LF2L/Green-FabLab/Images/Material/Tamisage/2019-05-12-0001.jpg

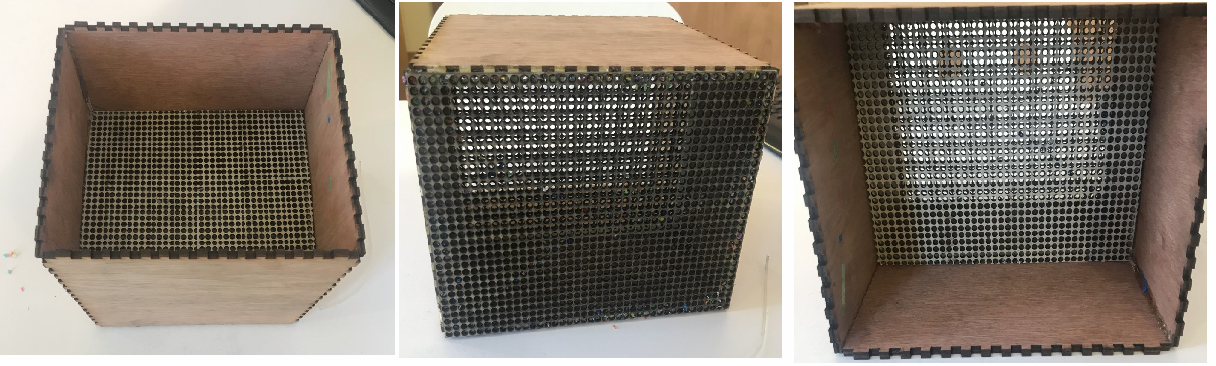
Images/Material/Tamisage/2019-05-12-0001.jpg
