LF2L/Green-FabLab/README.md

# Green-FabLab
Repository with documents and in order to develop the Green FabLab at LF2L
