LF2L/Green-FabLab/Documents/Posters/3-Eudes.pdf

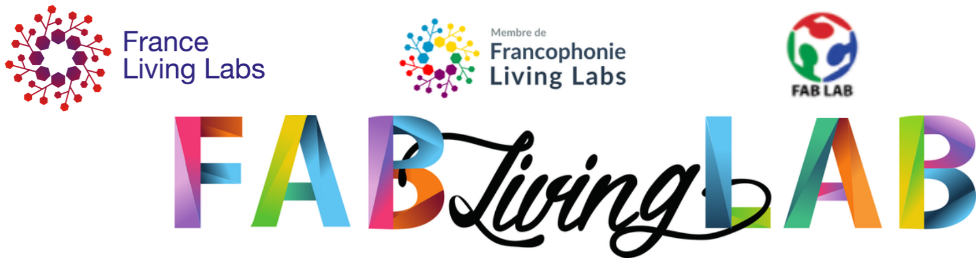
[picture p68: figure]

Comment automatiser et garantir une fiabilité du processus d’extrusion de granules de PLA recyclées ?

Aujourd’hui, l’impression 3D se démocratise et prend une part importante dans la nouvelle forme de production. Basée sur la fabrication additive (fines couches déposées une à une), les imprimantes 3D permettent d'avoir des délais de fabrications courts avec des formes complexes et sans nécessiter d'une fabrication de moules au préalable. Cette technologie dite « open source » consomme de la matière plastique vierge. Cependant, à l’heure actuelle, le problème des déchets plastiques est un enjeu majeur pour l’Europe et le monde. Le Lorraine Fab Living Lab, en concordance avec les directives européennes qui visent une économie circulaire a moyen terme, adopte une démarche verte et durable. Le souhait est de réutiliser ce plastique en le recyclant et en le régénérant sous forme de fil adéquate aux imprimantes 3D.

# Introduction

# 1. Objectifs et structure du projet

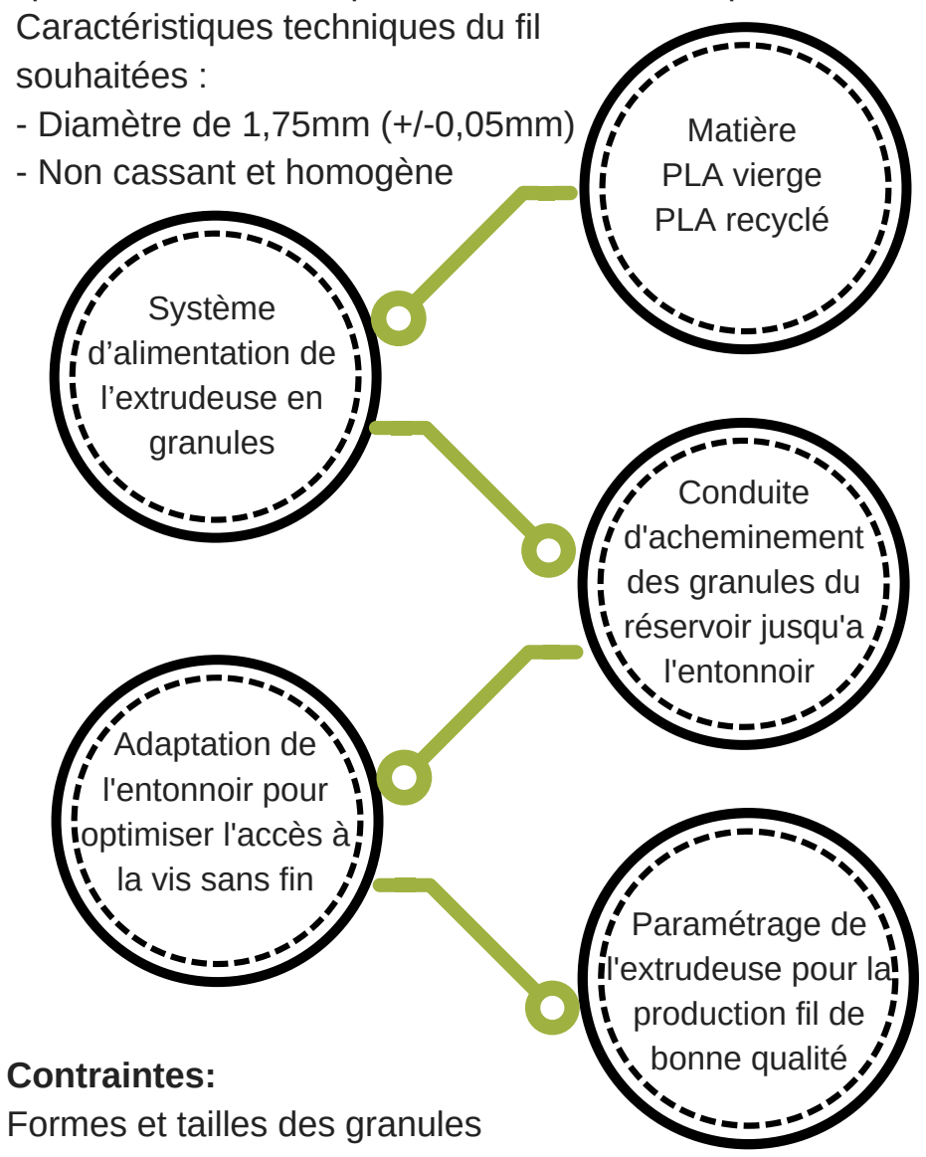
[picture p69: figure]
Système d’alimentation de l’extrudeuse en granules; Conduite d'acheminement des granules du réservoir jusqu'a l'entonnoir; Matière PLA vierge PLA recyclé; Adaptation de l'entonnoir pour optimiser l'accès à la vis sans fin; Paramétrage de l'extrudeuse pour la production fil de bonne qualité; Caractéristiques techniques du fil souhaitées : - Diamètre de 1,75mm (+/-0,05mm) - Non cassant et homogène; Contraintes: Formes et tailles des granules

# 2. Prise en main de l’extrudeuse

# 3. Modification du prototype

# 4. Résultats

Fiabiliser le processus de recyclage en garantissant la qualité de la matière première destinée à l'impression 3D.

Température importante à l’entrée de la chambre de la vis sans fin due à la conduction importante
Inclinaison de l’extrudeuse et forme de la bouche d’admission
Utilisation de ressources propres à un espace d'innovation Durée de l'étude (5 semaines d'Initiation à la Recherche) a) Changement de réservoir:

Réservoir avec un angle plus aigu afin de diminuer la contrainte mécanique latérale appliquée aux granules

Volume plus important afin de permettre une plus grande autonomie

b) Modification du bouchon de réservoir:
e) Mise un place d'un ventilateur 12V CC:

Ventilateur permettant de dissiper la chaleur transmise (conduction) par les résistantes chauffantes au niveau de l'entrée de la vis sans fin

Étude statistique:
Réalisée avec 1kg
de granules
Débit non linéaire
Démontre l'intérêt de
la présence d'une
LED et d'une
photorésistance

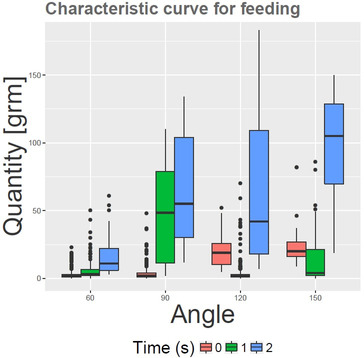
[picture p70: figure]

1ère bobine de fil extrudé 2ème bobine de fil extrudé

Impression 3D (test)

Présence de nombreuses
imperfections
T1: 165°C T2: 155°C
T3: 150°C V: 5rpm

Peu d'imperfections
présentes
T1: 170°C T2: 165°C
T3: 150°C V: 5rpm

Réalisation d'un modèle test avec l'imprimante 3D et la 2ème bobine de fil. C'est un succès!

Filtrer les
granules
recyclés

Rupture de
ponts
thermiques

Contrôle du
flux d'air

Lecture réelle
des
températures

Maintien du fil
dans l'axe du
capteur de
niveau

Canalisation d'acheminement des granules qui s'adapte aux différentes positions

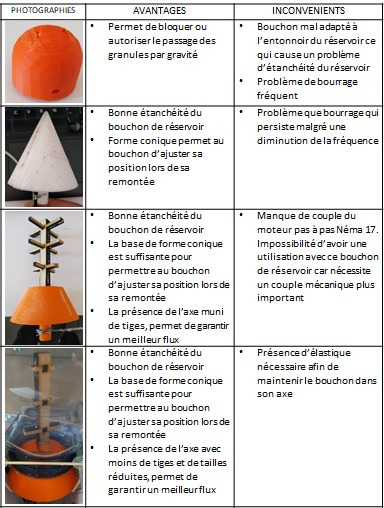
[picture p71: figure]

c) Positionnement moteur et transmission de force mécanique:
Utilisation de la rotation du moteur électrique pour réaliser un mouvement de translation (principe bielle -piston)
d) Modification de l'entonnoir:

Adapté à l'inclinaison de
l'extrudeuse (60°)
Optimisation de l'utilisation de la surface d'absorption des granules

Observations concernant le PLA recyclé:
Bourrages fréquents des granules dans le réservoir et mauvaise étanchéité du bouchon existant

Formation de blocs de granules sous l'effet de la température

Structure de l'entonnoir ne permettant pas une répartition optimale des granules au niveau de la bouche d'accès à la vis sans fin

Auteur : Eudes LE MAISTRE- eudes.lemaistre@viacesi.fr

# 6.Conclusion

# 5. Axes d'amélioration

# 7.Bibliographie

DropBox greenFablab. [En ligne]. https://www.dropbox.com/home/GreenFablab/Bibliography
BBFil. Extrudeuse Xcalibur. [En ligne]. http://www.bbfil.fr/extrudeuse-xcalibur-c2x22857729
noztek. noztek-xcalibur-manual. [En ligne]. http://www.noztek.com/wp-content/uploads/2015/09/noztek-xcalibur-manual.pdf

Le prototype a été modifié et optimisé afin de le rendre opérationnel. Aujourd'hui la régulation du débit est maîtrisée et les premières bobines de filaments 100% recyclés sont extrudées. Le prototype doit être consolidé d'avantage et son ergonomie est à améliorer. Un tamisage en sortie de broyeuse s'avère utile car le réglage des paramètres d'utilisation dépend fortement de la granulométrie du PLA recyclé.
Mettre en place une procédure de contrôle de la qualité du fil extrudé de façon à classifier ce dernier et à déterminer les paramétrages optimums de l'extrudeuse. A terme, le but est d’instaurer une norme qualité des fils extrudés à partir de PLA recyclé.
