LF2L/Green-FabLab/Concept Ideas/FicheIdéeStructure.pdf

### Connaissances, besoins ou problématique ayant donnés lieu à cette idée:

Le FabLivingLab souhaite pouvoir exposer le projet « Extrudeuse ». Cela nécessite une structure

Nom de l’idée : | Structure N°1

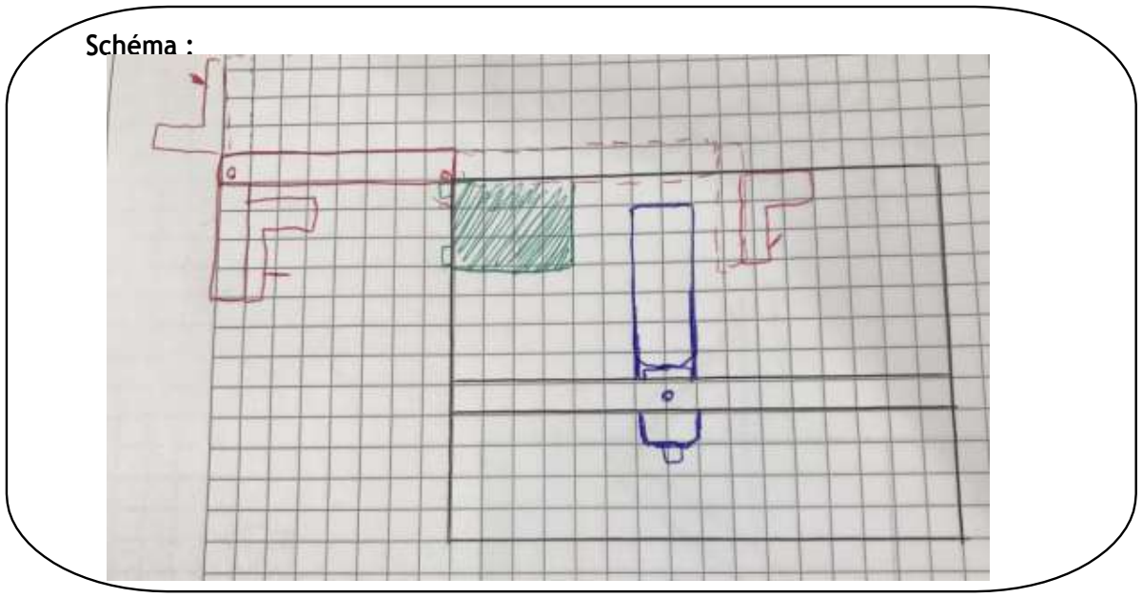
[picture p73: figure]
Schéma :
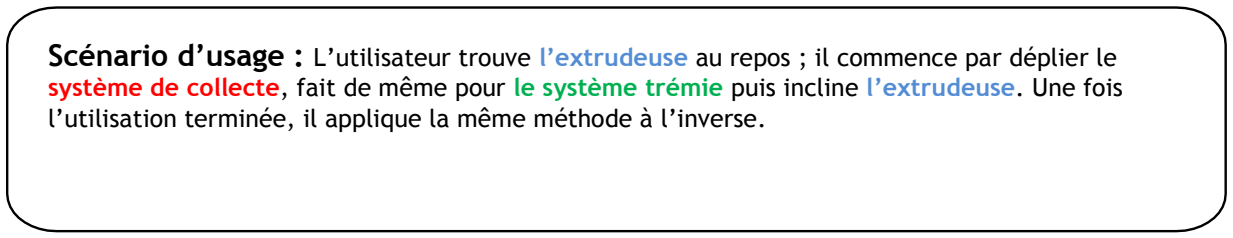
[picture p74: figure]

+ | -

Problématique : Comment optimiser l’ergonomie et l’esthétisme de la structure sans diminuer

Description : La structure doit permettre au système d’alterner entre deux positions :
« Repos » et « Fonctionnement ». L’extrudeuse serait réorientable à 90° de manière à occuper le moins de place possible. Le système de collecte serait repliable sur le dessus de la structure par le biais de charnières. Le système Trémie serait repliable sur le côté de la structure.

Scénario d’usage : L’utilisateur trouve l’extrudeuse au repos ; il commence par déplier le système de collecte, fait de même pour le système trémie puis incline l’extrudeuse. Une fois l’utilisation terminée, il applique la même méthode à l’inverse.

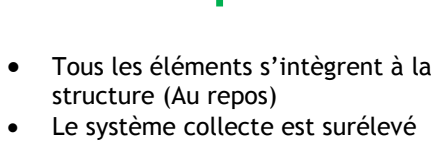
[picture p75: figure]
• Tous les éléments s’intègrent à la structure (Au repos) • Le système collecte est surélevé

- Le système collecte exerce une contrainte importante sur son point d’accroche avec la structure

### Connaissances, besoins ou problématique ayant donnés lieu à cette idée:

Le FabLivingLab souhaite pouvoir exposer le projet « Extrudeuse ». Cela nécessite une structure

Nom de l’idée : | Structure N°2

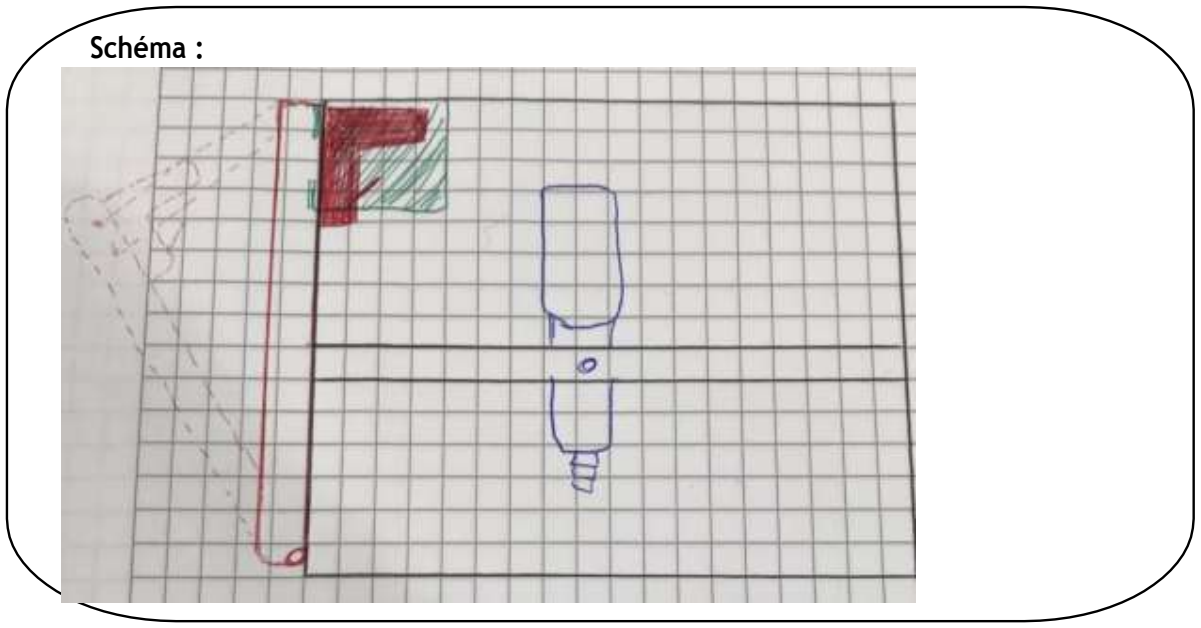
[picture p76: figure]
Schéma :

+ | -

Problématique : Comment optimiser l’ergonomie et l’esthétisme de la structure sans diminuer

Description : La structure doit permettre au système d’alterner entre deux positions : « Repos » et « Fonctionnement ». L’extrudeuse serait réorientable à 90° de manière à occuper le moins de place possible. Le système de collecte serait repliable sur l’avant de la structure (par le biais de charnières) et retenue par une ficelle. Le système Trémie serait repliable sur le côté extérieur de la structure afin de ne pas gêner le système collecte.

Scénario d’usage : L’utilisateur trouve l’extrudeuse au repos ; il commence par déplier le système de collecte, fait de même pour le système trémie puis incline l’extrudeuse. Une fois l’utilisation terminée, il applique la même méthode à l’inverse.

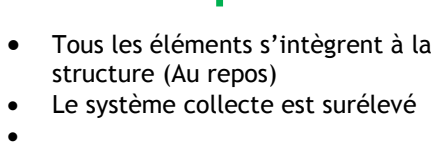
[picture p77: figure]
• Tous les éléments s’intègrent à la structure (Au repos) • Le système collecte est surélevé •
