LF2L/Green-FabLab/Concept Ideas/Fichesidées Système de collecte.pdf

### Connaissances, besoins ou problématique ayant donnés lieu à cette idée:

La partie « enrouleur » doit s’intégrer de manière ergonomique au support (de manière à être facilement transportable). Il doit cependant se situer à une certaine distance (inconnue à l’heure actuelle) de la sortie de l’extrudeuse afin d’optimiser l’enroulement.

Nom de l’idée :

Problématique : Comment optimiser l’ergonomie et le fonctionnement de la partie
« Enrouleur » ?

Support Enrouleur n°1

### Schéma :

Description: Le système consiste en un rail qui permet à l’enrouleur d’alterner entre deux positions : -une position d’utilisation (devant la sortie de l’extrudeuse)
-une position de « repos » (sous l’extrudeuse)

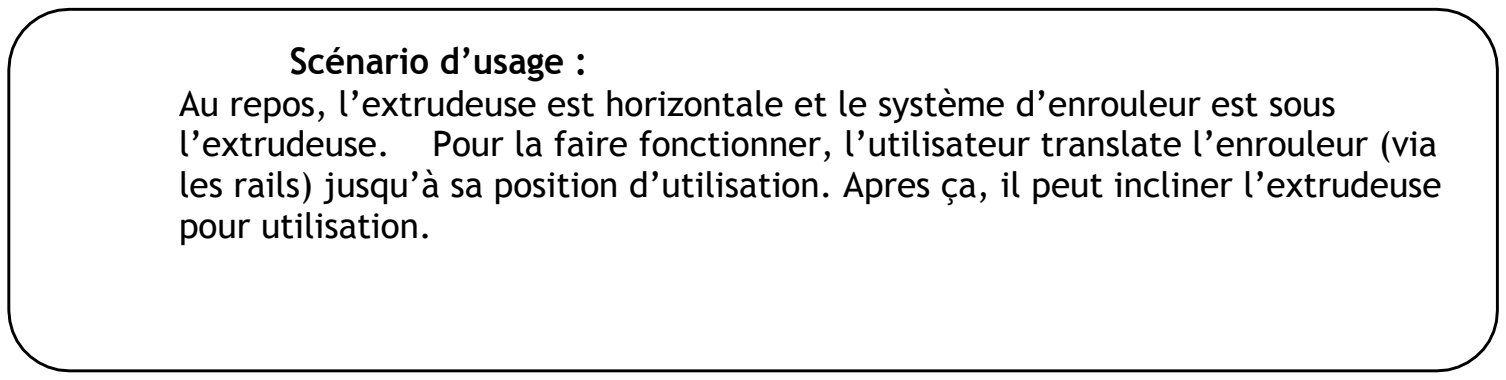
[picture p78: figure]
Scénario d’usage :; pour utilisation.

Au repos, l’extrudeuse est horizontale et le système d’enrouleur est sous l’extrudeuse. Pour la faire fonctionner, l’utilisateur translate l’enrouleur (via les rails) jusqu’à sa position d’utilisation. Apres ça, il peut incliner l’extrudeuse

+ | - • Alignement fixe • Pas de position « repos » quand l’extrudeuse est à 60°

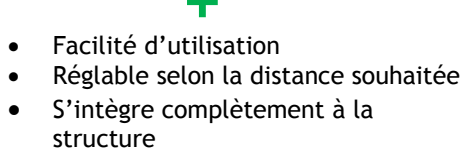
[picture p79: figure]
• Facilité d’utilisation • Réglable selon la distance souhaitée • S’intègre complètement à la structure

### Connaissances, besoins ou problématique ayant donnés lieu à cette idée:

La partie « enrouleur » doit s’intégrer de manière ergonomique au support (de manière à être facilement transportable). Il doit cependant se situer à une certaine distance (inconnue à l’heure actuelle) de la sortie de l’extrudeuse afin d’optimiser l’enroulement.

Nom de l’idée :

Problématique : Comment optimiser l’ergonomie et le fonctionnement de la partie
« Enrouleur » ?

Support Enrouleur n°2

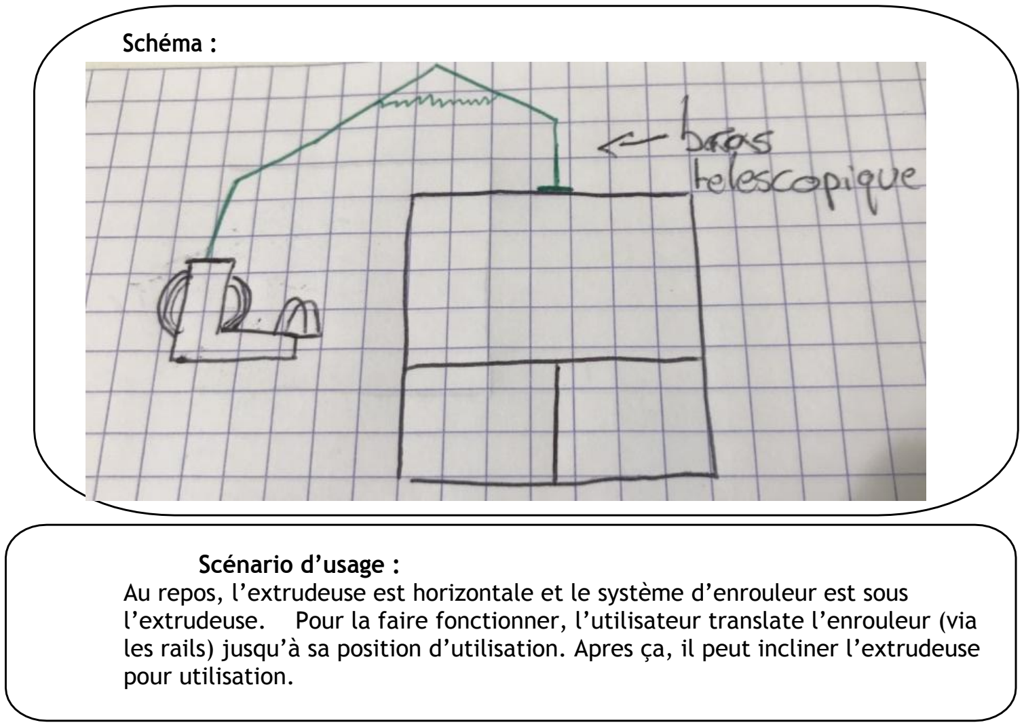
[picture p80: figure]
Schéma :; Scénario d’usage :; pour utilisation.

Au repos, l’extrudeuse est horizontale et le système d’enrouleur est sous l’extrudeuse. Pour la faire fonctionner, l’utilisateur translate l’enrouleur (via les rails) jusqu’à sa position d’utilisation. Apres ça, il peut incliner l’extrudeuse

Description: Le système consiste en un support amovible (par le biais d’un bras articulé) qui permet à l’enrouleur d’alterner entre deux positions :
-une position d’utilisation (devant la sortie de l’extrudeuse)
-une position de « repos » (sous l’extrudeuse)

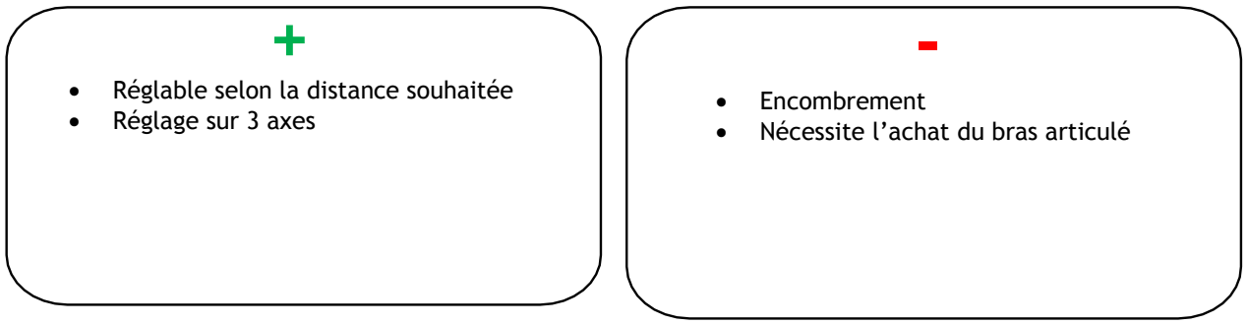
[picture p81: figure]
• Réglable selon la distance souhaitée • Réglage sur 3 axes; • Encombrement • Nécessite l’achat du bras articulé

### Connaissances, besoins ou problématique ayant donnés lieu à cette idée:

La partie « enrouleur » doit s’intégrer de manière ergonomique au support (de manière à être facilement transportable). Il doit cependant se situer à une certaine distance (inconnue à l’heure actuelle) de la sortie de l’extrudeuse afin d’optimiser l’enroulement.

Nom de l’idée :

Problématique : Comment optimiser l’ergonomie et le fonctionnement de la partie
« Enrouleur » ?

Support Enrouleur n°3

### Schéma :

Description: Le système consiste en un support amovible qui permet à l’enrouleur d’alterner entre deux positions :
-une position d’utilisation (devant la sortie de l’extrudeuse)
-une position de « repos » (sous l’extrudeuse)

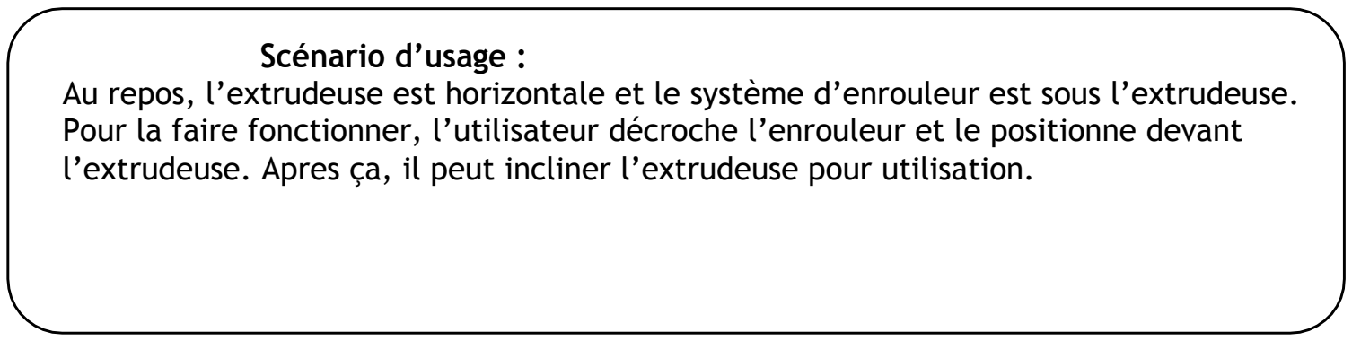
[picture p82: figure]
Scénario d’usage :

Au repos, l’extrudeuse est horizontale et le système d’enrouleur est sous l’extrudeuse. Pour la faire fonctionner, l’utilisateur décroche l’enrouleur et le positionne devant l’extrudeuse. Apres ça, il peut incliner l’extrudeuse pour utilisation.

+ | -
Position “repos” | Position “fonctionnement”

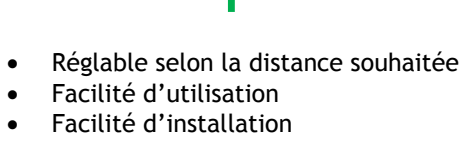
[picture p83: figure]
• Réglable selon la distance souhaitée • Facilité d’utilisation • Facilité d’installation

- Totalement libre en position d’utilisation (possibilité d’oubli)
- Pas de position « repos » quand l’extrudeuse est à 60°

### Connaissances, besoins ou problématique ayant donnés lieu à cette idée:

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

Nom de l’idée :

Problématique : Comment optimiser l’ergonomie et le fonctionnement de la partie
« Enrouleur » ?

Support Enrouleur n°4

### Schéma :

Description: Le système consiste en un support amovible (par le biais de charnières) qui permet à l’enrouleur d’alterner entre deux positions :
-une position d’utilisation (devant la sortie de l’extrudeuse)
-une position de « repos » (sous l’extrudeuse)

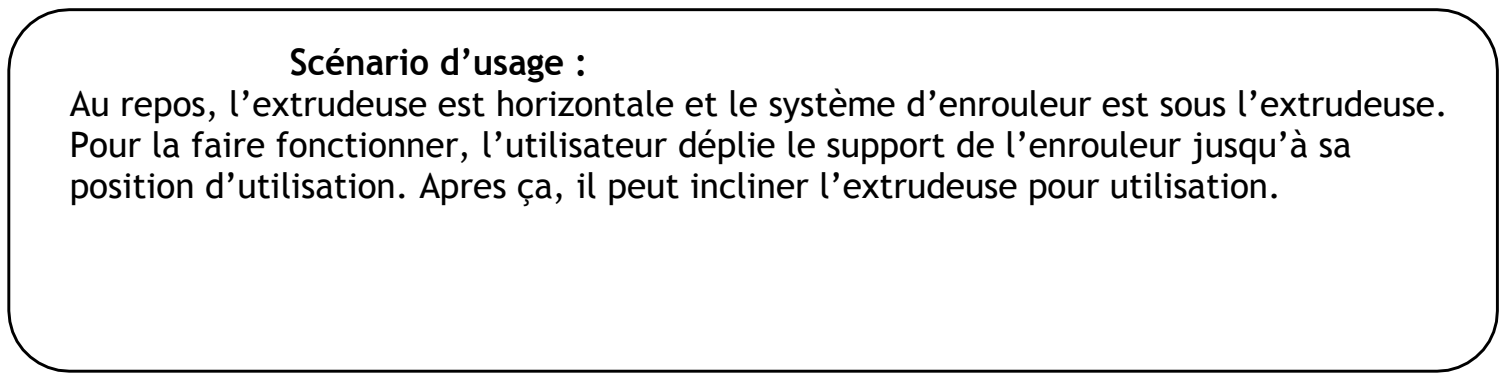
[picture p84: figure]
Scénario d’usage :

Au repos, l’extrudeuse est horizontale et le système d’enrouleur est sous l’extrudeuse. Pour la faire fonctionner, l’utilisateur déplie le support de l’enrouleur jusqu’à sa position d’utilisation. Apres ça, il peut incliner l’extrudeuse pour utilisation.

+ | - • Pas de position « repos » quand l’extrudeuse est à 60° • Impossibilité d’alterner les positions dans un espace étroit

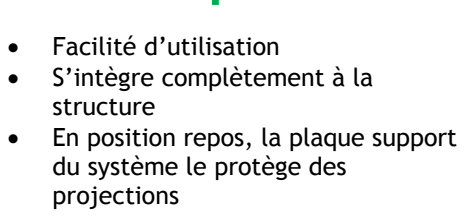
[picture p85: figure]
• Facilité d’utilisation • S’intègre complètement à la structure • En position repos, la plaque support du système le protège des projections

### Connaissances, besoins ou problématique ayant donnés lieu à cette idée:

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

Nom de l’idée :

Problématique : Comment optimiser l’ergonomie et le fonctionnement de la partie
« Enrouleur » ?

Support Enrouleur n°5

Description: Le système consiste en un support amovible (par le biais de charnières) qui permet à l’enrouleur d’alterner entre deux positions :
-une position d’utilisation (devant la sortie de l’extrudeuse)
-une position de « repos » (sur le support de l’extrudeuse)

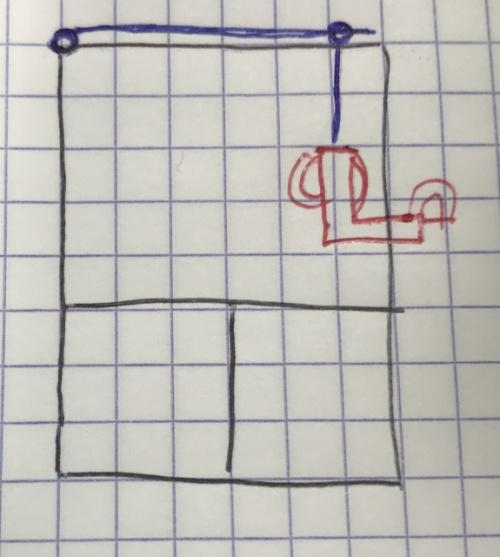
[picture p86: figure]
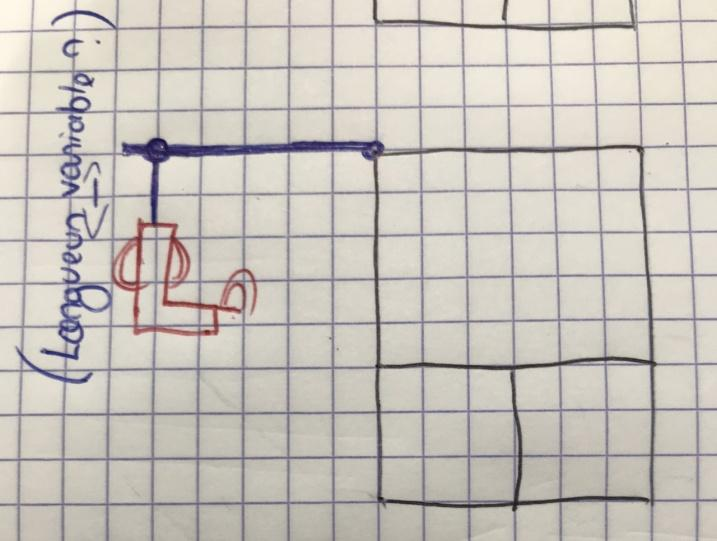
[picture p87: figure]
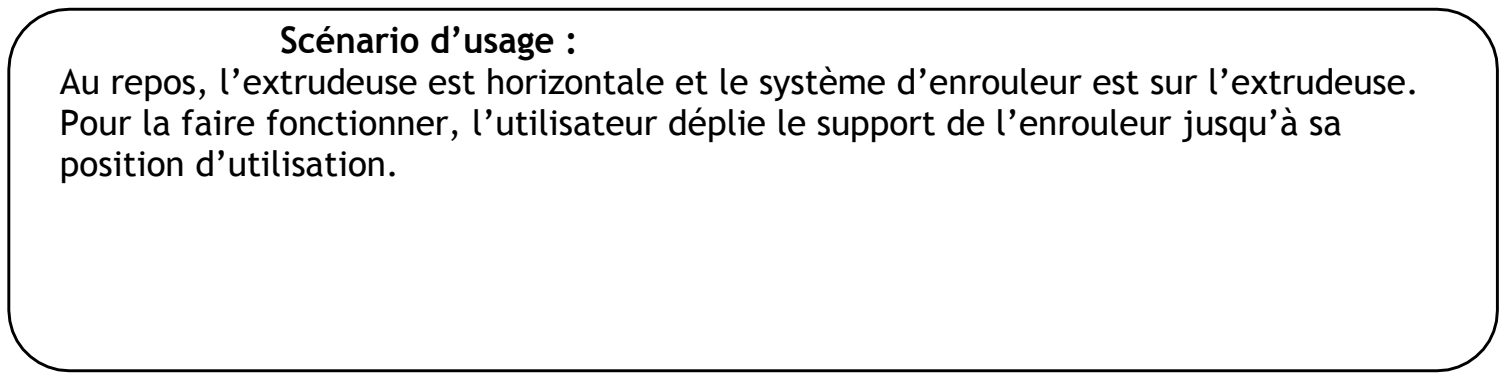
[picture p88: figure]
Scénario d’usage :; position d’utilisation.

Au repos, l’extrudeuse est horizontale et le système d’enrouleur est sur l’extrudeuse. Pour la faire fonctionner, l’utilisateur déplie le support de l’enrouleur jusqu’à sa

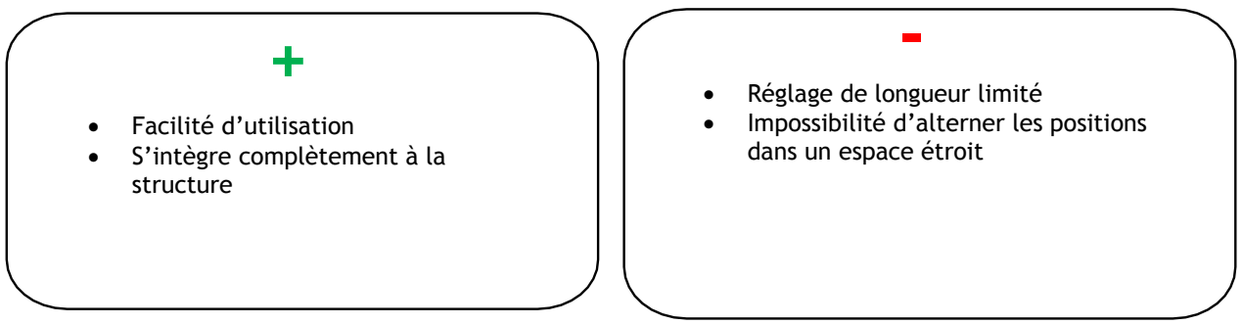
[picture p89: figure]
• Facilité d’utilisation • S’intègre complètement à la structure; • Réglage de longueur limité • Impossibilité d’alterner les positions dans un espace étroit
