LF2L/Green-FabLab/Documents/Posters/2-Nicolas-Maxime.pdf

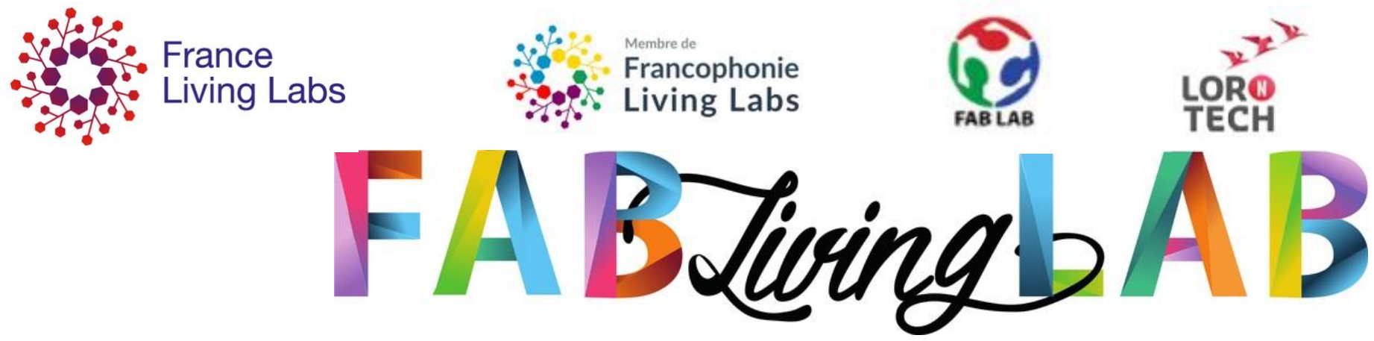
[picture p122: figure]

# Commentalimenterdefaçonautonomeuneextrudeuseengranulésplastiques recycléspour la fabrication de filament d’impression 3D ?

# Introduction

Aujourd’hui, l’impression 3D se démocratise. En parallèle, l’engouement créé par ce procédé de fabrication, dit « open-source », provoque une surconsommation plastique chez le particulier et dans les Fablab. Cette surconsommation est un risque pour nos écosystèmes, risque que nous devons compenser grâce au recyclage de nos déchets plastiques. L’extrudeuse et la broyeuse plastique permettent de réutiliser les prototypes d’imprimante 3D en les transformant en bobines de filament.

# 1. Contexte etdocumentation

Intégrer les notions et les
enjeux du projet :
- Thèses
- Articles scientifiques
- Échanges avec les
spécialistes

Se renseigner sur ce qui
existe :
- Open source
(Precious plastic,
Nozteck)
- YouTube
- ThingVerse
3. ConceptionPrototypage | 5. Modèle théorique

# 2. Créativité

2) Afin d’imaginer le concept, nous avons appliqué les étapes de la créativité :
- Brainstorming

Nous avons proposé des
dizaines de mots clefs, en rapport avec le projet, que nous avons rassemblés en
catégories.

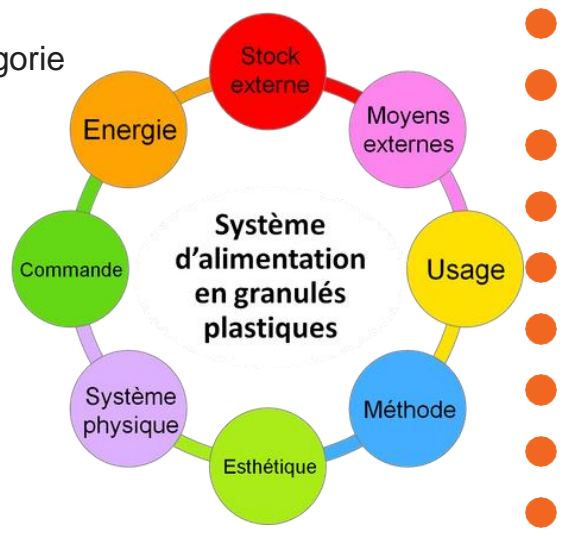
[picture p123: figure]

- Regroupement en catégorie

Les catégories nous ont
permis de visualiser
rapidement les relations
qu'elles ont avec notre
système
- Création de fiches idée
- Choix du concept en utilisant plusieurs fichesidée

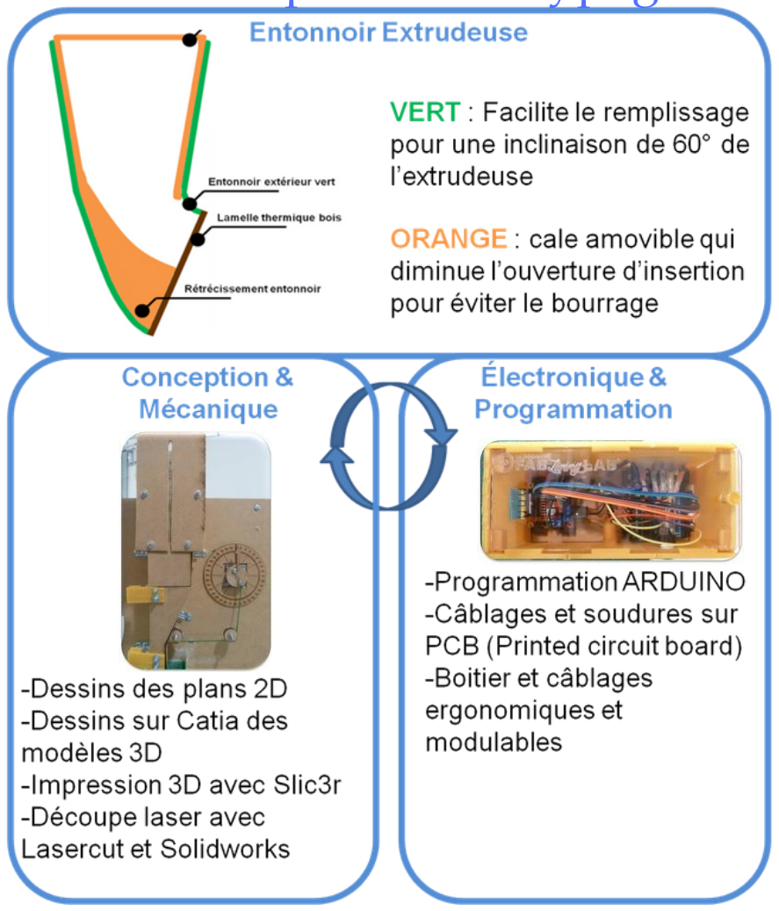
[picture p124: figure]

# 4. Schéma du système

1. Démarrage et arrêt du système par appui sur un bouton
2. Capter la présence de granulés au niveau de la vis d’extrusion grâce aux modules photorésistance & LED
3. Mise en route du moteur pour actionner l’ouverture de façon contrôlée
4. Rotation du moteur selon un angle calculé
5. Enroulement du câble
6. Translation verticale du bouchon
7. Ouverture du réservoir et chute des granulés

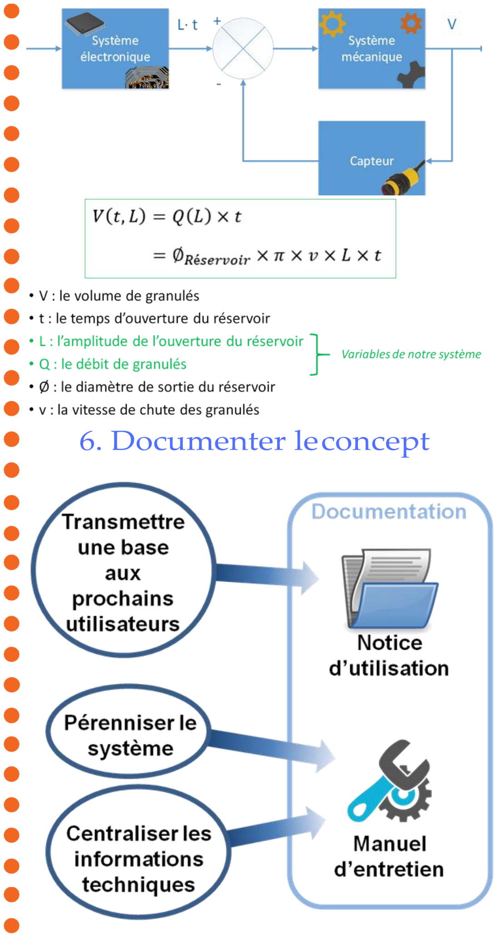
[picture p125: figure]
6. Documenter leconcept

# Perspectives

- Définir la position du capteurau niveau du blocage del'entonnoir.
- Calibrer la commande d'angle dans le programme
- Consolider le mécanisme
- Intégrer le prototype dans la cabine

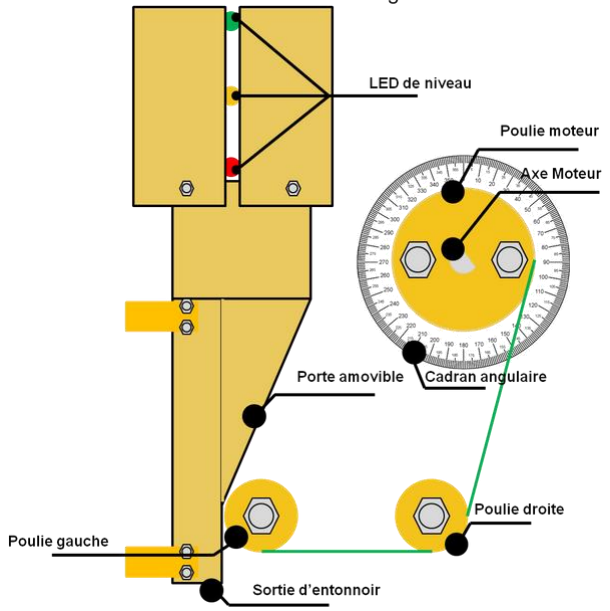
[picture p126: figure]

Bibliographie | Bilan :

CRUZ SANCHEZ, Fabio Alberto, 2016, Methodological proposition to evaluate polymer recycling in open-source additive manufacturing contexts. Thesis. Industrial Engineering. University of Lorraine, École doctorale RP2E.

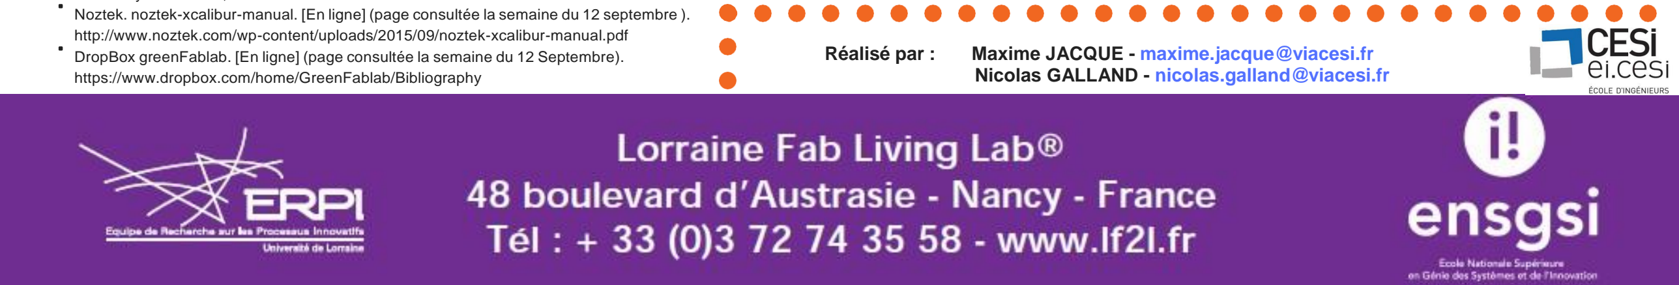
[picture p127: figure]

Noztek. noztek-xcalibur-manual. [En ligne] (page consultée la semaine du 12 septembre ). http://www.noztek.com/wp-content/uploads/2015/09/noztek-xcalibur-manual.pdf

### 5 semaines pour découvrir le monde de la recherche :

- Échange permanent avec les docteurs disponibles Application d'une méthode scientifique et conception créative :
- Liberté totale du choix de la méthode pour créer un système

DropBox greenFablab. [En ligne] (page consultée la semaine du 12 Septembre). https://www.dropbox.com/home/GreenFablab/Bibliography

Réalisé par : Maxime JACQUE - maxime.jacque@viacesi.fr Nicolas GALLAND - nicolas.galland@viacesi.fr
