LF2L/Green-FabLab/Safety/Analyse de risque_V1 .pdf

NOM DU SITE : | Lorraine Fab Living Lab
EVALUATION DES RISQUES | Evaluation No.
Page | de
QUI POURRAIT ETRE BLESSE? | | CIRCONSTANCES | RAISON DE L'EVALUATION
Evaluation Date: 16/10/2018 | Derniere évaluation Date: | | Info complémentaire :

Première évaluation
Employés | X | Normal, habituel | X
Sous-traitant | Inhabituel | Révision
Personne avec handicap | Maintenance
Jeune, inexpérimenté | Dépannage | Modification du process
Autre salarié | Travaux d'arret
Public | Projet | Après un accident
Visteur | Urgence
approximatif par équipe | Autre | Après un incident
Nombre de personnes
exposées? | Après un presqu'accident

## Identification des dangers potentiels

Dangers potentiels | Cotation | Dangers potentiels | Cotation
Risque Total | Risque Total
1 Déplacement dangereux,
chute de plain pied, glissade.. | OUI | NON | 3 | 4 | 12 | 3 | 5 Equipements électriques | OUI | NON | 3 | 4 | 12 | 3
2 | Chute d'objets | OUI | NON | 3 | 3 | 9 | 3 | Installations électriques | OUI | NON | 0
Manutention manuelle | OUI | NON | 0 | Air comprimé | OUI | NON | 0
Levage mécanique | OUI | NON | 0 | Appareils sous pression | OUI | NON | 0
Espaces confinés | OUI | NON | 0 | Mauvais éclairage | OUI | NON | 0
Hautes, basses Températures | OUI | NON | 0 | Chutes de hauteur | OUI | NON | 0
3 | Objets chauds | OUI | NON | 3 | 2 | 6 | 6 Ergonomie | OUI | NON | 2 | 2 | 4 | 2
Irritation de la peau | OUI | NON | 0
OUI | NON | 0
Blessures à l'oeil - Laser | OUI | NON | 0
OUI | NON | 0
Blessures à l'œil - Non Laser | OUI | NON | 0
OUI | NON | 0
Bruit | OUI | NON | 0
sous total | 16 | 5
Vibrations | OUI | NON | 0 | NOTE : Cotation risque, O x G = Occurrence x Gravité
4 | Fumées, vapeurs, poussières | OUI | NON | 3 | 2 | 6 | 3
Rayonnement Laser | OUI | NON | 0
Substances dangereuses | OUI | NON | 0
Gaz inflammables | OUI | NON | 0
Matériaux combustibles | OUI | NON | 0

Energies stockées:

Électrique | OUI | NON | 0
Non-électrique | OUI | NON | 0
sous total | 33 | 9

Note à l'attention des employés:
Il est de votre devoir d'informer l'employeur de toute situation qui pourrait entrainer une modification dans cette évaluation
Occurrence | Improbable | 1 | Possible | 2 | Probable | 3 | Très probable | 4 Cotation | Certain | 5
Gravité | Nul | 1 Cotation | Léger | 2 | Modéré | 3 | Elevé | 4 | Extrême | 5

Autres

Apres
action
O x G

X

O x G

Apres
action

Extrusion de granule de plastiques

6

Laboratoire :

Est-ce un
danger?

Lorraine Fab Living Lab

Est-ce un
danger?

Plus forte note d'évaluation de risque unitaire | Somme de toutes les évaluations de risque
avant mise en œuvre actions | avant mise en œuvre actions
Rechercher actions pour tout risque individuel évalué > 9
lorsque la somme de tous les risques est > 30
| Action | Responsable
1 | Risque de chute (filament) Action : Trouver un système où si on doit intervenir sur l'enrouleuse, le filament ne soit pas à hauteur des pieds pour éviter de se prendre les pieds dans le filament. | Lorraine Fab Living Lab
2 | Risque de chute du système d'alimentation et de l'extrudeuse Action : Trouver un système d'accroche plus robuste. Actuellement de la ficelle pour tenir le système d'almentation. Il est important de trouver un système d'acroche pour éviter le risque de chute. | Lorraine Fab Living Lab
3 | Risque de brûlure au niveau de l'extrudeuse Action : Mettre des gants de protection (Gant contre la chaleur) pour manipuler l'extrudeuse quand elle est en fonctionnement. | Lorraine Fab Living Lab
4 | Risque de vapeur/poussière plastique Action : Mettre en place un système de ventilation et respecter le code du travail concernant l'aération d'un espace de travail. | Lorraine Fab Living Lab
5 | Risque de prendre un coup d'électricité Action : Mettre les fils dans un boîtier de rangement | Lorraine Fab Living Lab
6 | Risque posture Action : Mettre à hauteur ergononomique l'extrudeuse, le système d'alimentation et l'enrouleuse. | Lorraine Fab Living Lab
| Si nécessaire, adjoindre page supplémentaire reliée à celle-ci
Exigences de formation:
A

B

C

D

| Si nécessaire, adjoindre page supplémentaire reliée à celle-ci
Evalué par : (Nom de la personne competente en RA) | (Signature de la personne competente en RA) | Evaluation approuvée : (Signature du Chef de département de l'entite)
Plus forte note d'évaluation de risque unitaire apres mise en œuvre actions | | Somme de toutes les évaluations de risques apres mise en œuvre actions

Prochaine date de révision:

Date revue: | Revu par: nom/fonction | signature
Date revue: | Revu par: nom/fonction | signature
Date revue: | Revu par: nom/fonction | signature

12 33

### 1. Déplacement dangereux, chute de plain pied, glissade

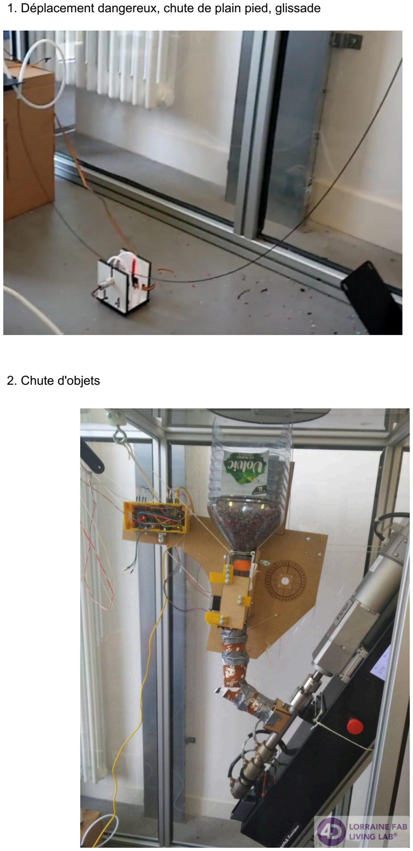
[picture p128: page 3]

### 2. Chute d'objets

### 3. Objets chauds

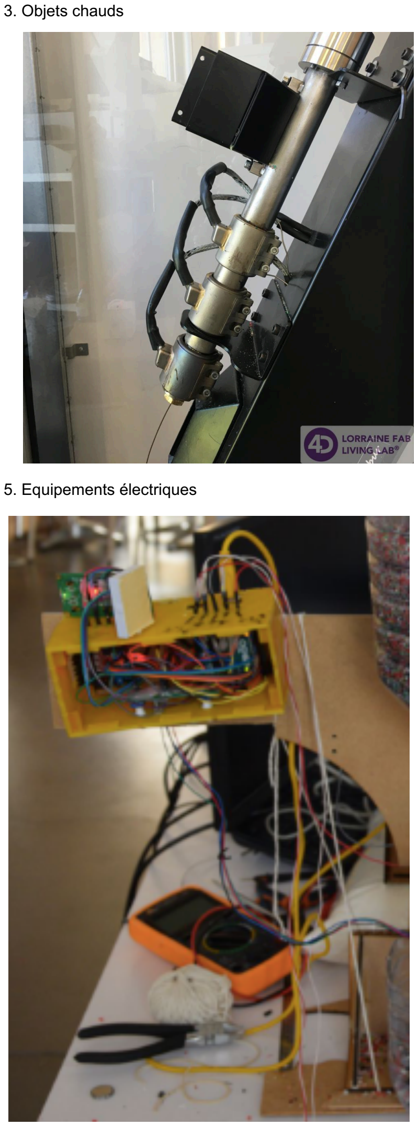
[picture p129: page 4]

### 5. Equipements électriques
