LF2L/Green-FabLab/Images/Collection/2019-05-12-0003.jpg

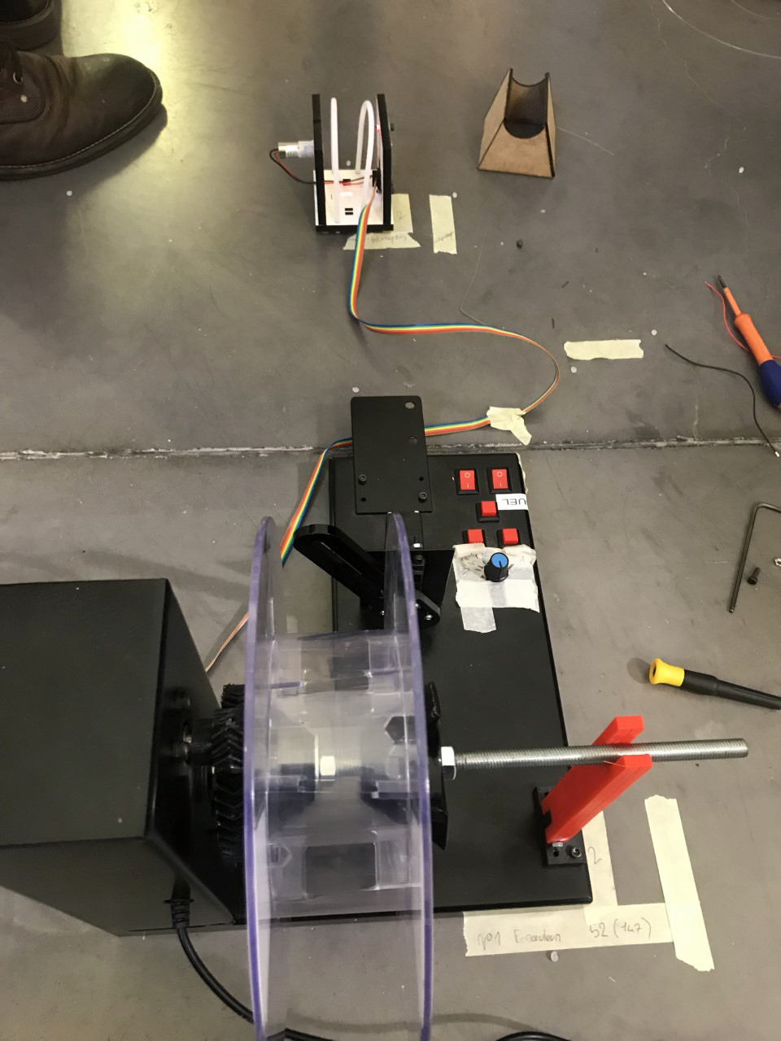
Images/Collection/2019-05-12-0003.jpg
