LF2L/Green-FabLab/Images/Collection/Sensor/2019-05-12-0001.jpg

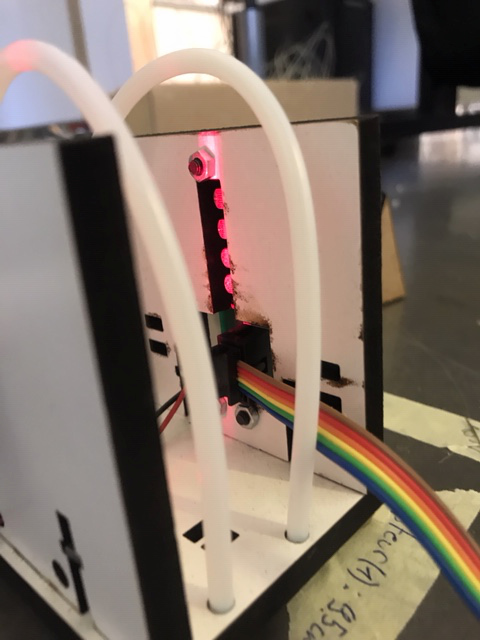
Images/Collection/Sensor/2019-05-12-0001.jpg
