LF2L/Green-FabLab/Images/Extrusion/Entonnoir/2019-05-0016.jpg

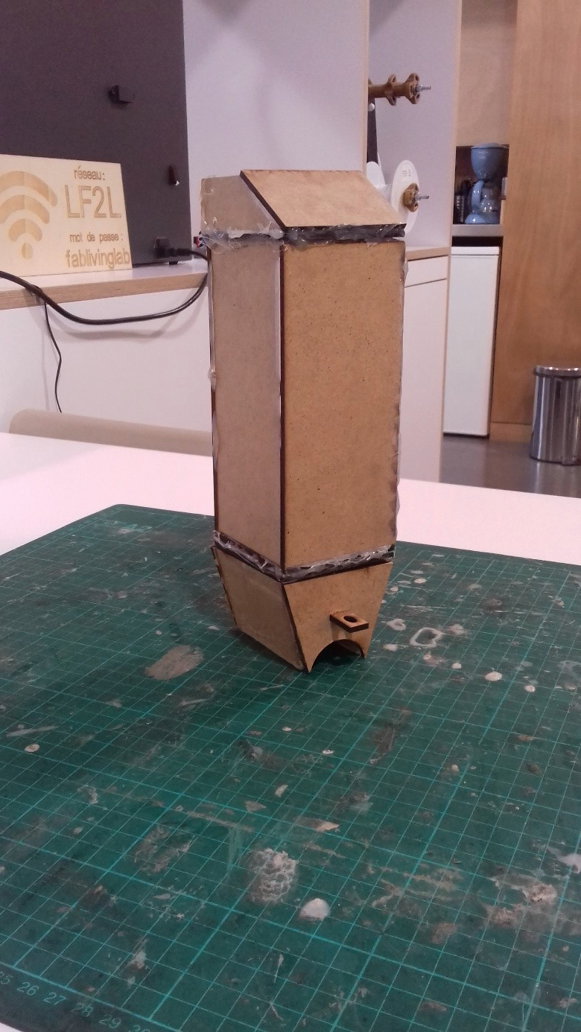
Images/Extrusion/Entonnoir/2019-05-0016.jpg
