LF2L/Green-FabLab/Images/Extrusion/Entonnoir/2019-05-0033.jpg

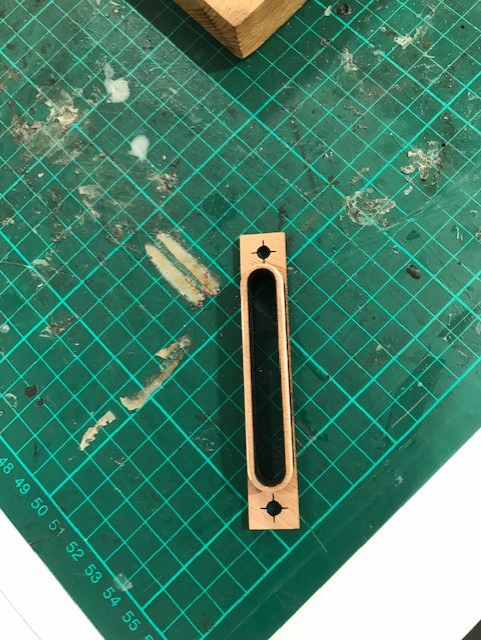
Images/Extrusion/Entonnoir/2019-05-0033.jpg
