LF2L/Green-FabLab/Images/Extrusion/Entonnoir/2019-05-0038.jpg

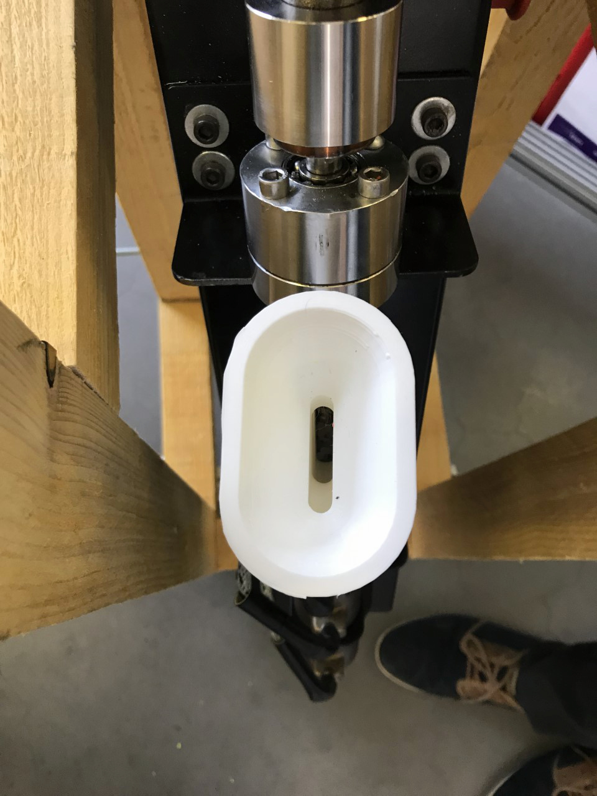
Images/Extrusion/Entonnoir/2019-05-0038.jpg
