LF2L/Green-FabLab/Images/Extrusion/Extruder/2019-05-12-0001.jpg

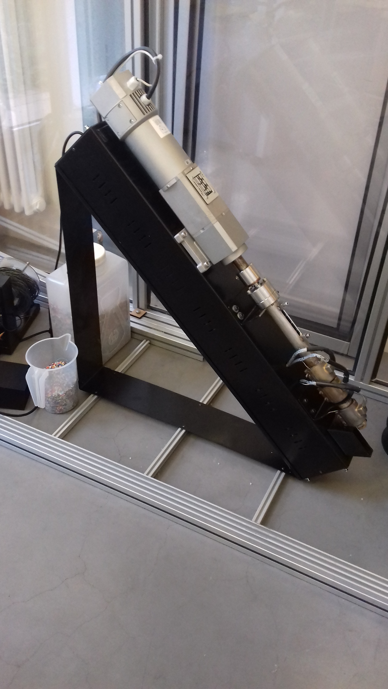
Images/Extrusion/Extruder/2019-05-12-0001.jpg
