LF2L/Green-FabLab/Images/Extrusion/Extrusion-process.jpg

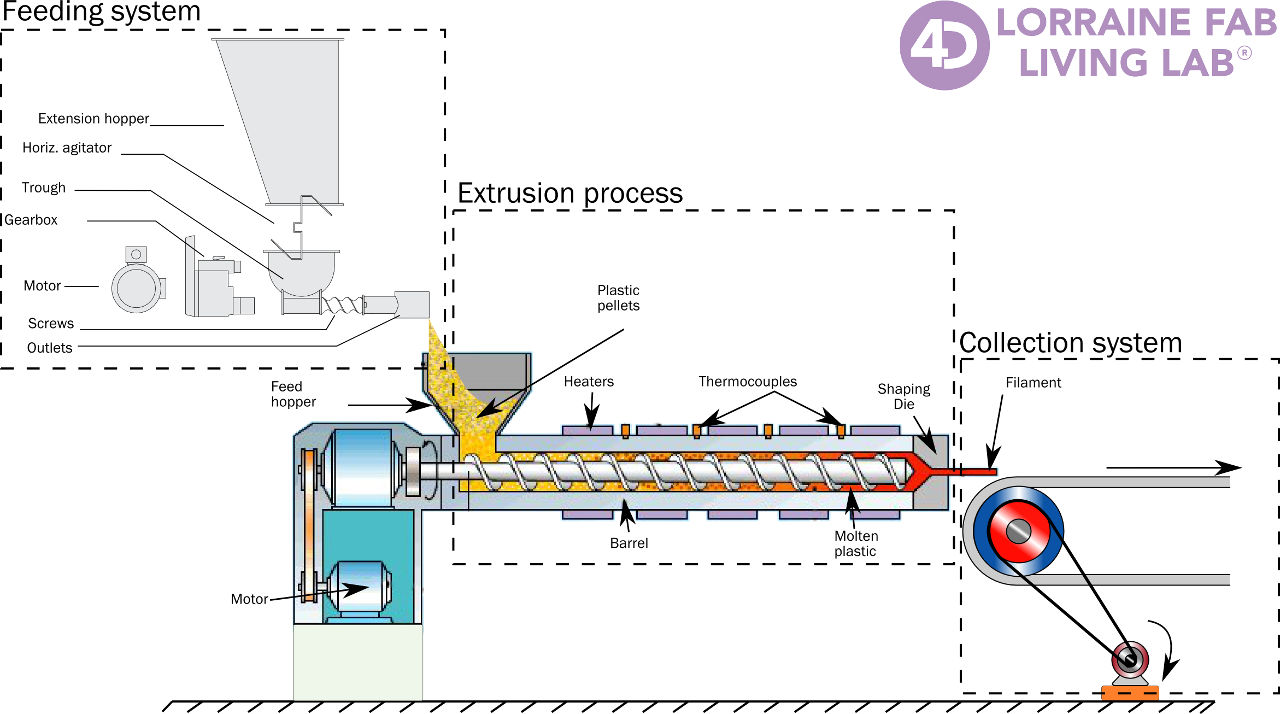
Images/Extrusion/Extrusion-process.jpg
