LF2L/Green-FabLab/Images/Feeding/2019-05-12-0003.jpg

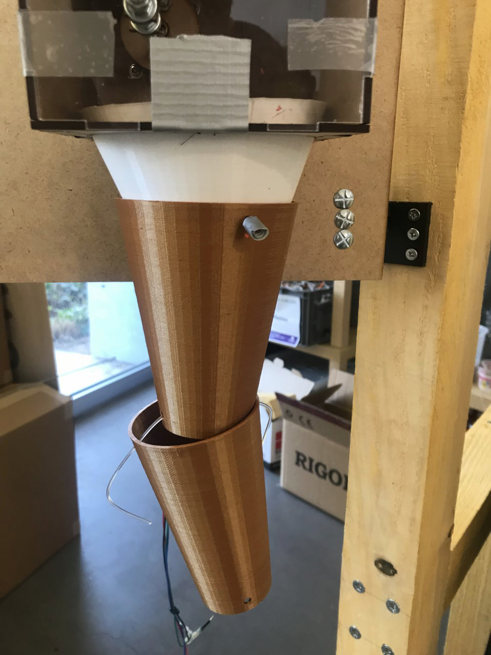
Images/Feeding/2019-05-12-0003.jpg
