LF2L/Green-FabLab/Images/Feeding/Feeding-System.jpg

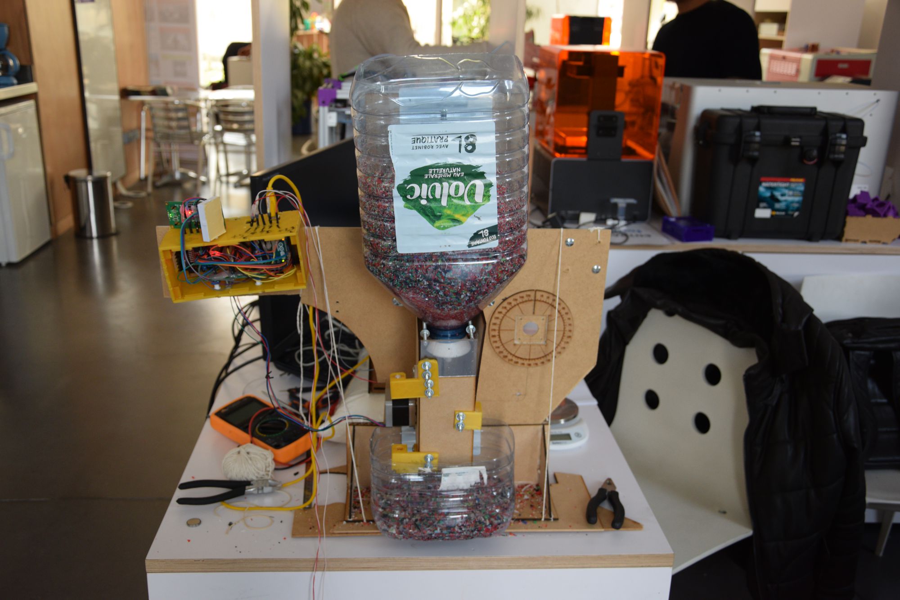
Images/Feeding/Feeding-System.jpg
