LF2L/Green-FabLab/Images/Filaments/2019-05-12-0001.jpg

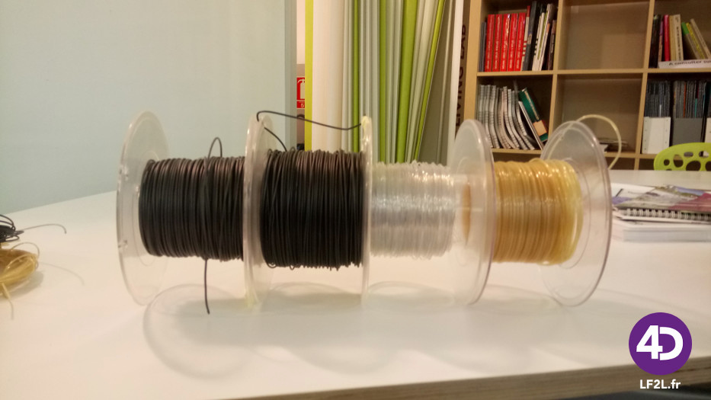
Images/Filaments/2019-05-12-0001.jpg
