LF2L/Green-FabLab/Images/Filaments/2019-05-12-0002.jpg

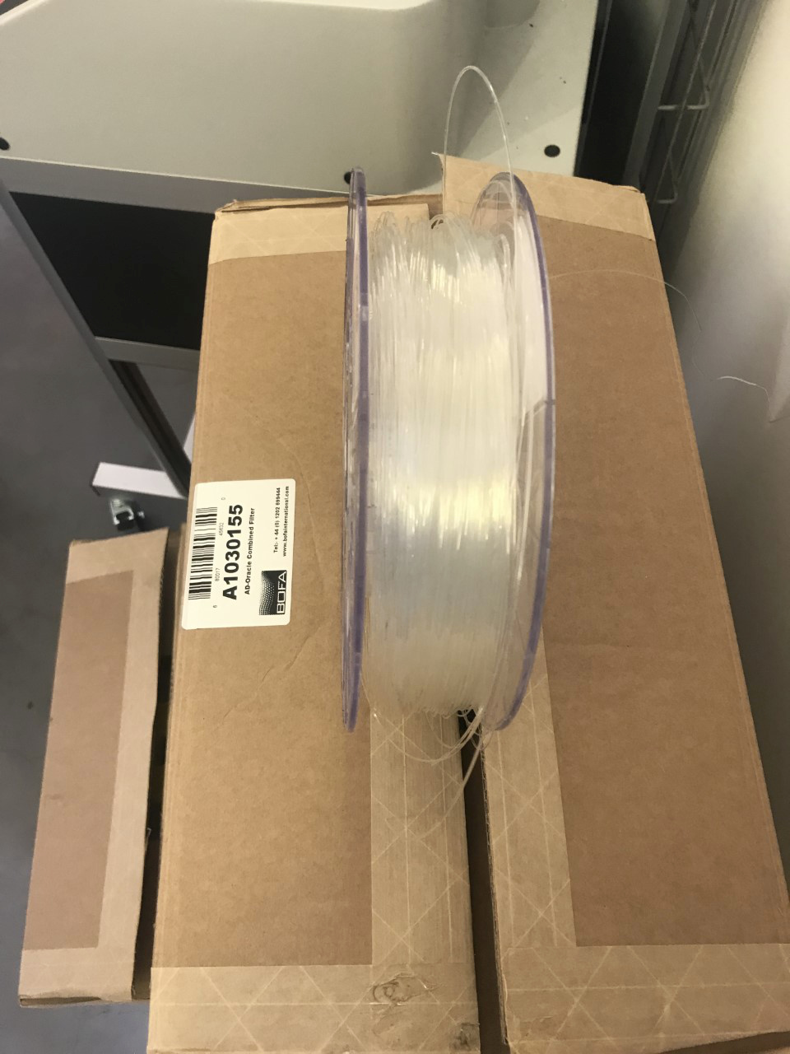
Images/Filaments/2019-05-12-0002.jpg
