LF2L/Green-FabLab/Images/Others/holoprest/LF2L-GF-Holipresse-0006.jpg

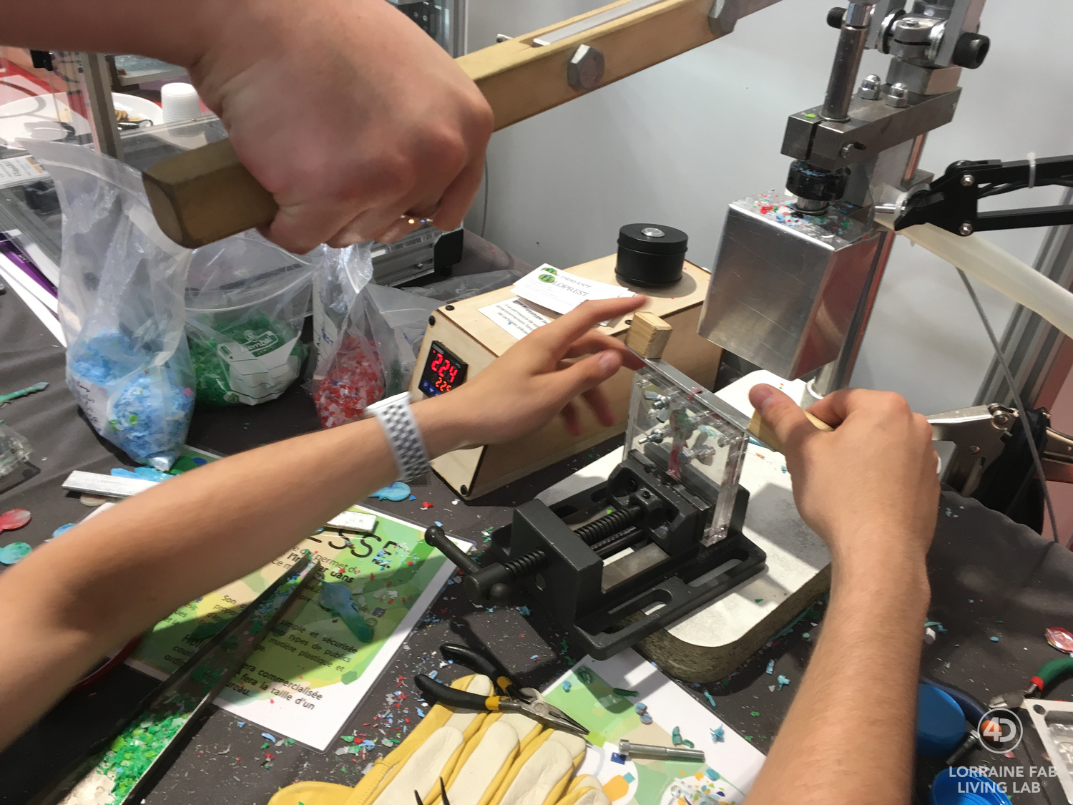
Images/Others/holoprest/LF2L-GF-Holipresse-0006.jpg
