LF2L/Green-FabLab/Images/Others/holoprest/LF2L-GF-Holipresse-0008.jpg

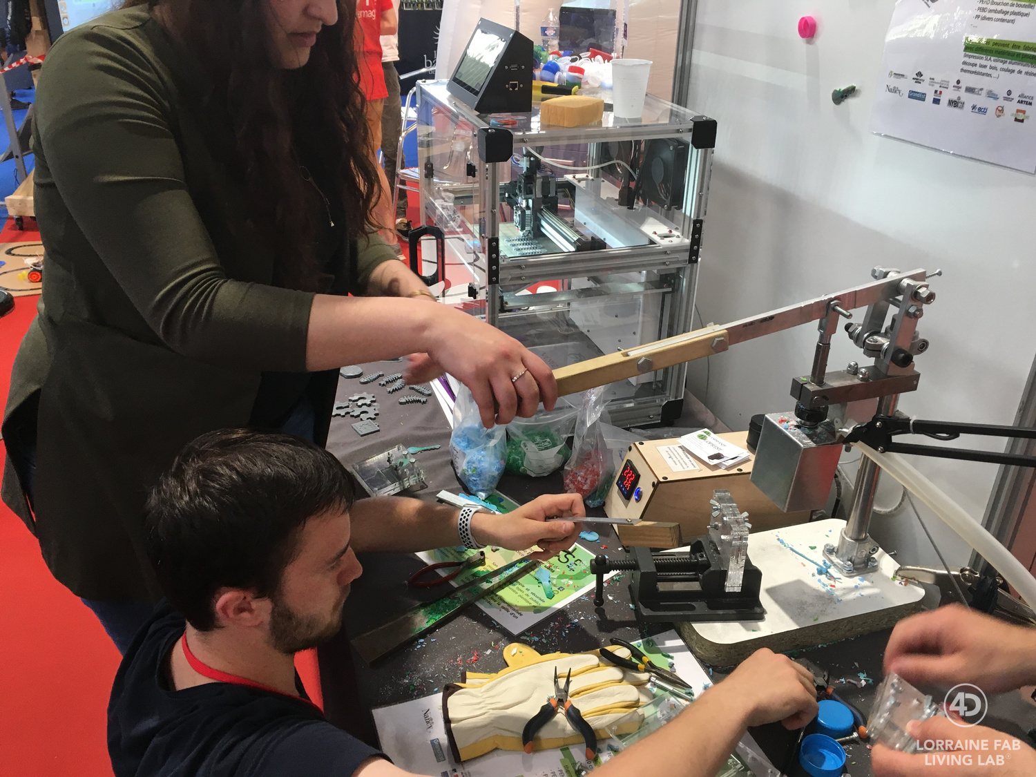
Images/Others/holoprest/LF2L-GF-Holipresse-0008.jpg
