LF2L/Green-FabLab/Images/Others/holoprest/LF2L-GF-Holipresse-0011.jpg

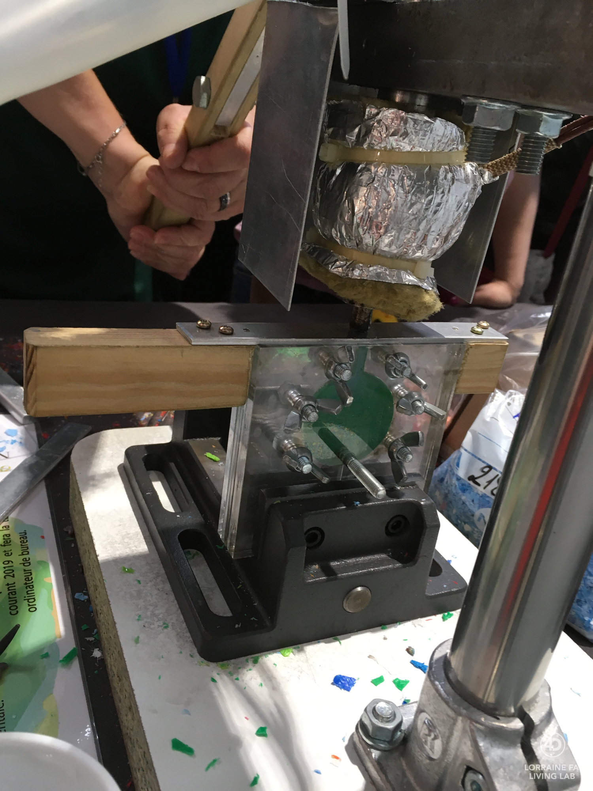
Images/Others/holoprest/LF2L-GF-Holipresse-0011.jpg
