LF2L/Green-FabLab/Images/Others/JE/Fabcity-LF2L-0003.jpg

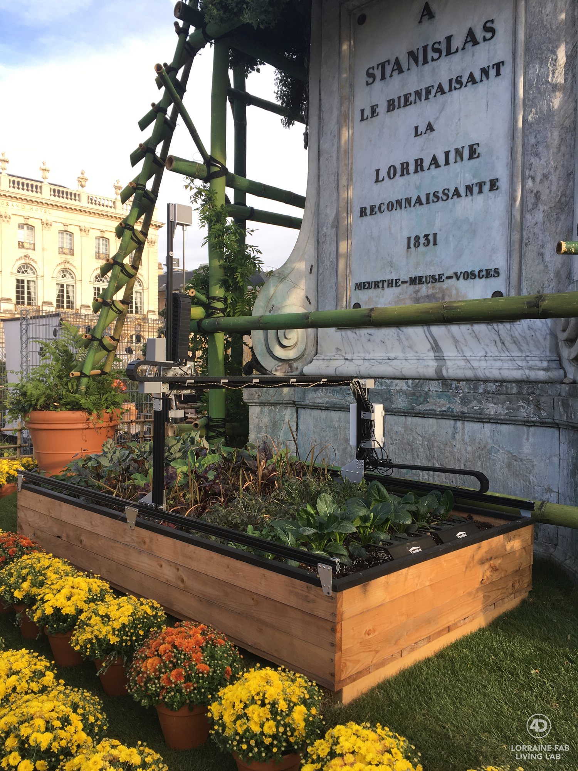
Images/Others/JE/Fabcity-LF2L-0003.jpg
