LF2L/Green-FabLab/Images/Others/JE/Fabcity-LF2L-0005.jpg

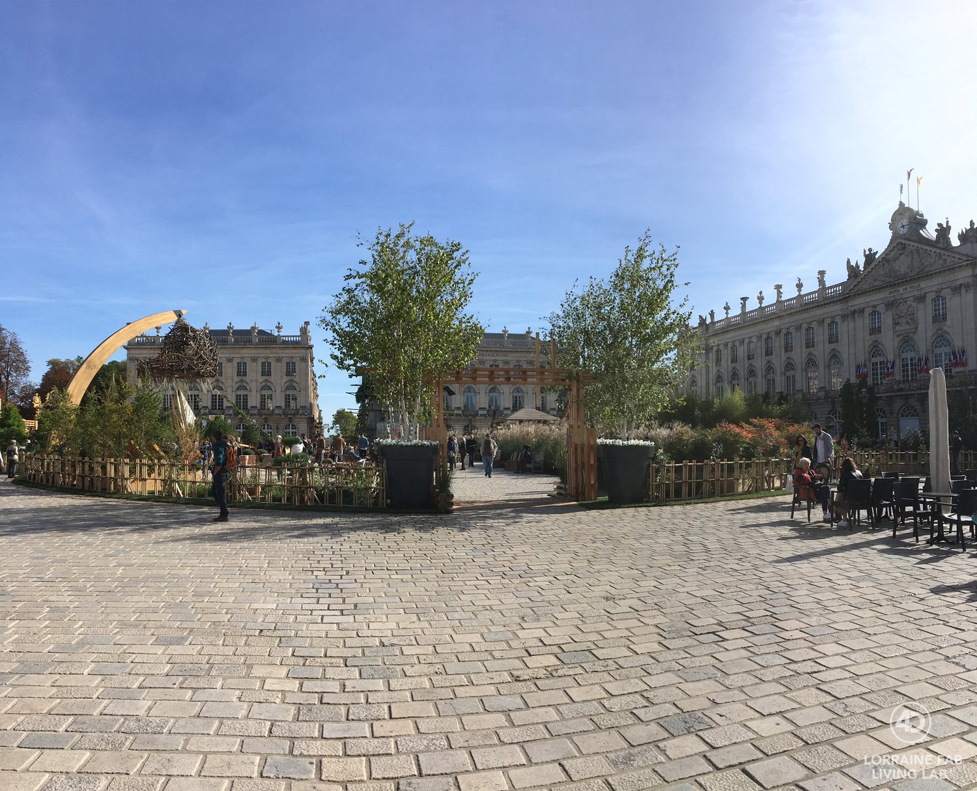
Images/Others/JE/Fabcity-LF2L-0005.jpg
