LF2L/Green-FabLab/Images/Others/JE/Fabcity-LF2L-0018.jpg

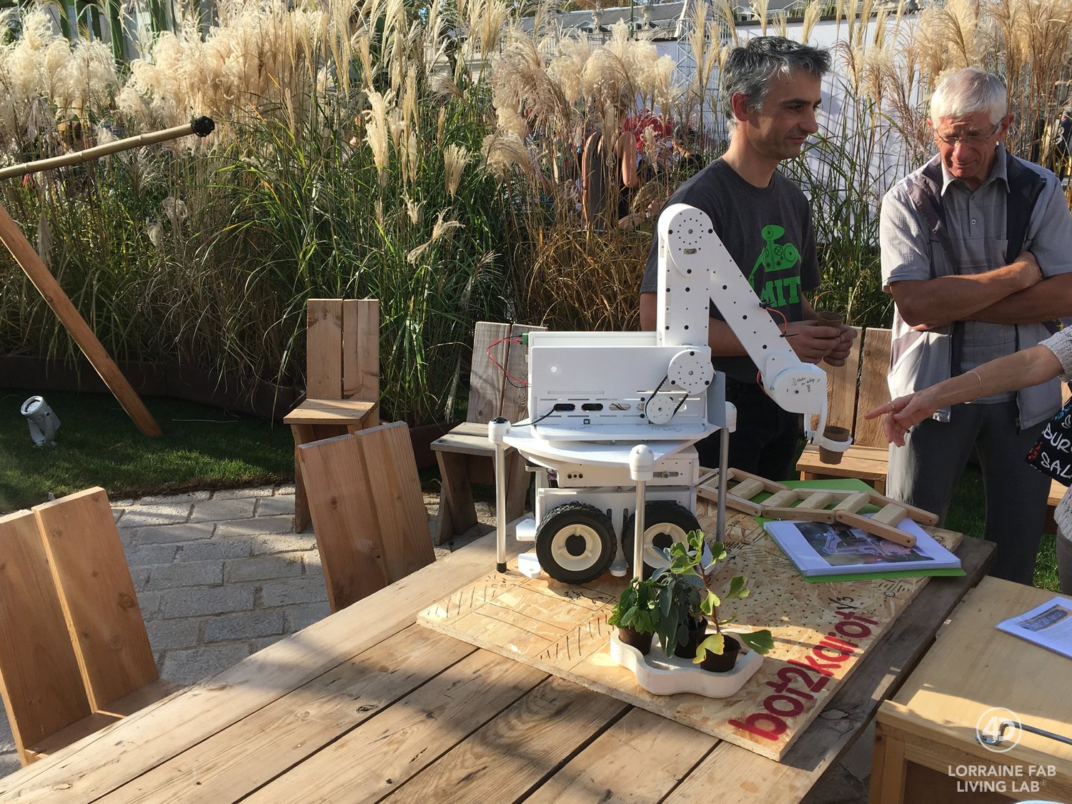
Images/Others/JE/Fabcity-LF2L-0018.jpg
