LF2L/Green-FabLab/Images/Research/global-approach.png

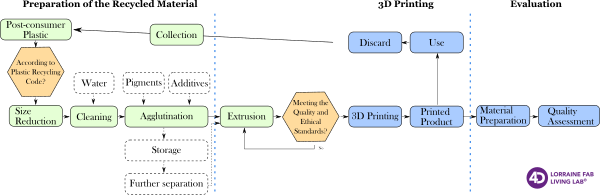
Images/Research/global-approach.png
