LF2L/Green-FabLab/Images/Structure/2019-05-12-0006.jpg

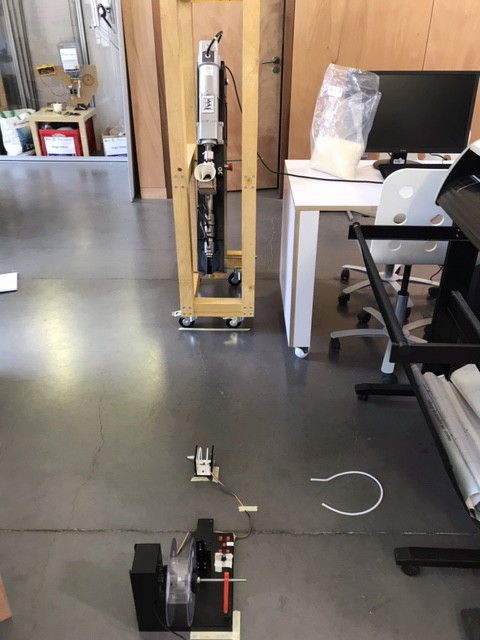
Images/Structure/2019-05-12-0006.jpg
