LF2L/Green-FabLab/Images/Students/1-Alexis-Romain/GF-0001.jpg

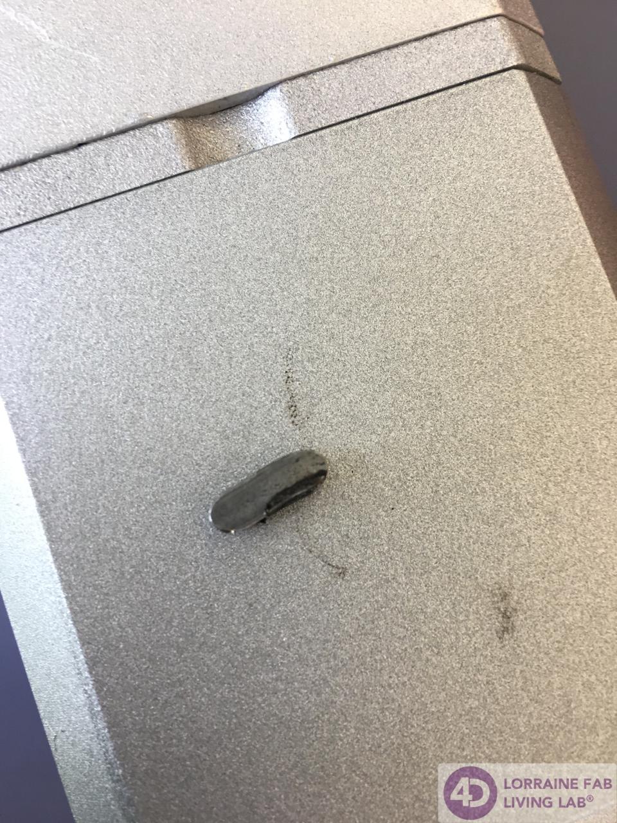
Images/Students/1-Alexis-Romain/GF-0001.jpg
