LF2L/Green-FabLab/Images/Students/1-Alexis-Romain/GF-0017.jpg

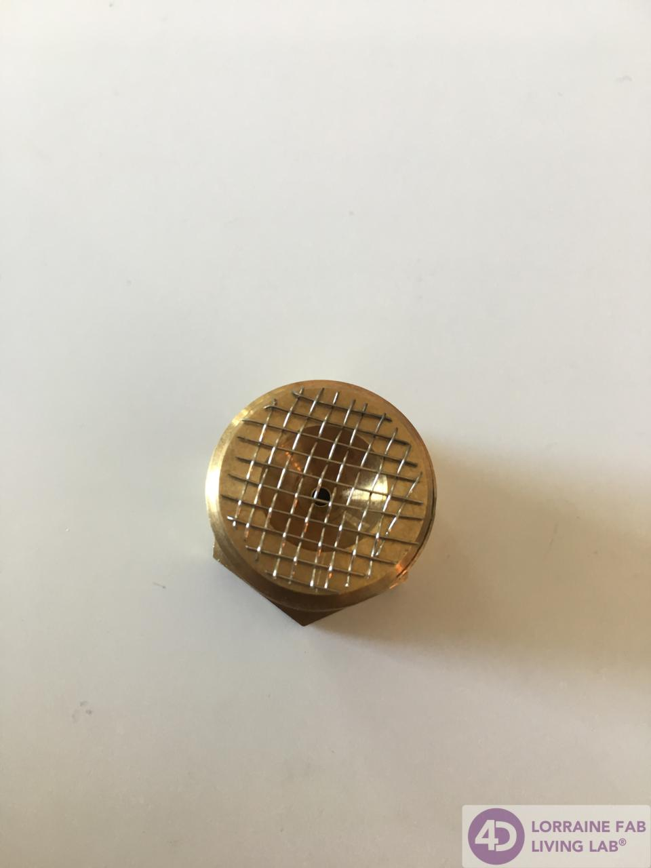
Images/Students/1-Alexis-Romain/GF-0017.jpg
