LF2L/Green-FabLab/Images/Students/1-Alexis-Romain/GF-0025.jpg

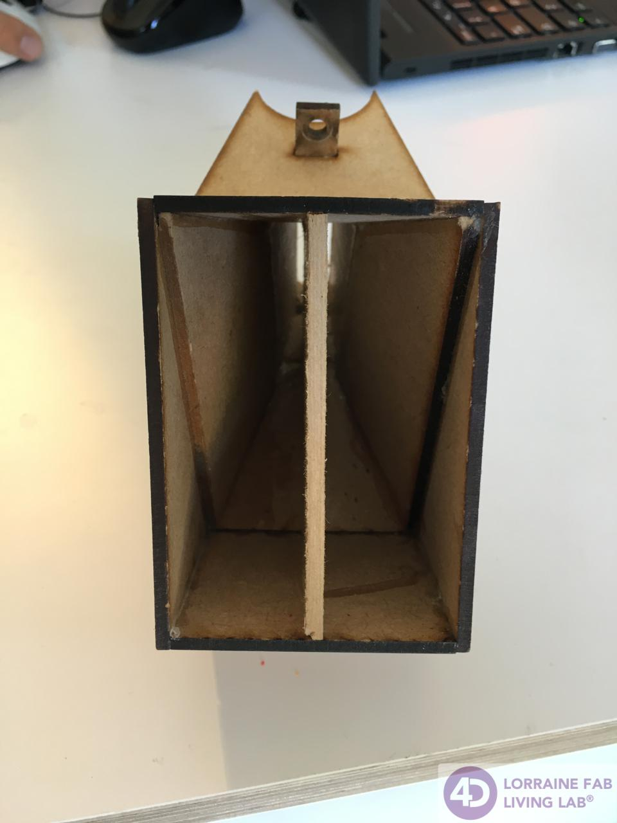
Images/Students/1-Alexis-Romain/GF-0025.jpg
