LF2L/Green-FabLab/Images/Students/1-Alexis-Romain/GF-0041.jpg

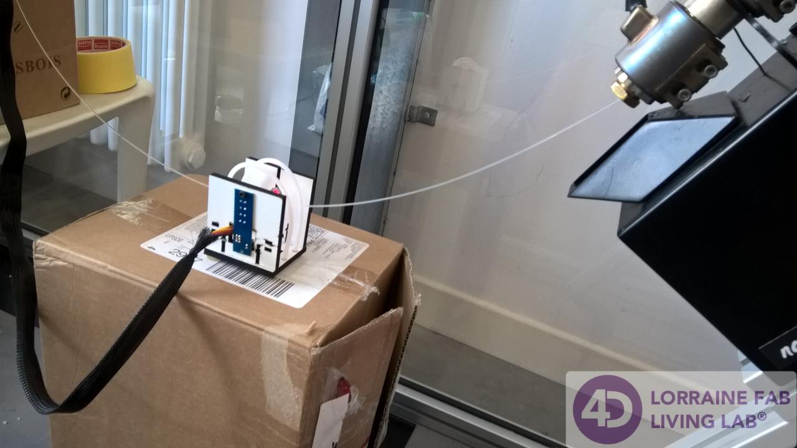
Images/Students/1-Alexis-Romain/GF-0041.jpg
