LF2L/Green-FabLab/Images/Students/1-Alexis-Romain/GF-0048.jpg

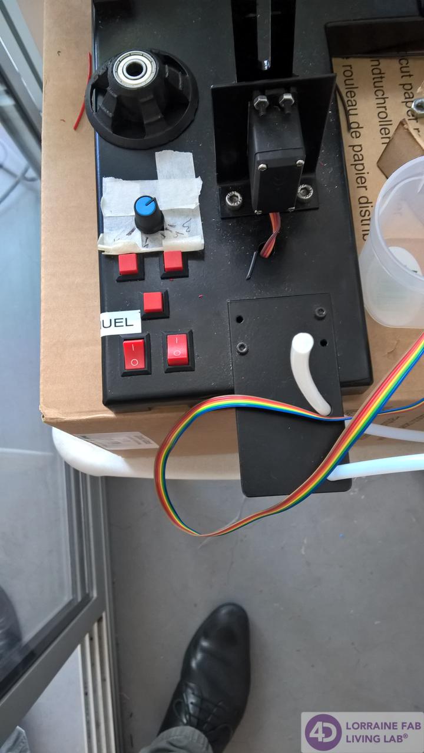
Images/Students/1-Alexis-Romain/GF-0048.jpg
