LF2L/Green-FabLab/Images/Students/1-Alexis-Romain/GF-0049.jpg

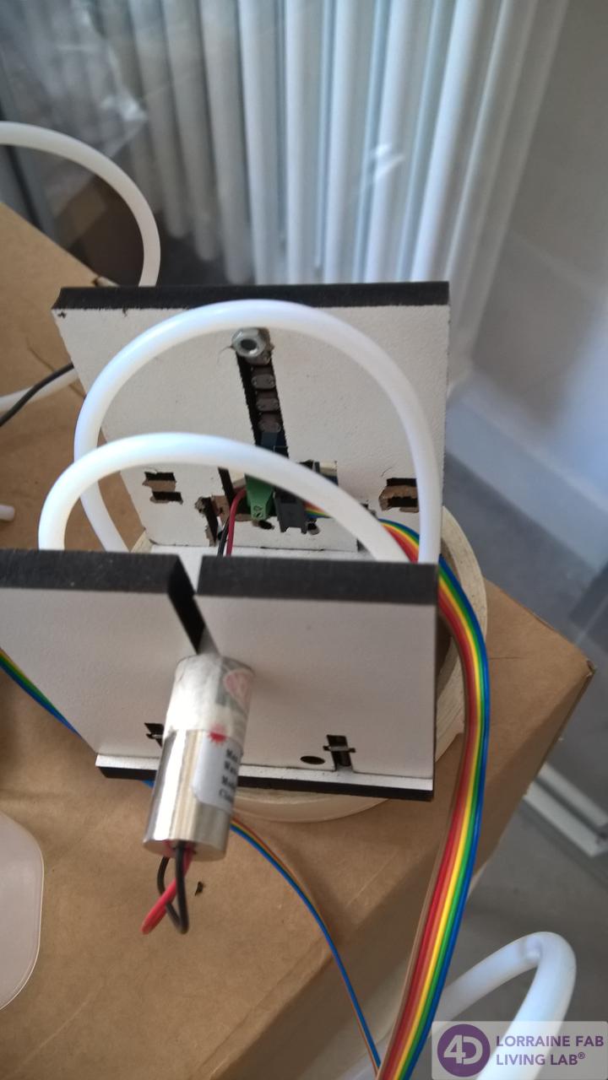
Images/Students/1-Alexis-Romain/GF-0049.jpg
