LF2L/Green-FabLab/Images/Students/2-Nicolas-Maxime/GF-0001.jpg

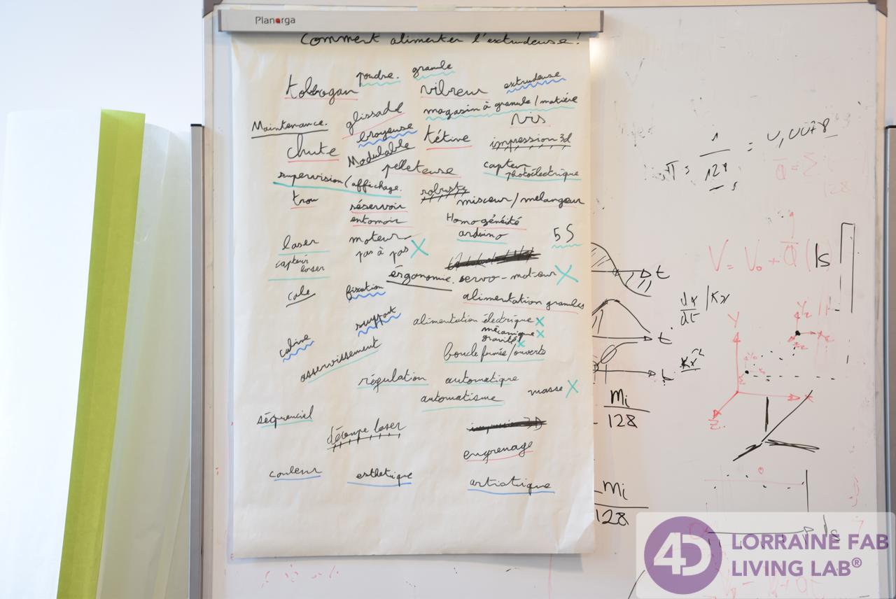
Images/Students/2-Nicolas-Maxime/GF-0001.jpg
