LF2L/Green-FabLab/Images/Students/2-Nicolas-Maxime/GF-0004.jpg

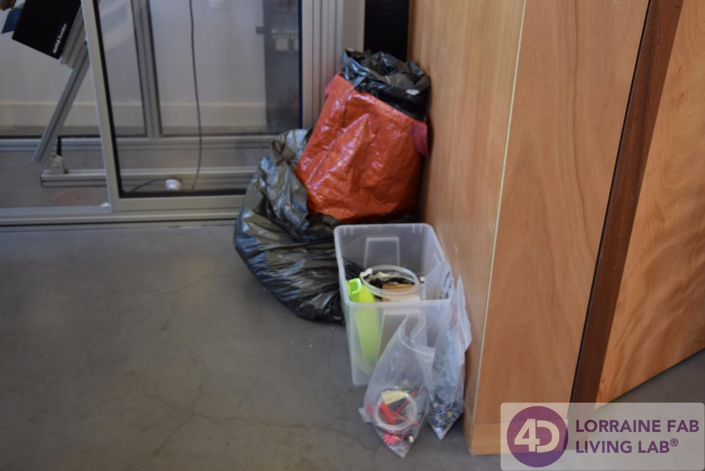
Images/Students/2-Nicolas-Maxime/GF-0004.jpg
