LF2L/Green-FabLab/Images/Students/2-Nicolas-Maxime/GF-0006.jpg

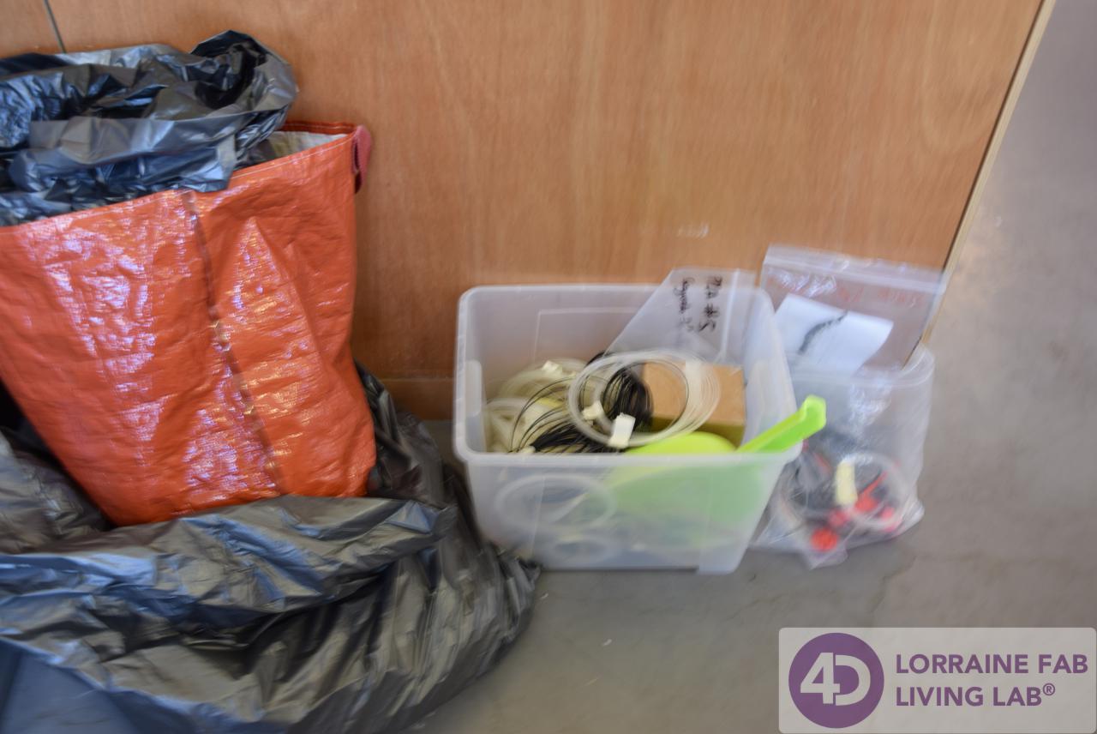
Images/Students/2-Nicolas-Maxime/GF-0006.jpg
