LF2L/Green-FabLab/Images/Students/2-Nicolas-Maxime/GF-0018.jpg

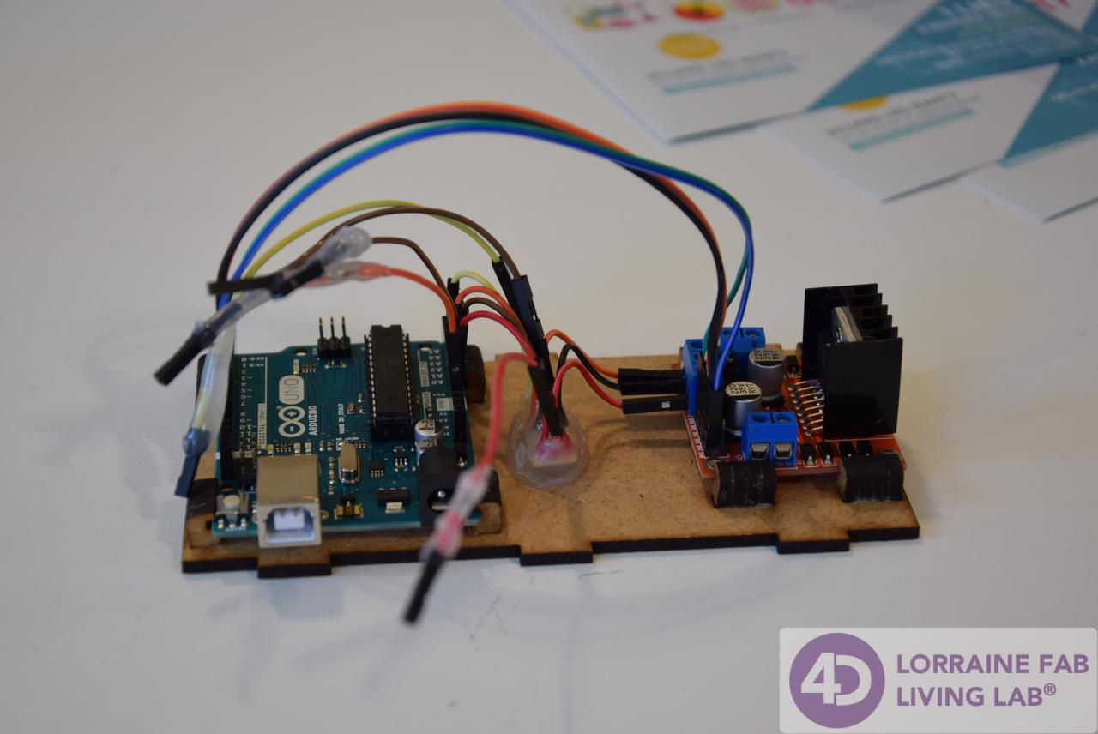
Images/Students/2-Nicolas-Maxime/GF-0018.jpg
