LF2L/Green-FabLab/Images/Students/2-Nicolas-Maxime/GF-0028.jpg

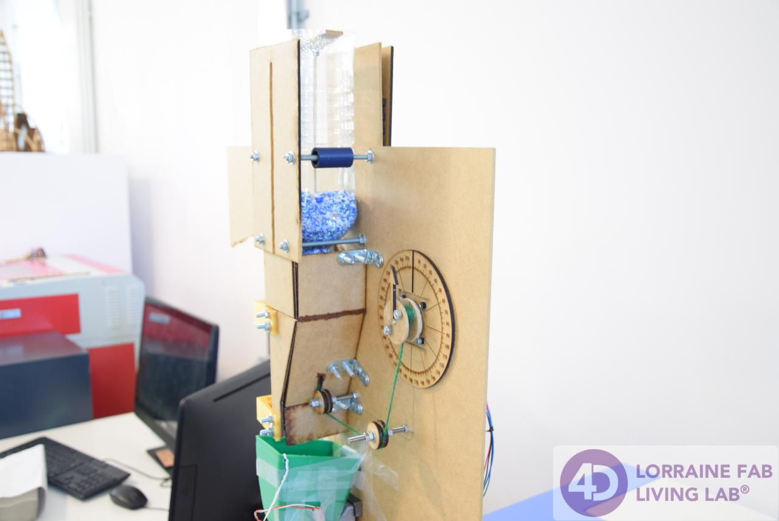
Images/Students/2-Nicolas-Maxime/GF-0028.jpg
