LF2L/Green-FabLab/Images/Students/3-Eudes/GF-0005.jpg

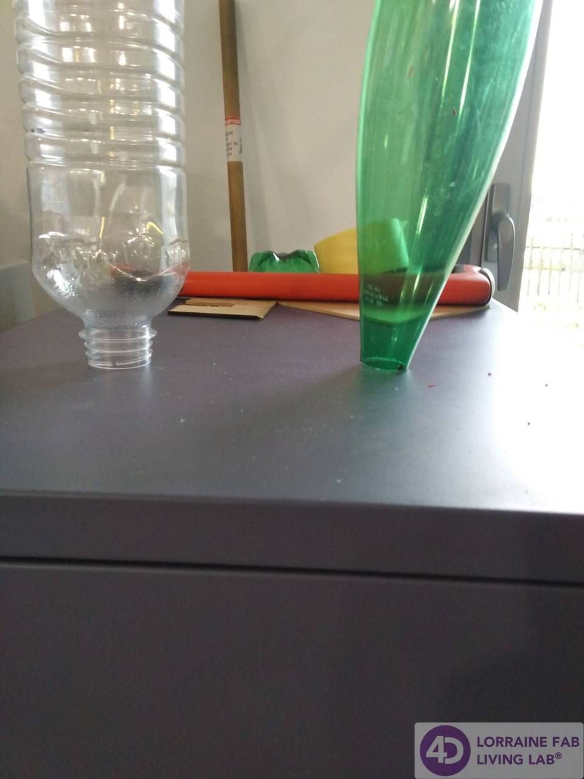
Images/Students/3-Eudes/GF-0005.jpg
