LF2L/Green-FabLab/Images/Students/3-Eudes/GF-0009.jpg

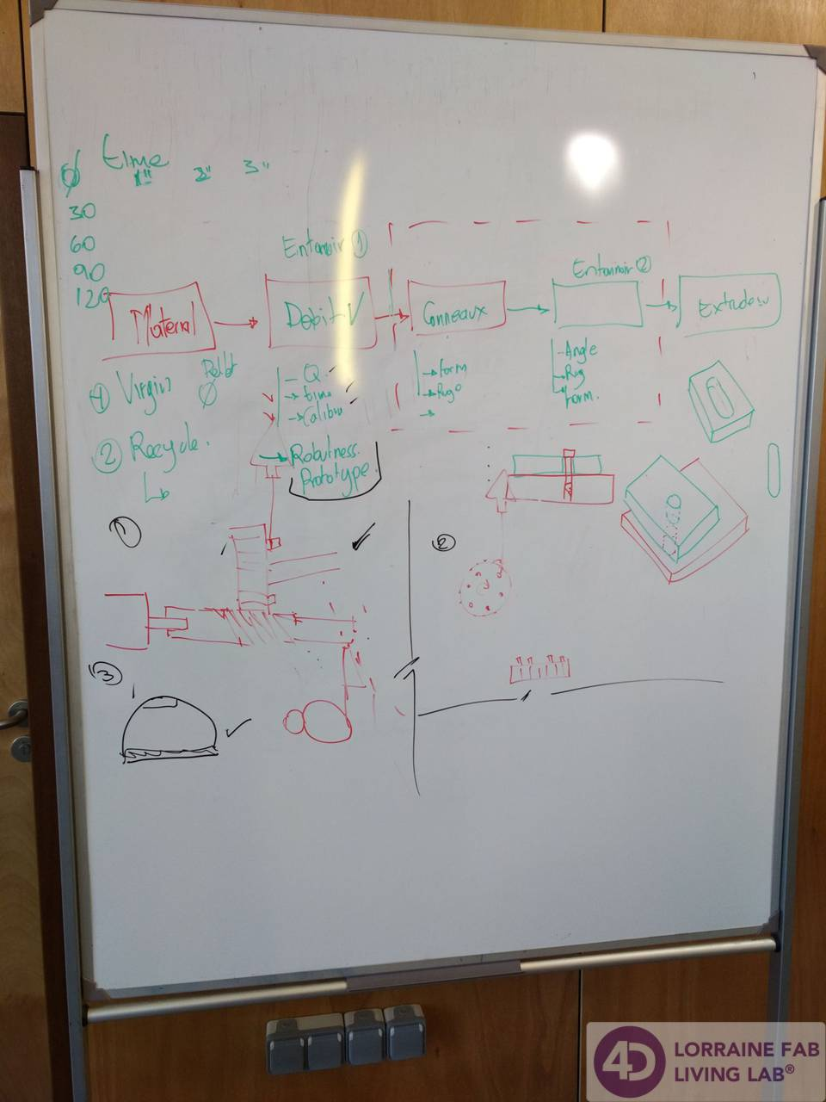
Images/Students/3-Eudes/GF-0009.jpg
