LF2L/Green-FabLab/Images/Students/3-Eudes/GF-0014.jpg

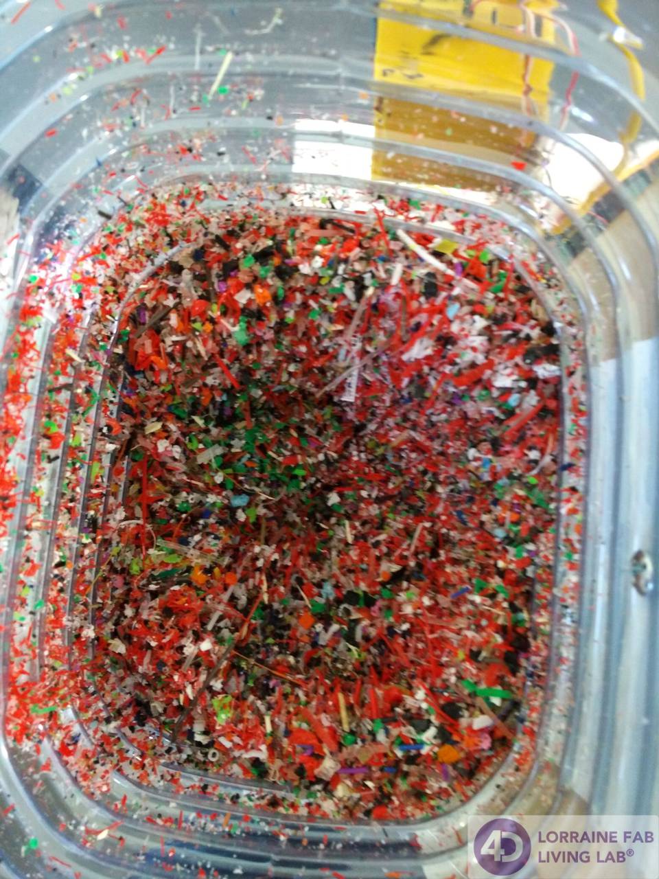
Images/Students/3-Eudes/GF-0014.jpg
