LF2L/Green-FabLab/Images/Students/3-Eudes/GF-0025.jpg

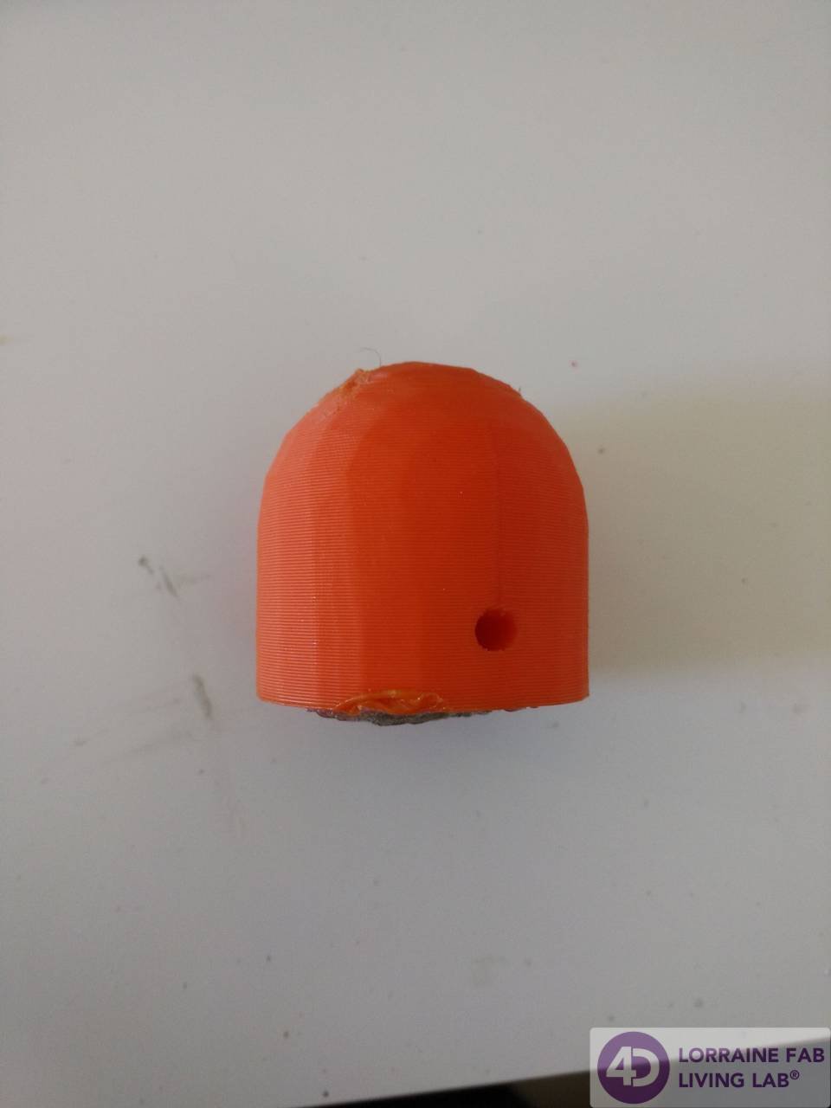
Images/Students/3-Eudes/GF-0025.jpg
