LF2L/Green-FabLab/Images/Students/3-Eudes/GF-0028.jpg

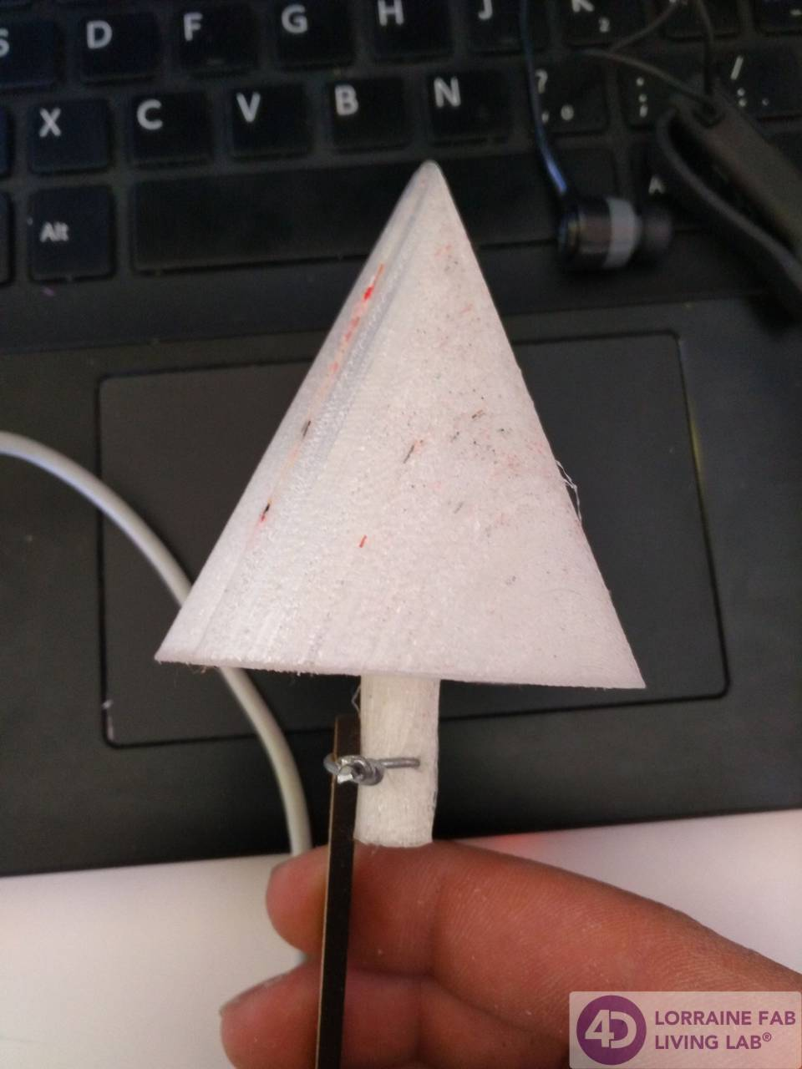
Images/Students/3-Eudes/GF-0028.jpg
