LF2L/Green-FabLab/Images/Students/3-Eudes/GF-0031.jpg

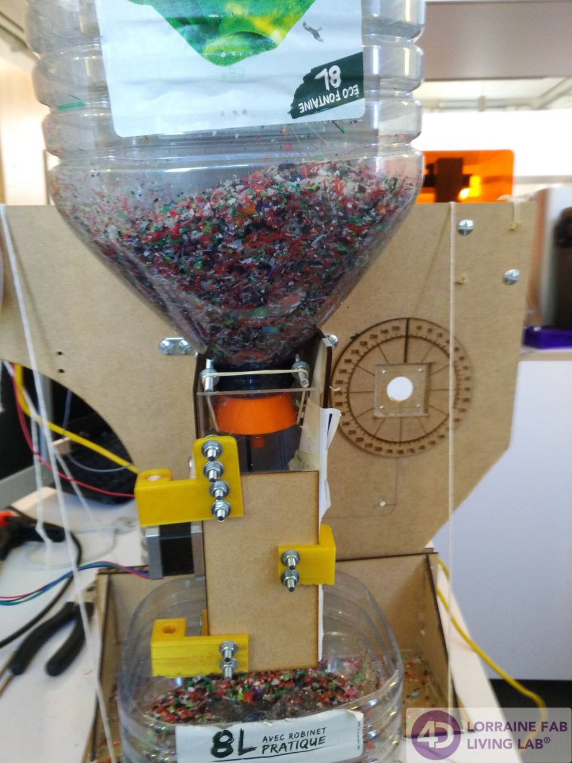
Images/Students/3-Eudes/GF-0031.jpg
