LF2L/Green-FabLab/Images/Students/3-Eudes/GF-0034.jpg

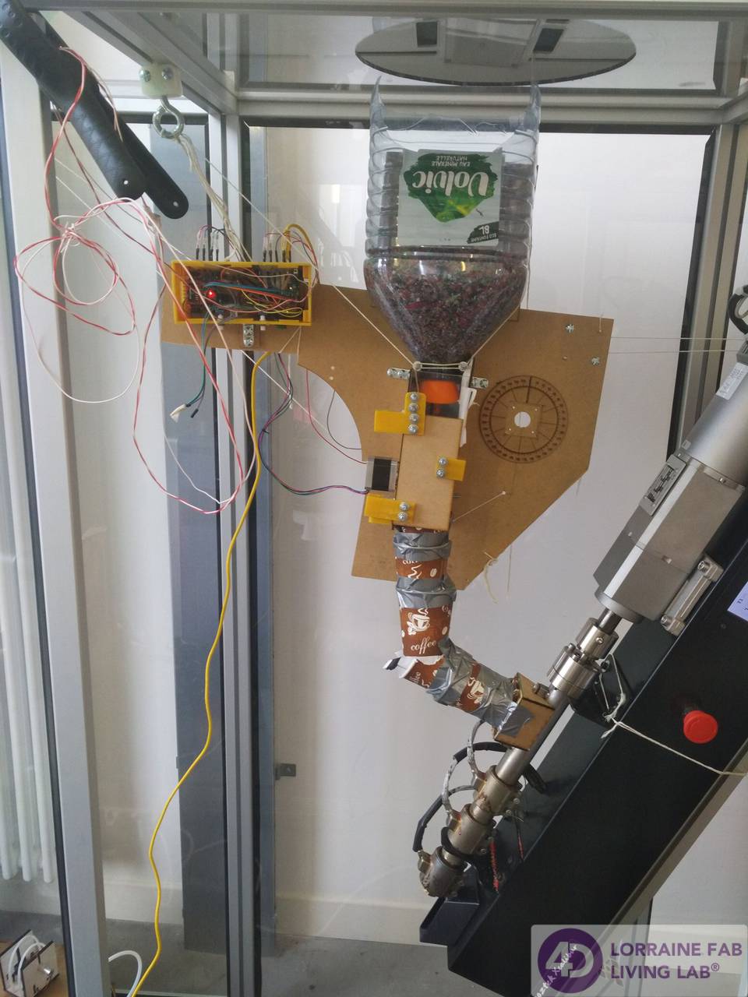
Images/Students/3-Eudes/GF-0034.jpg
