LF2L/Green-FabLab/Images/Students/3-Eudes/GF-0042.jpg

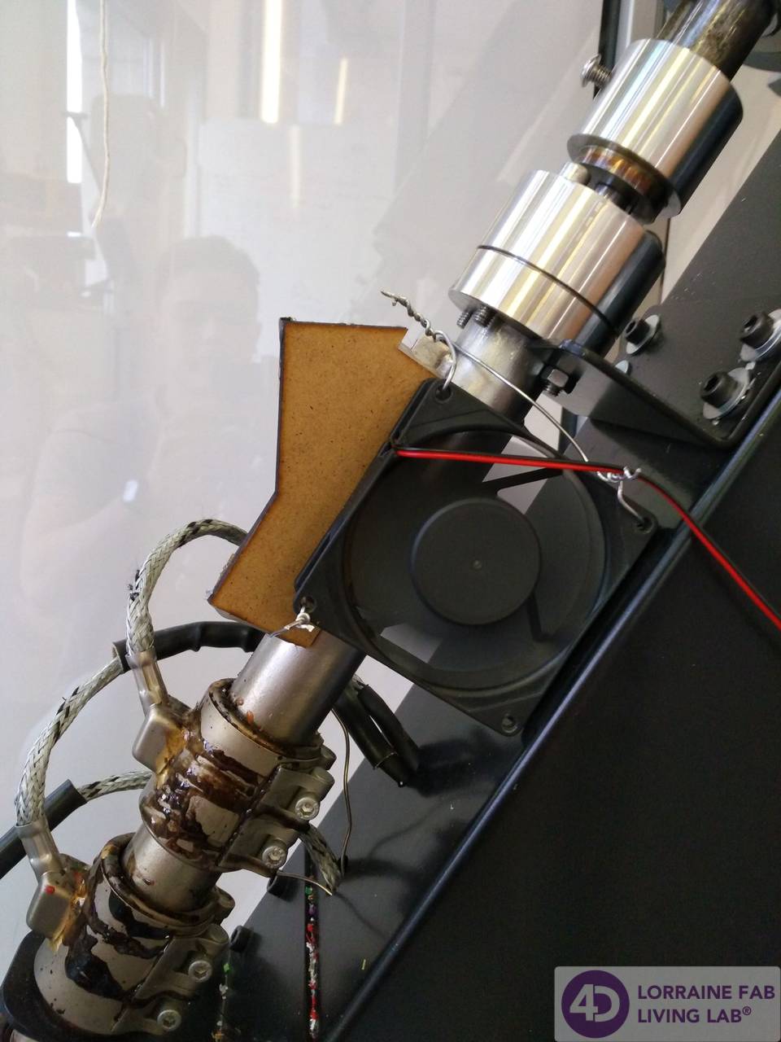
Images/Students/3-Eudes/GF-0042.jpg
