LF2L/Green-FabLab/Images/Students/3-Eudes/GF-0050.jpg

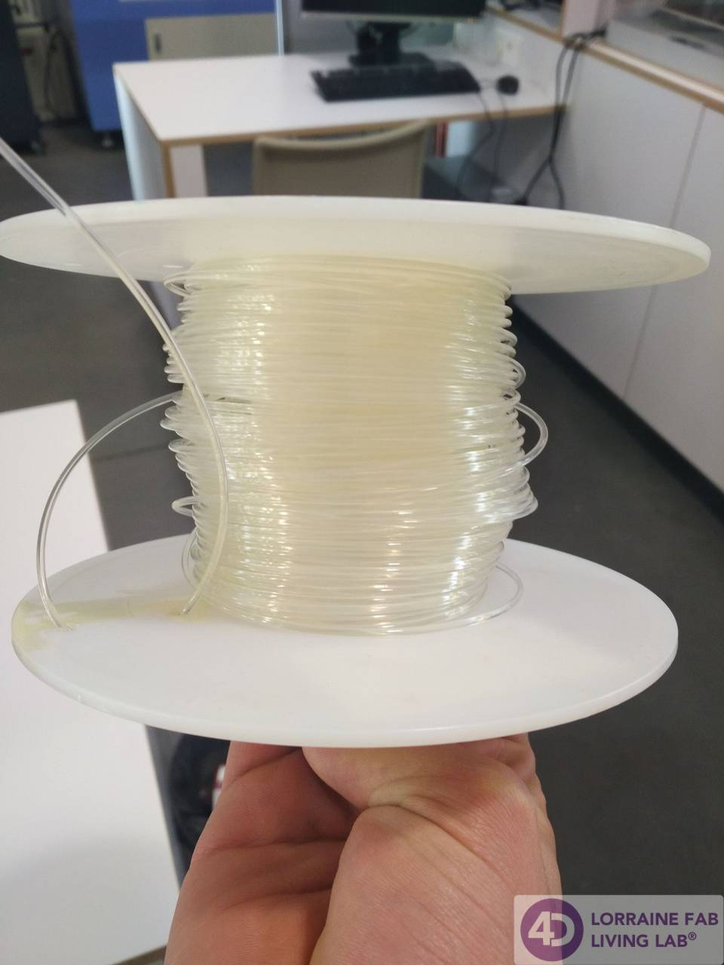
Images/Students/3-Eudes/GF-0050.jpg
