LF2L/Green-FabLab/Images/Students/3-Eudes/GF-0051.jpg

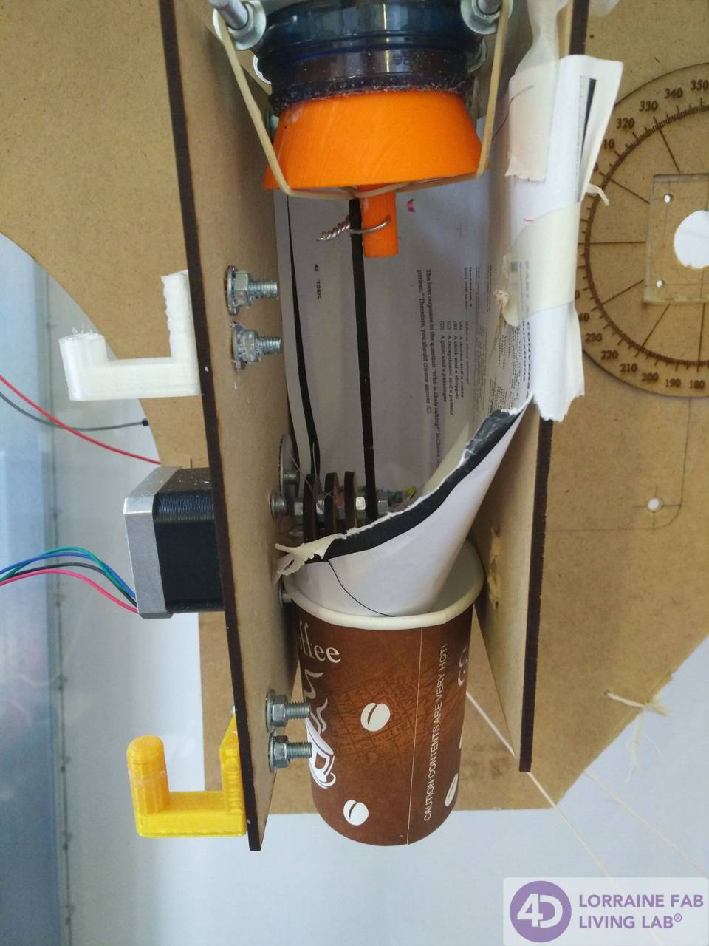
Images/Students/3-Eudes/GF-0051.jpg
