LF2L/Green-FabLab/Images/Students/3-Eudes/GF-0062.jpg

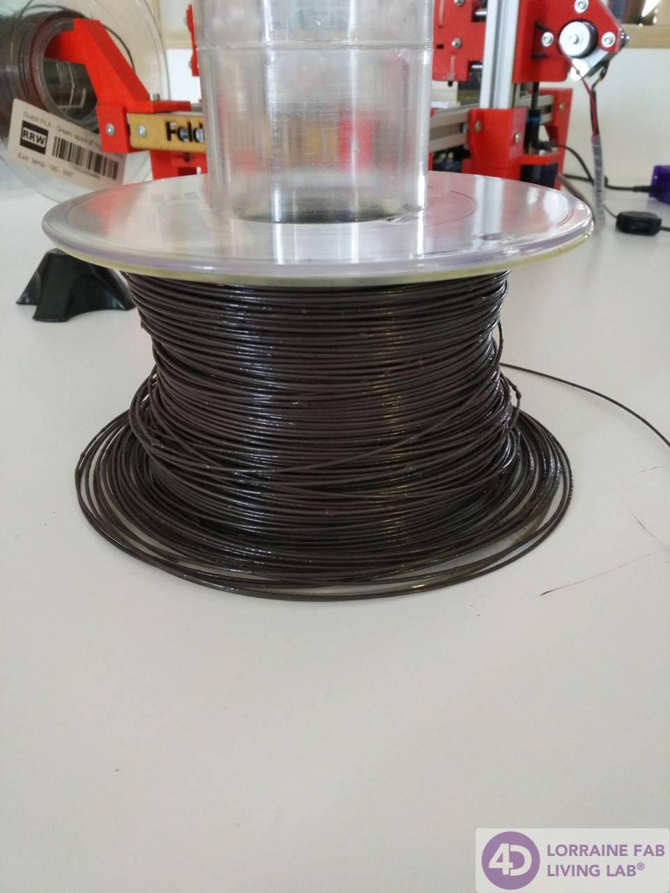
Images/Students/3-Eudes/GF-0062.jpg
