LF2L/Green-FabLab/Images/Students/4-Paul-Timothee/GF-LF2L-0002.jpg

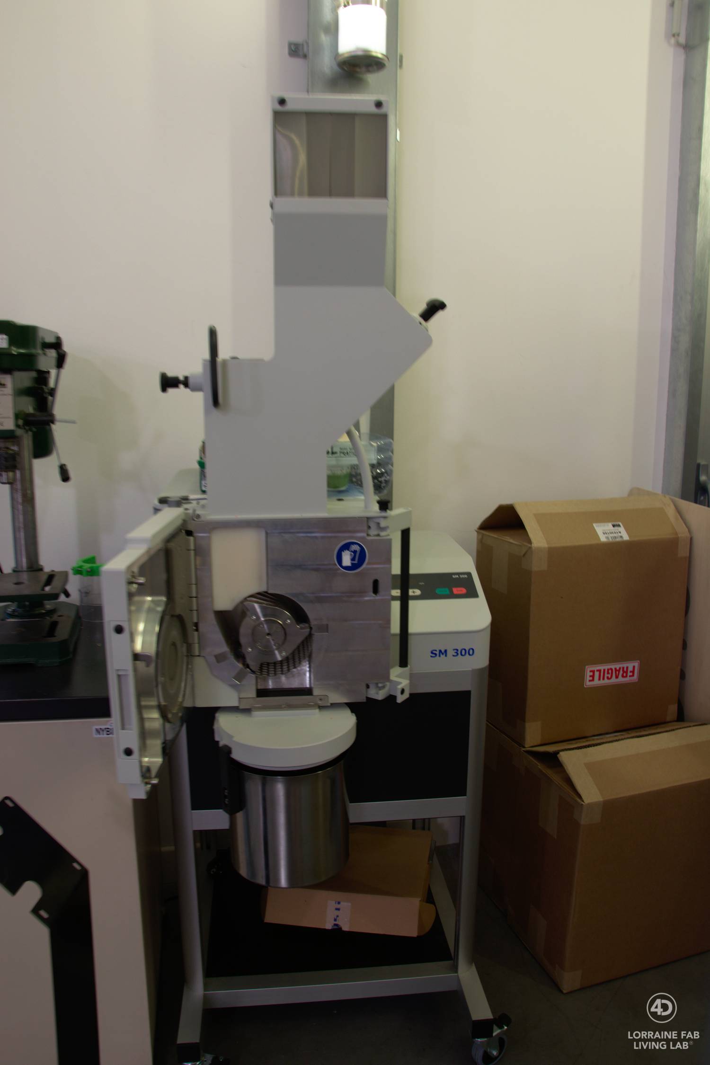
Images/Students/4-Paul-Timothee/GF-LF2L-0002.jpg
