LF2L/Green-FabLab/Images/Students/4-Paul-Timothee/GF-LF2L-0005.jpg

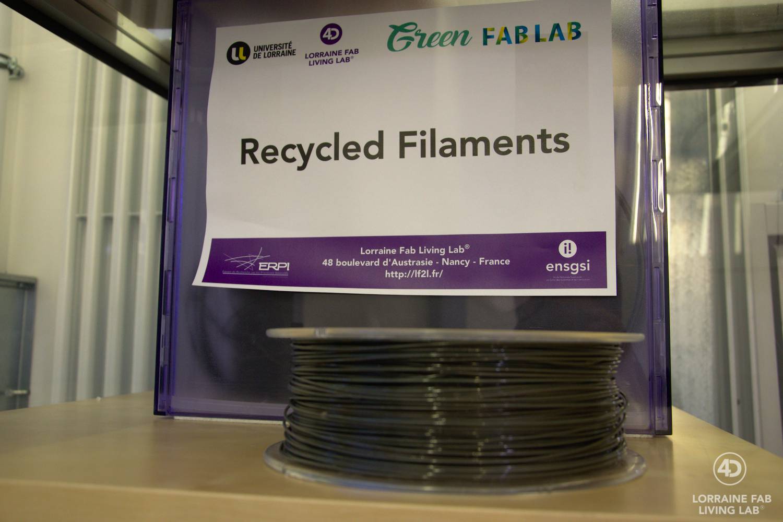
Images/Students/4-Paul-Timothee/GF-LF2L-0005.jpg
