LF2L/Green-FabLab/Images/Students/4-Paul-Timothee/GF-LF2L-0007.jpg

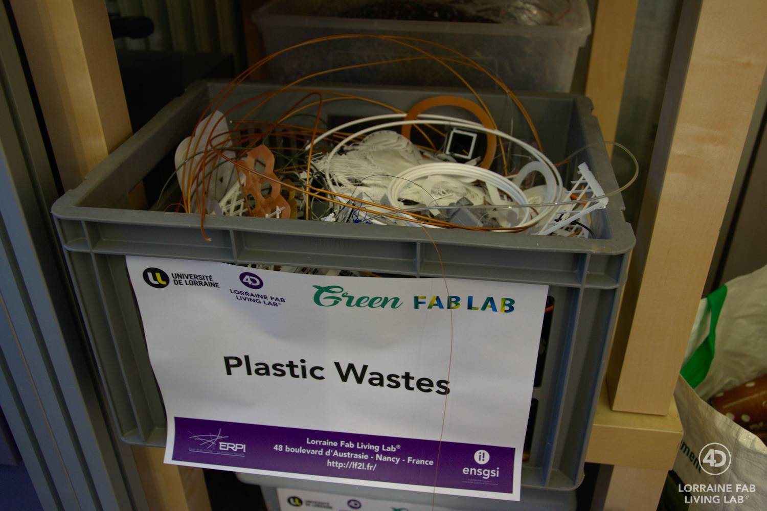
Images/Students/4-Paul-Timothee/GF-LF2L-0007.jpg
