LF2L/Green-FabLab/Images/Students/5-Romain-Arnaud/Fig-0001.jpg

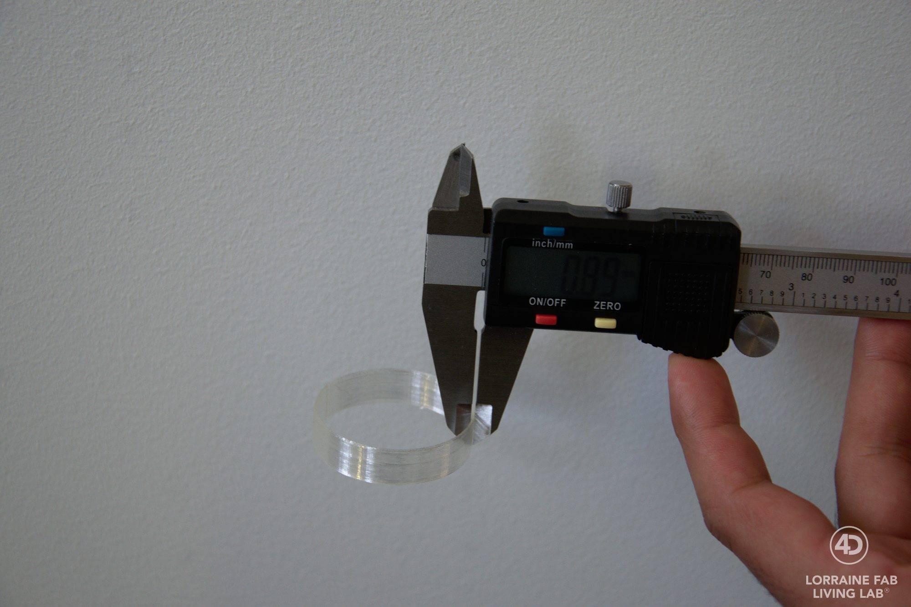
Images/Students/5-Romain-Arnaud/Fig-0001.jpg
