LF2L/Green-FabLab/Images/Students/5-Romain-Arnaud/Fig-0020.jpg

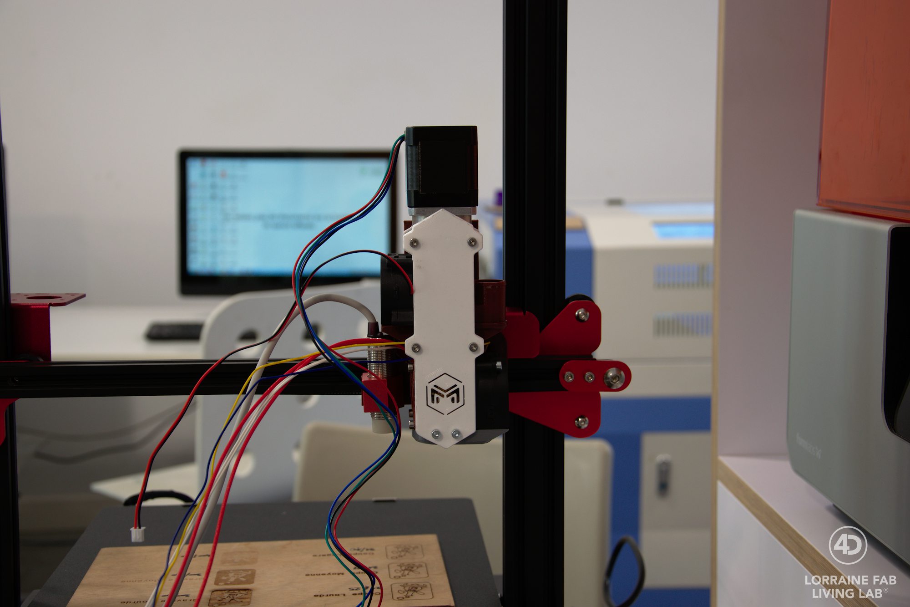
Images/Students/5-Romain-Arnaud/Fig-0020.jpg
