LF2L/Green-FabLab/Images/Students/5-Romain-Arnaud/Fig-0028.jpg

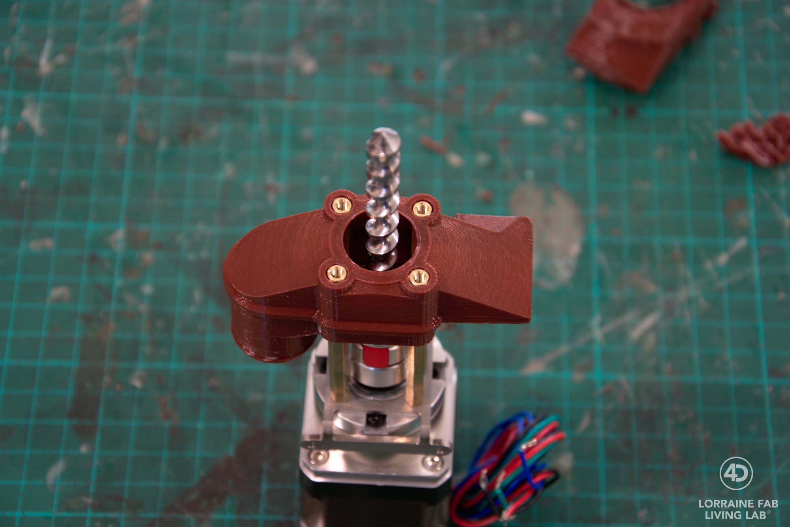
Images/Students/5-Romain-Arnaud/Fig-0028.jpg
