LF2L/Green-FabLab/Images/Thumbnails.jpg

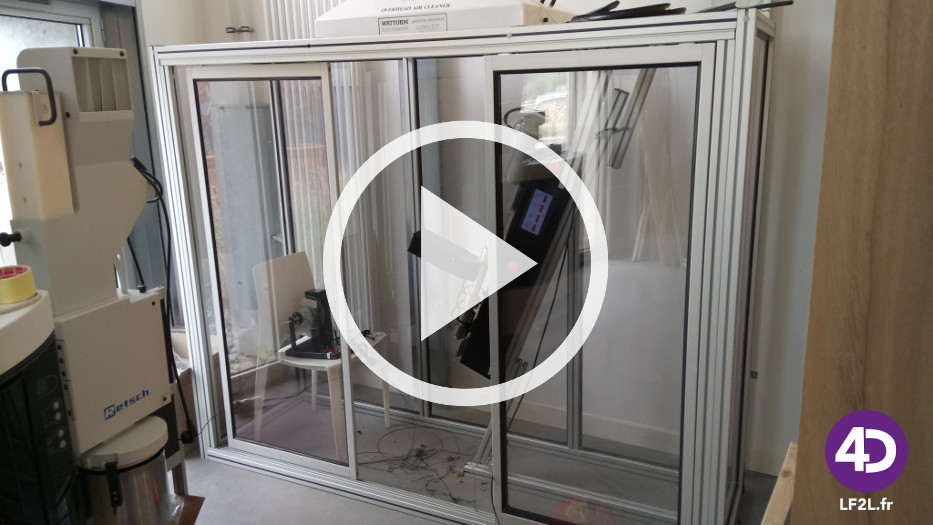
Images/Thumbnails.jpg
