LF2L/Green-FabLab/Images/Videos/Schema-ficheidéen1.PNG

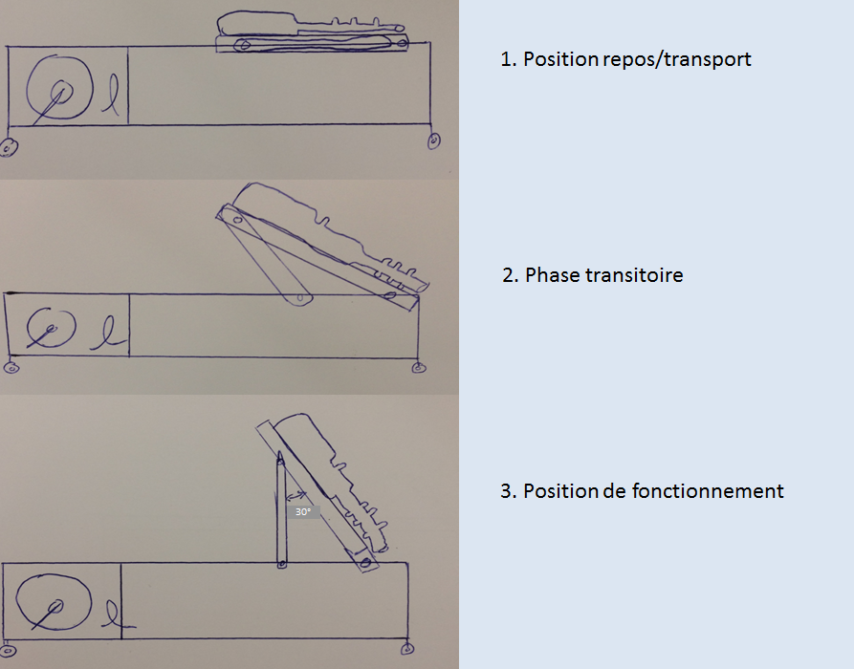
Images/Videos/Schema-ficheidéen1.PNG
