LF2L/Green-FabLab/Images/Videos/VraiCharnière.jpg

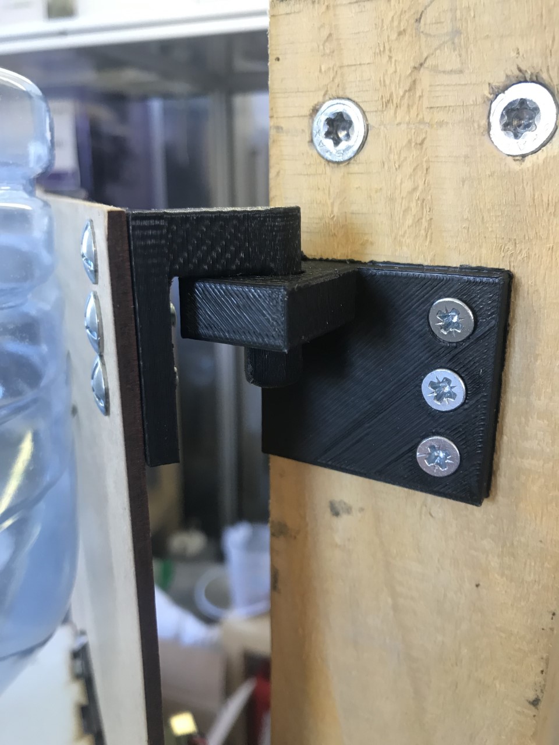
Images/Videos/VraiCharnière.jpg
