LF2L/Green-FabLab/Images/Material/2019-05-0003.jpg

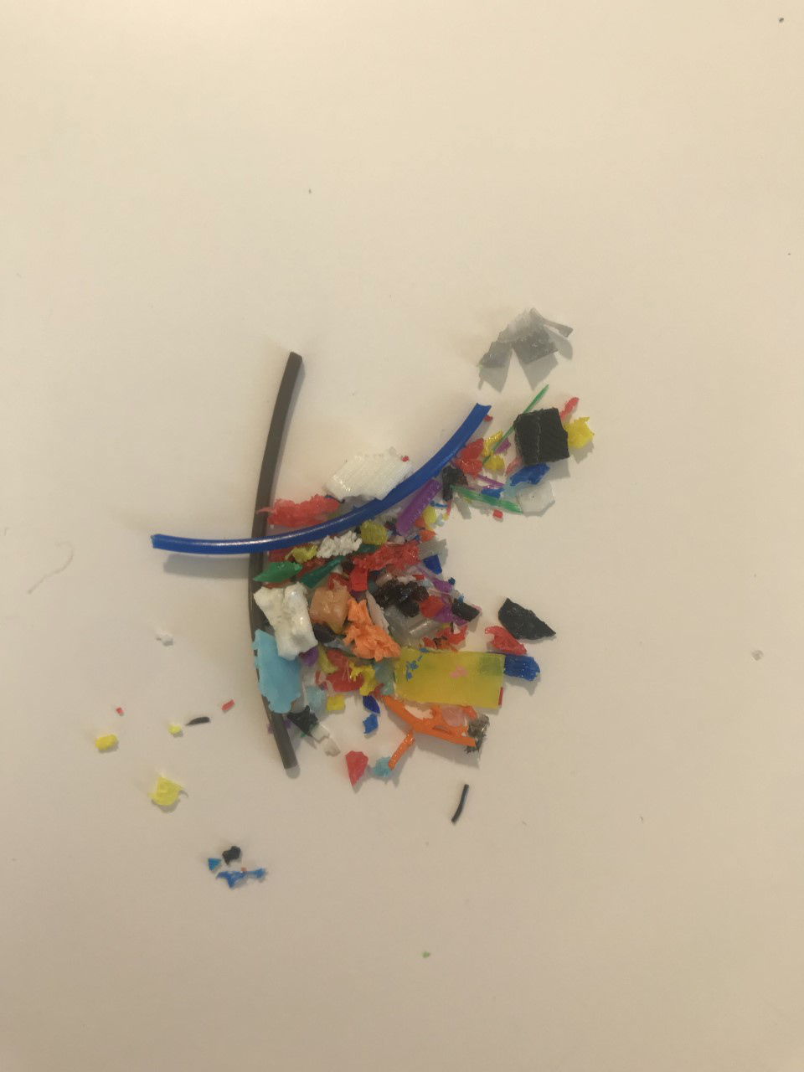
Images/Material/2019-05-0003.jpg
