LF2L/Green-FabLab/Structure/CAD Models/Assemblageextrudeuse.SLDASM

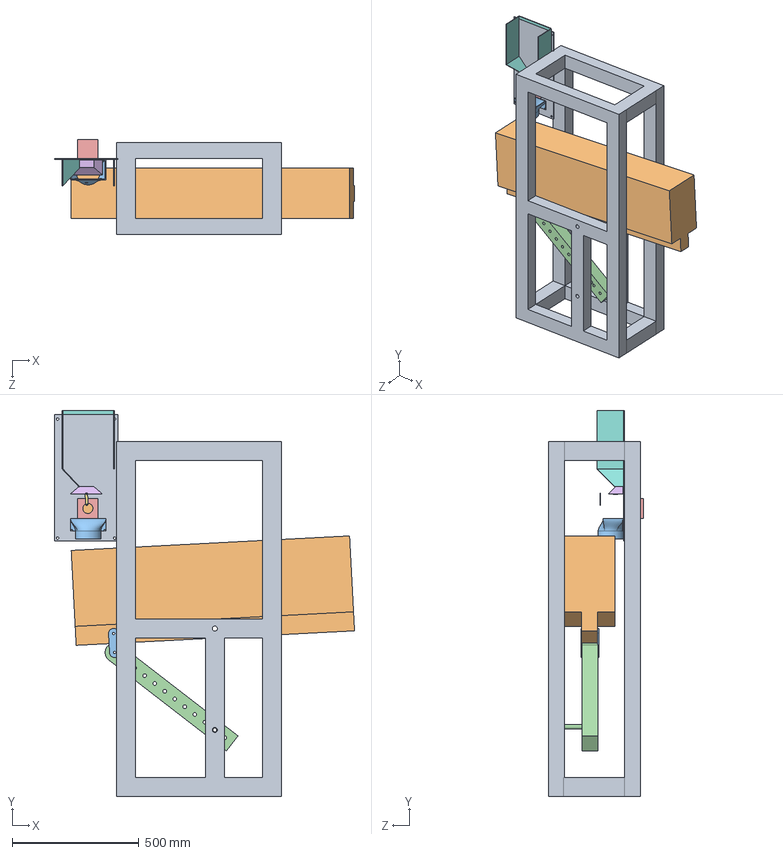
[picture p417: CAD file, 2018-10-10]
Structure/CAD Models/Assemblageextrudeuse.SLDASM
1184.2 x 1523.0 x 376.4 mm
boite transport extrudeuse seule
extrudeuse
plaques rotation
boite transport extrudeuse barre seule
moteur avec disque
bouchon
biele
tremie
plaque de montage
disque
entonnoir 2
