LF2L/Green-FabLab/Structure/CAD Models/STL/Assemblageextrudeuse - entonnoir 2-1.STL

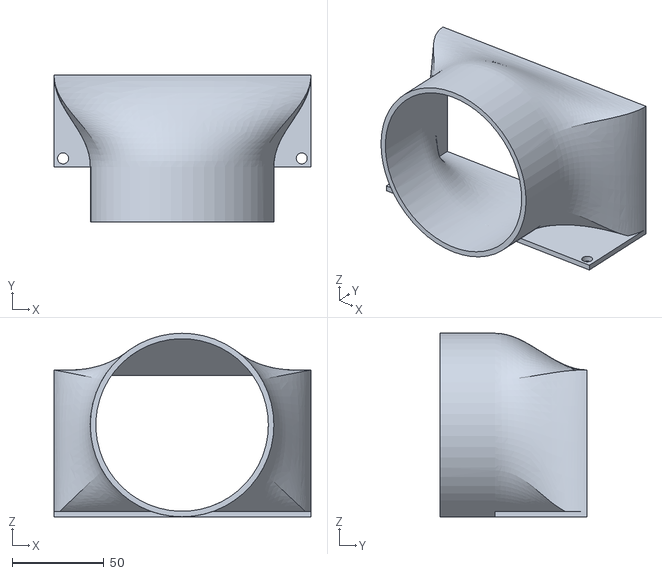
[picture p418: CAD file, 2018-10-10]
Structure/CAD Models/STL/Assemblageextrudeuse - entonnoir 2-1.STL
140.0 x 80.0 x 100.0
