LF2L/Green-FabLab/Structure/CAD Models/STL/Assemblageextrudeuse - alimentation 3-1 biele-1.STL

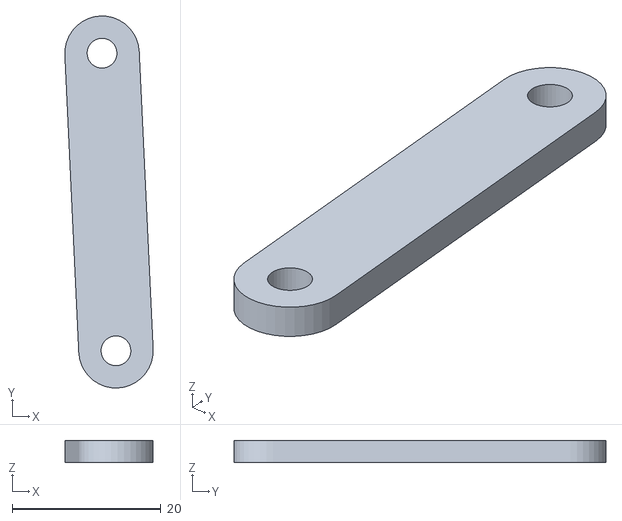
[picture p419: CAD file, 2018-10-10]
Structure/CAD Models/STL/Assemblageextrudeuse - alimentation 3-1 biele-1.STL
11.9 x 49.9 x 3.00
