LF2L/Green-FabLab/Structure/CAD Models/STL/Assemblageextrudeuse - alimentation 3-1 tremie-1.STL

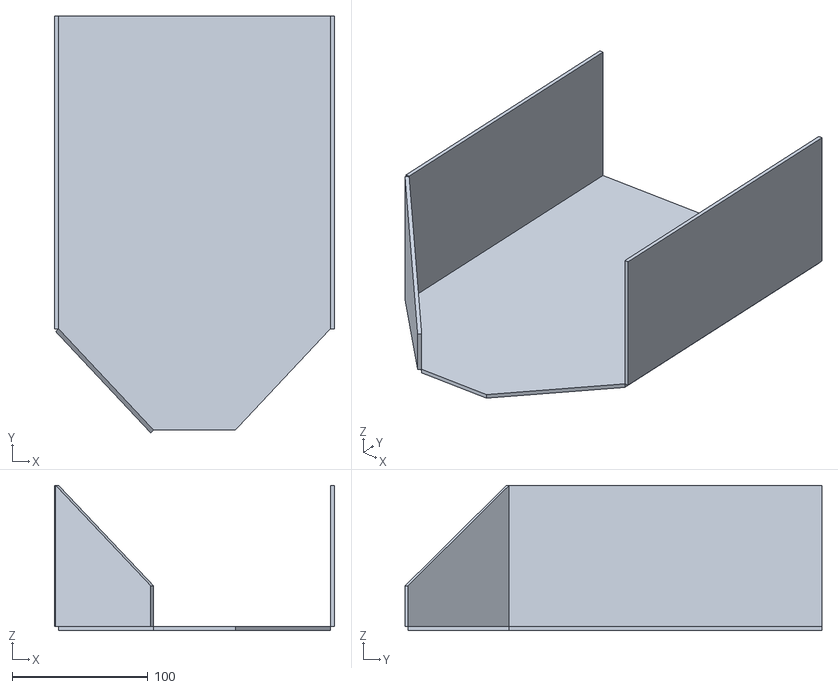
[picture p420: CAD file, 2018-10-10]
Structure/CAD Models/STL/Assemblageextrudeuse - alimentation 3-1 tremie-1.STL
206.0 x 306.8 x 107.0
