LF2L/Green-FabLab/Structure/CAD Models/STL/Assemblageextrudeuse - alimentation 3-1 disque-1.STL

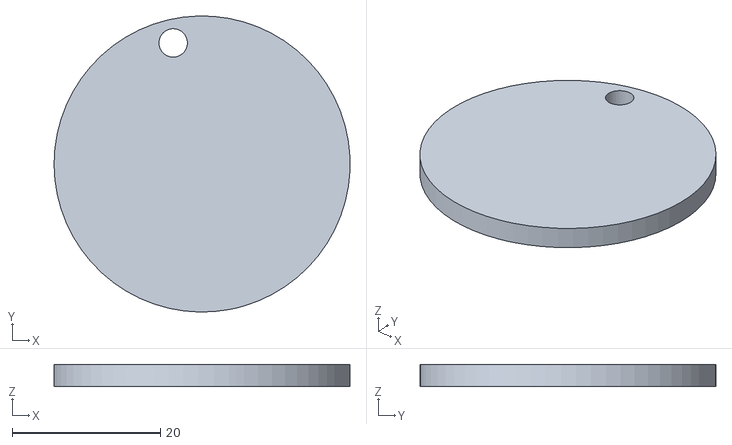
[picture p421: CAD file, 2018-10-10]
Structure/CAD Models/STL/Assemblageextrudeuse - alimentation 3-1 disque-1.STL
40.0 x 40.0 x 3.00
