LF2L/Green-FabLab/Structure/CAD Models/STL/Assemblageextrudeuse - plaques rotation-1.STL

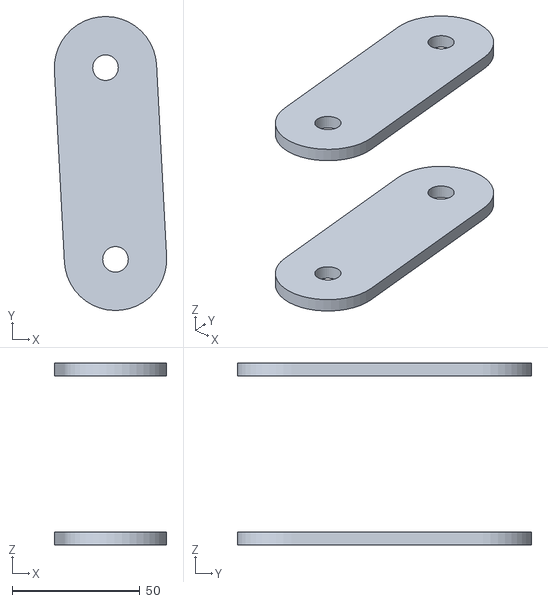
[picture p422: CAD file, 2018-10-10]
Structure/CAD Models/STL/Assemblageextrudeuse - plaques rotation-1.STL
43.9 x 114.9 x 71.0
