LF2L/Green-FabLab/Structure/CAD Models/STL/Assemblageextrudeuse - boite transport extrudeuse seule-1.STL

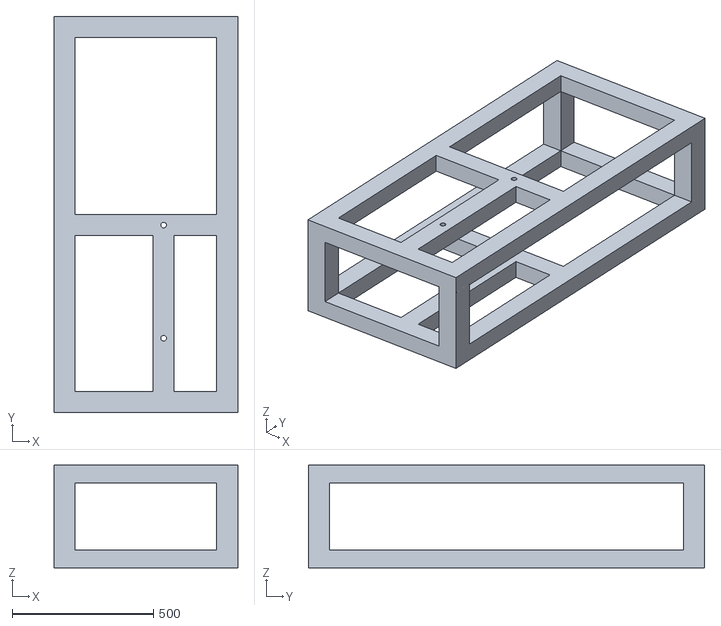
[picture p423: CAD file, 2018-10-10]
Structure/CAD Models/STL/Assemblageextrudeuse - boite transport extrudeuse seule-1.STL
650.3 x 1400.0 x 363.0
