LF2L/Green-FabLab/Structure/CAD Models/alimentation.SLDASM

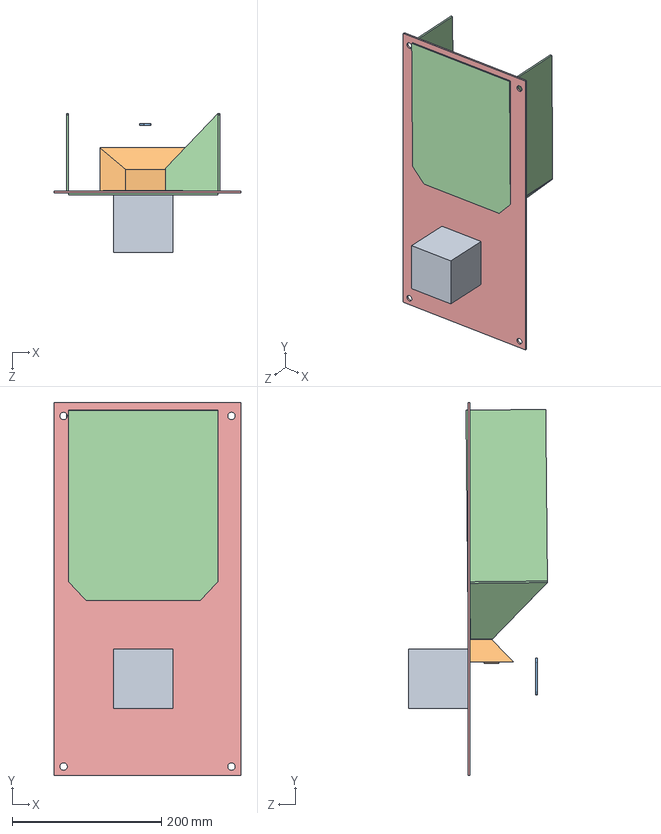
[picture p424: CAD file, 2018-10-10]
Structure/CAD Models/alimentation.SLDASM
250.0 x 500.0 x 186.3 mm
moteur avec disque
bouchon
biele
tremie
plaque de montage
disque
