LF2L/Green-FabLab/Structure/CAD Models/STL/Assemblageextrudeuse - alimentation 3-1 bouchon-1.STL

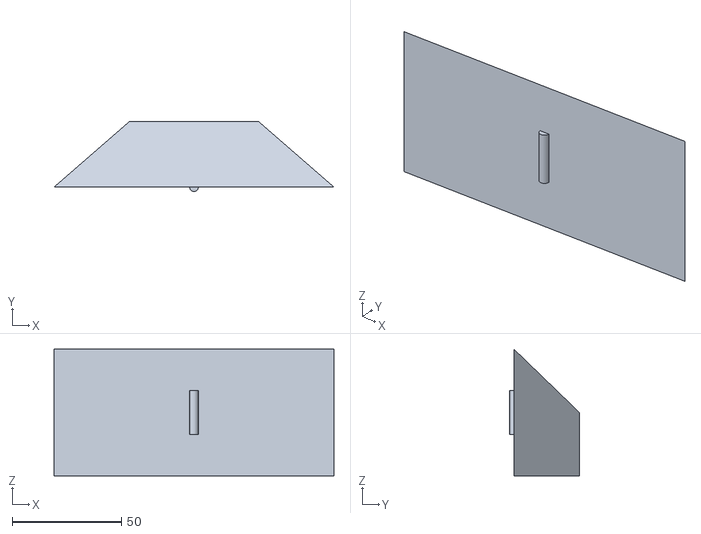
[picture p425: CAD file, 2018-10-10]
Structure/CAD Models/STL/Assemblageextrudeuse - alimentation 3-1 bouchon-1.STL
128.0 x 32.0 x 58.0
