LF2L/Green-FabLab/Structure/CAD Models/STL/Assemblageextrudeuse - boite transport extrudeuse barre seule-1.STL

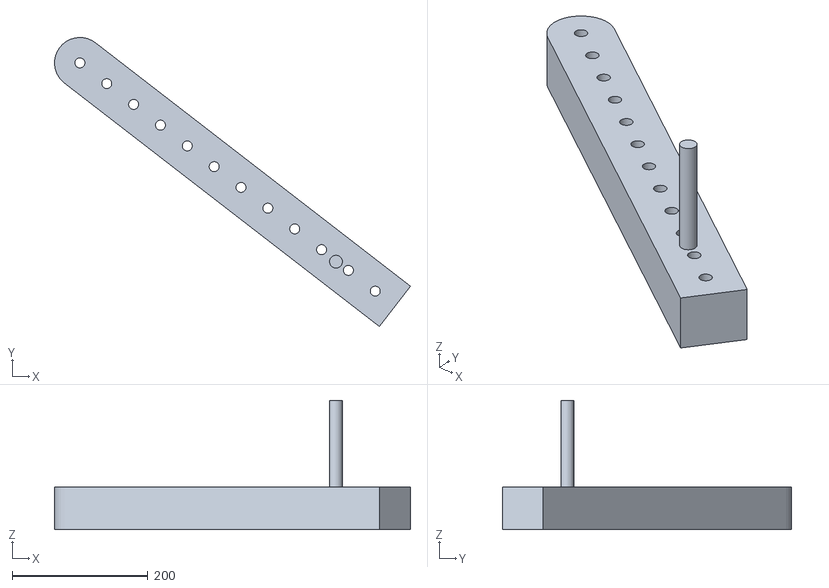
[picture p426: CAD file, 2018-10-10]
Structure/CAD Models/STL/Assemblageextrudeuse - boite transport extrudeuse barre seule-1.STL
524.6 x 425.9 x 190.4
