LF2L/Green-FabLab/Structure/CAD Models/STL/Assemblageextrudeuse - alimentation 3-1 moteur avec disque-1.STL

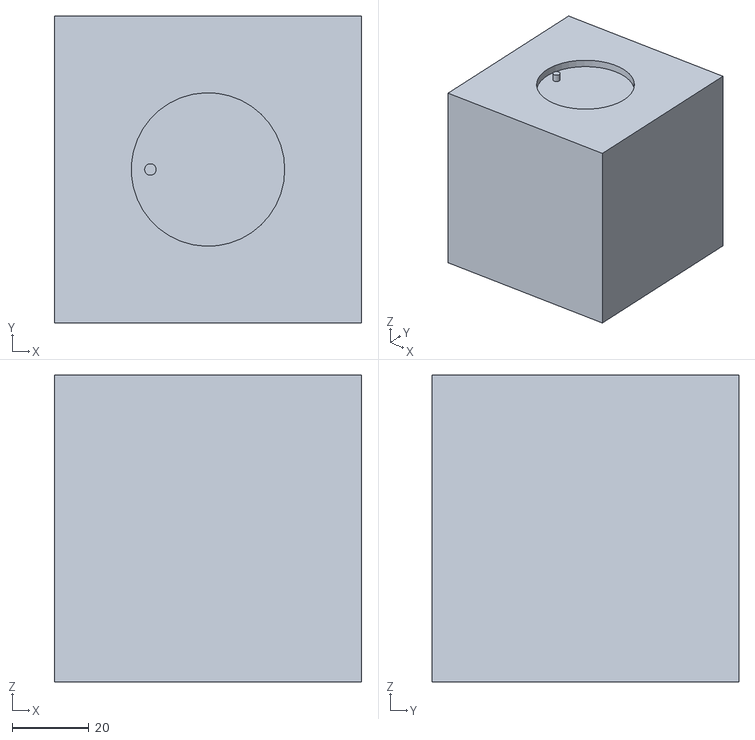
[picture p427: CAD file, 2018-10-10]
Structure/CAD Models/STL/Assemblageextrudeuse - alimentation 3-1 moteur avec disque-1.STL
80.0 x 80.0 x 80.0
