LF2L/Green-FabLab/Structure/CAD Models/STL/Assemblageextrudeuse - extrudeuse-1.STL

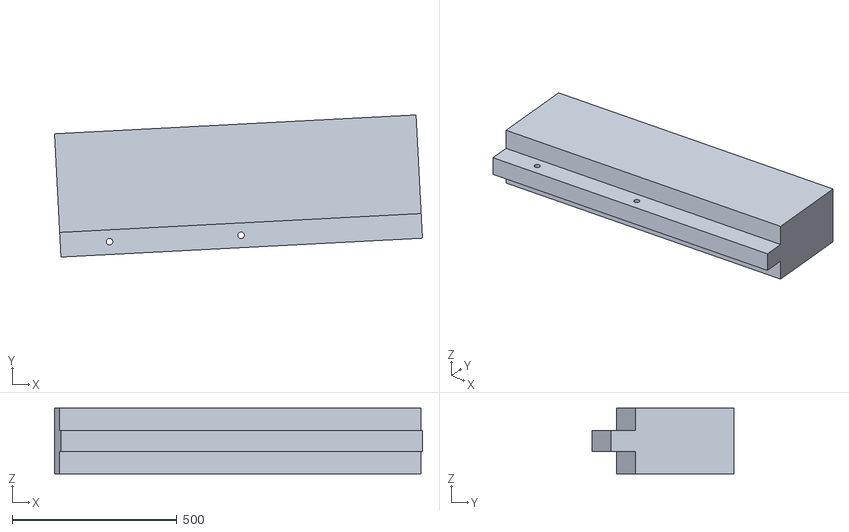
[picture p428: CAD file, 2018-10-10]
Structure/CAD Models/STL/Assemblageextrudeuse - extrudeuse-1.STL
1118.0 x 431.8 x 200.0
