LF2L/Green-FabLab/Structure/CAD Models/STL/Assemblageextrudeuse - alimentation 3-1 plaque de montage-1.STL

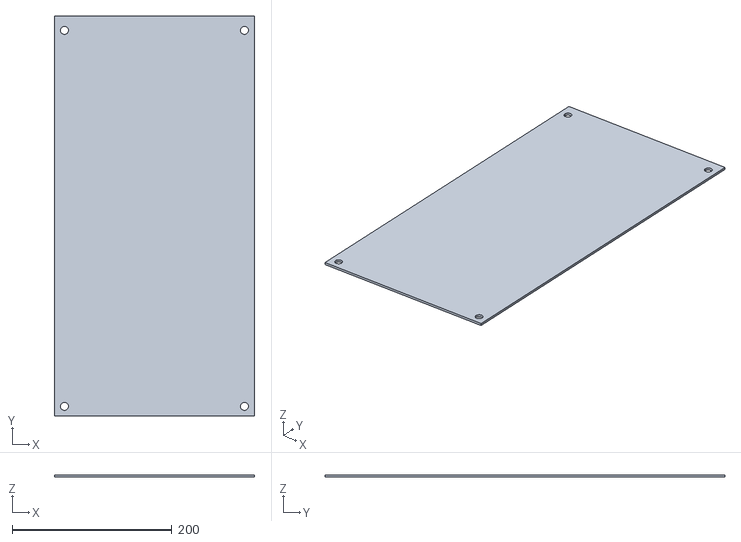
[picture p429: CAD file, 2018-10-10]
Structure/CAD Models/STL/Assemblageextrudeuse - alimentation 3-1 plaque de montage-1.STL
250.0 x 500.0 x 3.00
