LF2L/Green-FabLab/Structure/CAD Models/alimentation 3.SLDASM

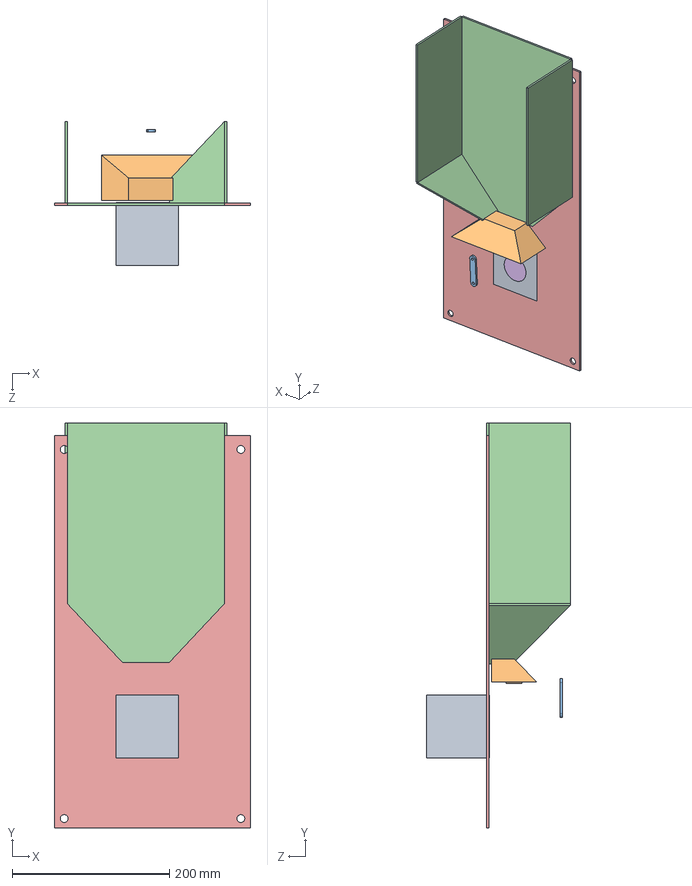
[picture p430: CAD file, 2018-10-10]
Structure/CAD Models/alimentation 3.SLDASM
250.0 x 515.7 x 183.4 mm
moteur avec disque
bouchon
biele
tremie
plaque de montage
disque
