LF2L/Green-FabLab/Feeding/Nicolas : Maxime/CAD/STL-1/Jonction.stl

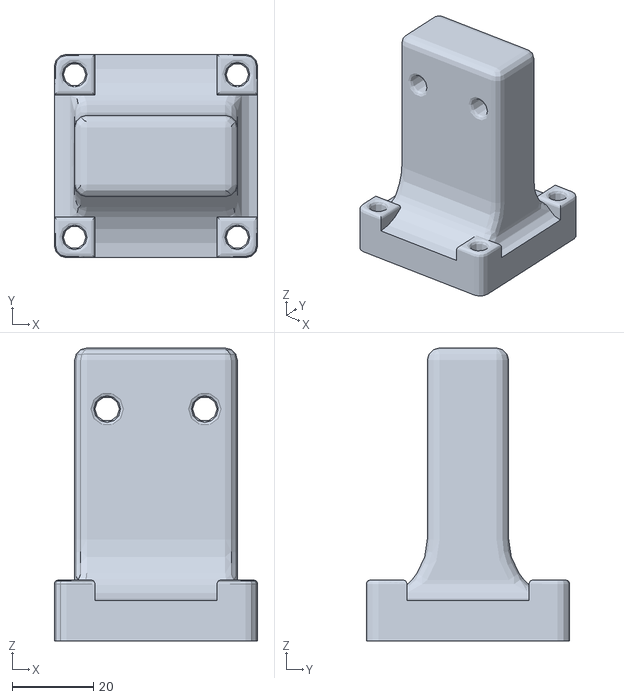
[picture p431: CAD file, 2019-01-22]
Feeding/Nicolas : Maxime/CAD/STL-1/Jonction.stl
50.0 x 50.0 x 72.0
