LF2L/Green-FabLab/Feeding/Nicolas : Maxime/CAD/stl/Boîte pour carte imprimée/Plaque boite cote 2.stl

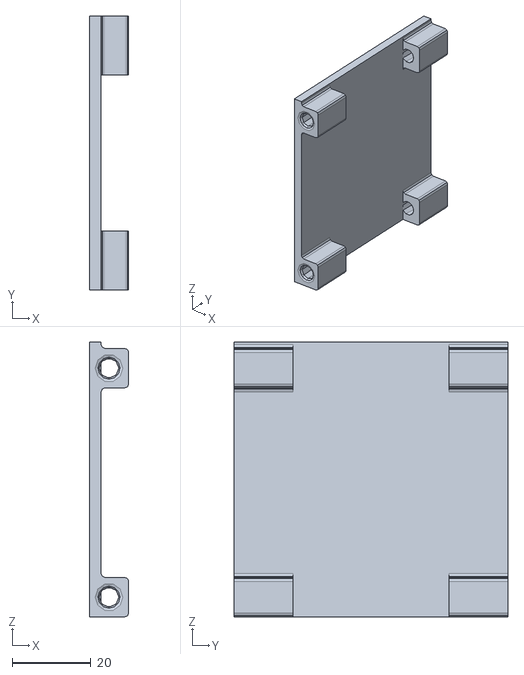
[picture p432: CAD file, 2019-01-22]
Feeding/Nicolas : Maxime/CAD/stl/Boîte pour carte imprimée/Plaque boite cote 2.stl
10.0 x 69.4 x 69.6
