LF2L/Green-FabLab/Feeding/Nicolas : Maxime/CAD/Winch/Pouet.stl

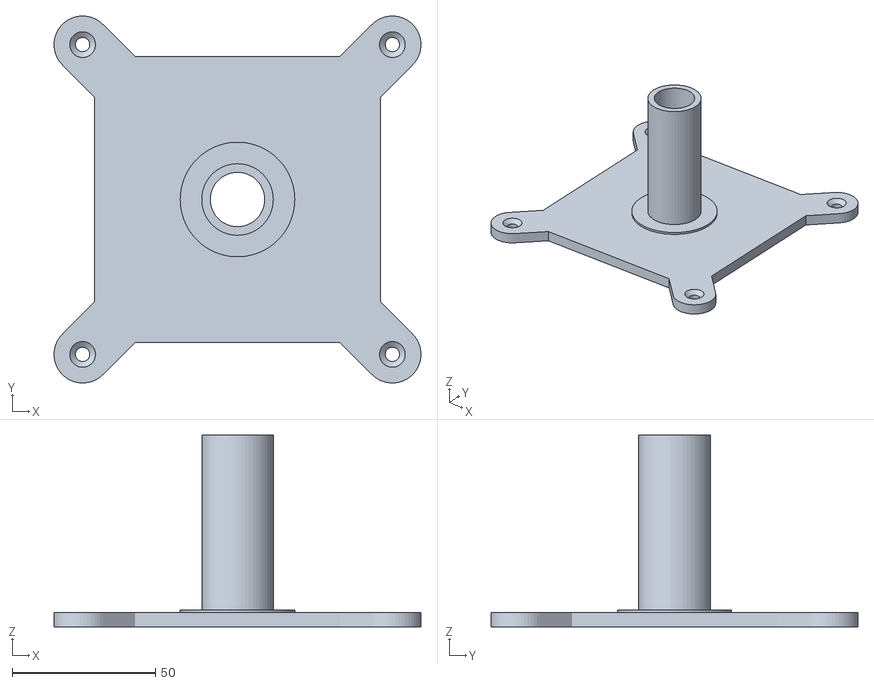
[picture p433: CAD file, 2019-01-22]
Feeding/Nicolas : Maxime/CAD/Winch/Pouet.stl
128.1 x 128.1 x 67.0
