LF2L/Green-FabLab/Feeding/Nicolas : Maxime/CAD/STL-1/Charniere alesage 2.stl

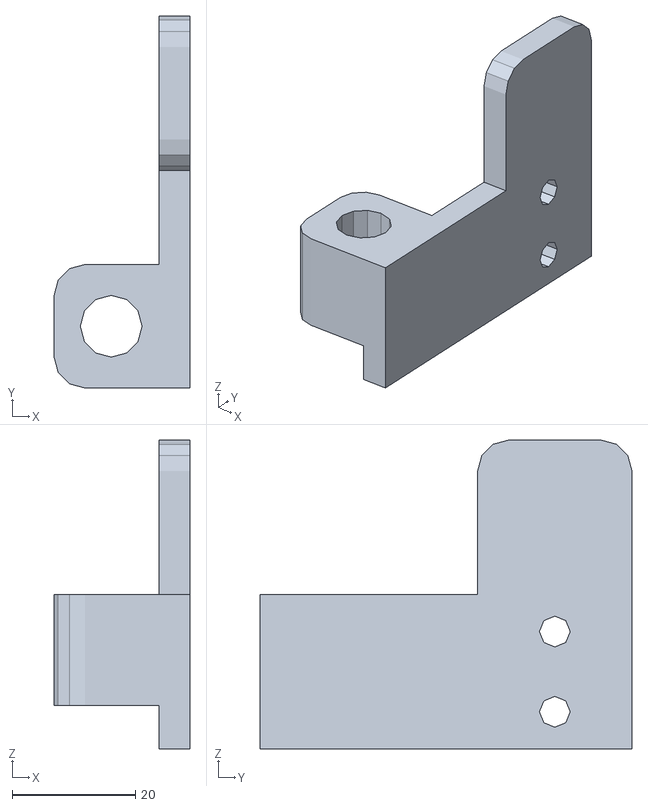
[picture p434: CAD file, 2019-01-22]
Feeding/Nicolas : Maxime/CAD/STL-1/Charniere alesage 2.stl
22.0 x 60.2 x 50.0
