LF2L/Green-FabLab/Feeding/Nicolas : Maxime/CAD/stl/Boîte pour carte imprimée/Cote cables boite.stl

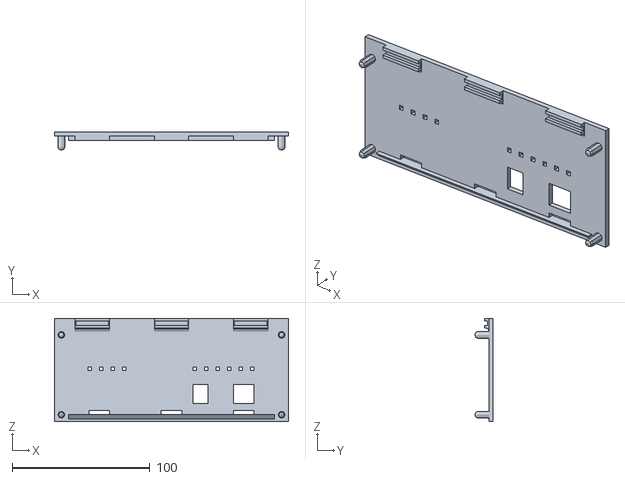
[picture p435: CAD file, 2019-01-22]
Feeding/Nicolas : Maxime/CAD/stl/Boîte pour carte imprimée/Cote cables boite.stl
170.0 x 13.0 x 75.0
