LF2L/Green-FabLab/Feeding/Nicolas : Maxime/CAD/Winch/1_Winch_v30_Kurbel_1_Body1.stl

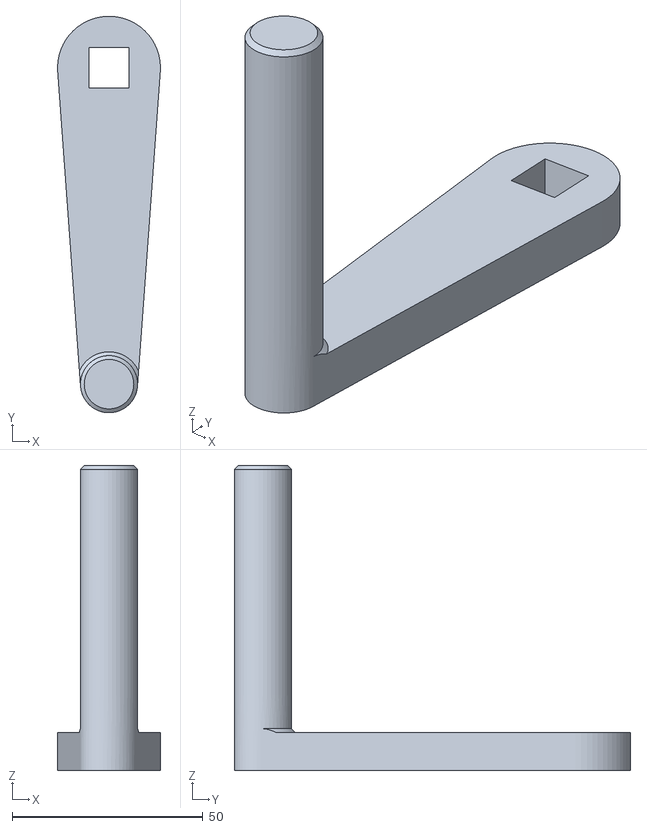
[picture p436: CAD file, 2019-01-22]
Feeding/Nicolas : Maxime/CAD/Winch/1_Winch_v30_Kurbel_1_Body1.stl
27.0 x 104.0 x 80.0
