LF2L/Green-FabLab/Structure/CAD Models/boite transport.SLDPRT

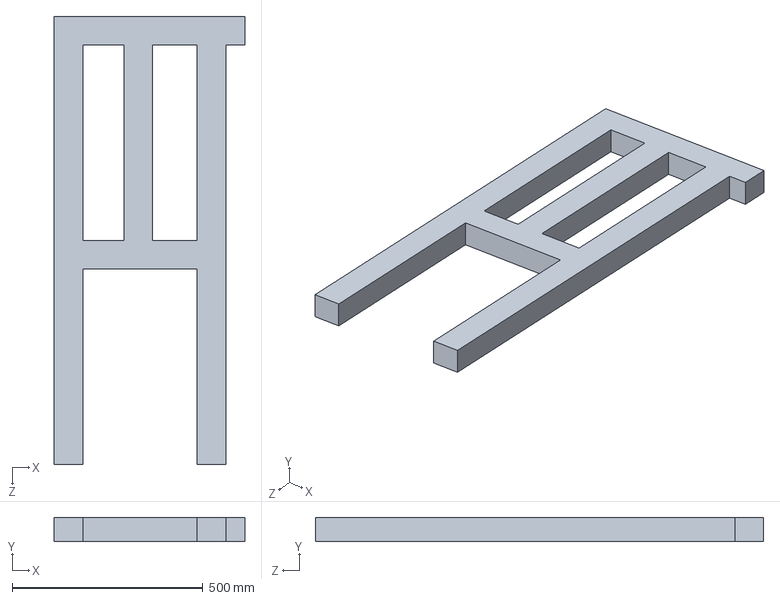
[picture p437: CAD file, 2018-10-10]
Structure/CAD Models/boite transport.SLDPRT
500.0 x 63.0 x 1175.0 mm
