LF2L/Green-FabLab/Feeding/Nicolas : Maxime/CAD/STL-1/Boule.stl

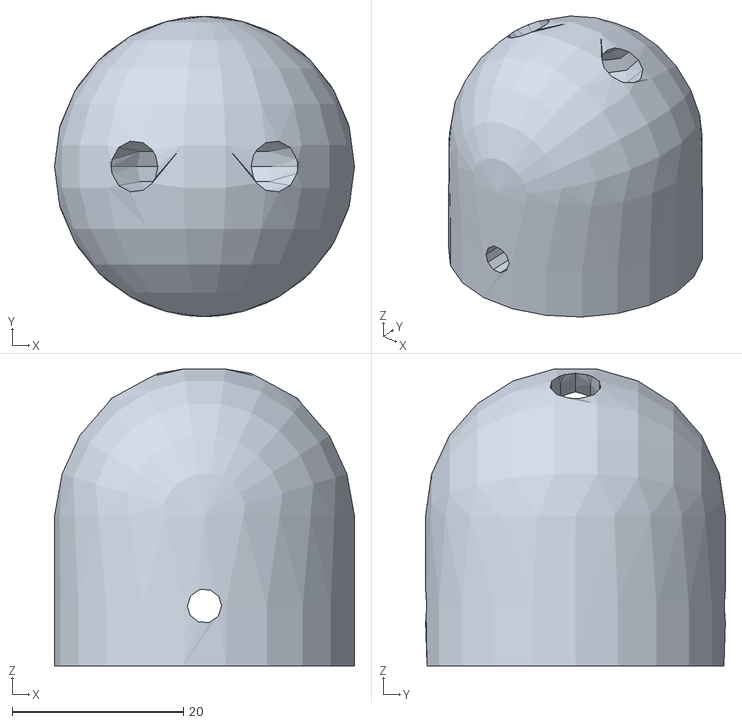
[picture p438: CAD file, 2019-01-22]
Feeding/Nicolas : Maxime/CAD/STL-1/Boule.stl
35.0 x 35.0 x 34.6
