LF2L/Green-FabLab/Feeding/Nicolas : Maxime/CAD/stl/Boîte pour carte imprimée/Plaque boite cote 1.stl

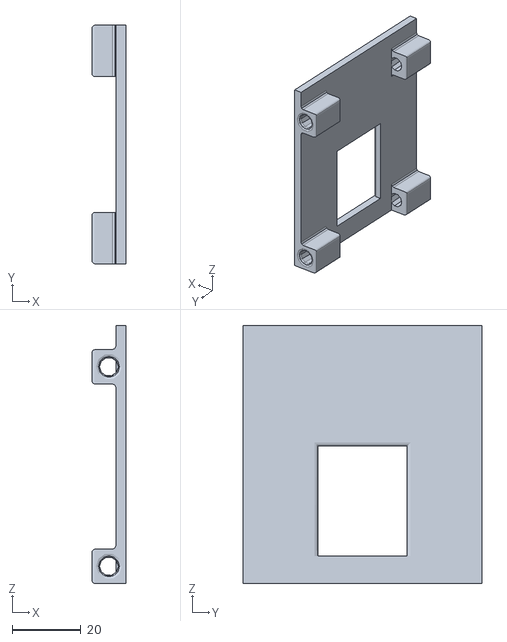
[picture p439: CAD file, 2019-01-22]
Feeding/Nicolas : Maxime/CAD/stl/Boîte pour carte imprimée/Plaque boite cote 1.stl
10.0 x 69.4 x 75.0
