LF2L/Green-FabLab/Feeding/Nicolas : Maxime/CAD/Winch/1_Winch_v30_Schraube_1_Body1.stl

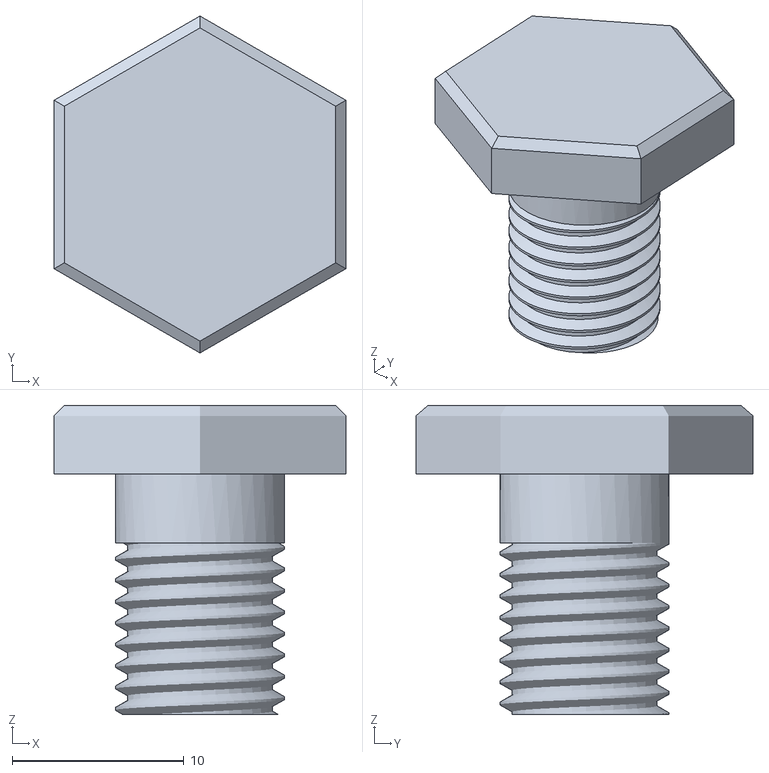
[picture p440: CAD file, 2019-01-22]
Feeding/Nicolas : Maxime/CAD/Winch/1_Winch_v30_Schraube_1_Body1.stl
17.0 x 19.6 x 18.0
