LF2L/Green-FabLab/Feeding/Nicolas : Maxime/CAD/STL-1/Demi 1.stl

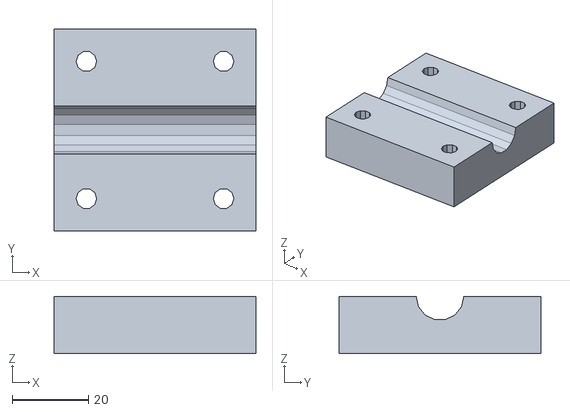
[picture p441: CAD file, 2019-01-22]
Feeding/Nicolas : Maxime/CAD/STL-1/Demi 1.stl
53.0 x 53.0 x 15.0
