LF2L/Green-FabLab/Feeding/Nicolas : Maxime/CAD/stl/Boîte pour carte imprimée/Cote sans cable boite.stl

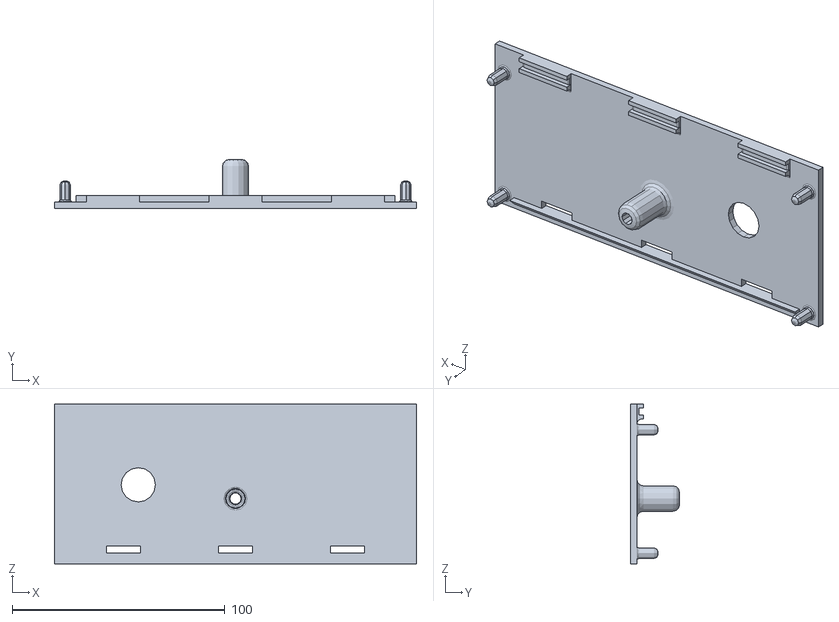
[picture p442: CAD file, 2019-01-22]
Feeding/Nicolas : Maxime/CAD/stl/Boîte pour carte imprimée/Cote sans cable boite.stl
170.0 x 23.0 x 75.0
