LF2L/Green-FabLab/Feeding/Nicolas : Maxime/CAD/Winch/1_Winch_v30_Zahnrad_gross_1_Body2.stl

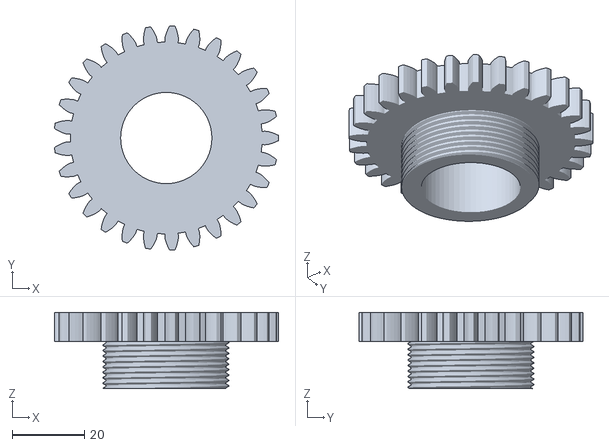
[picture p443: CAD file, 2019-01-22]
Feeding/Nicolas : Maxime/CAD/Winch/1_Winch_v30_Zahnrad_gross_1_Body2.stl
61.9 x 62.0 x 21.0
