LF2L/Green-FabLab/Structure/CAD Models/plaques rotation.SLDPRT

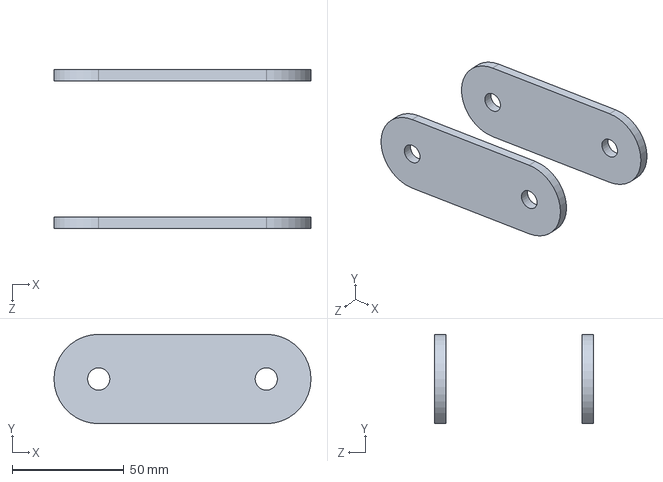
[picture p444: CAD file, 2018-10-10]
Structure/CAD Models/plaques rotation.SLDPRT
115.0 x 40.0 x 71.0 mm
