LF2L/Green-FabLab/Feeding/Nicolas : Maxime/CAD/STL-1/Cage a aimant.stl

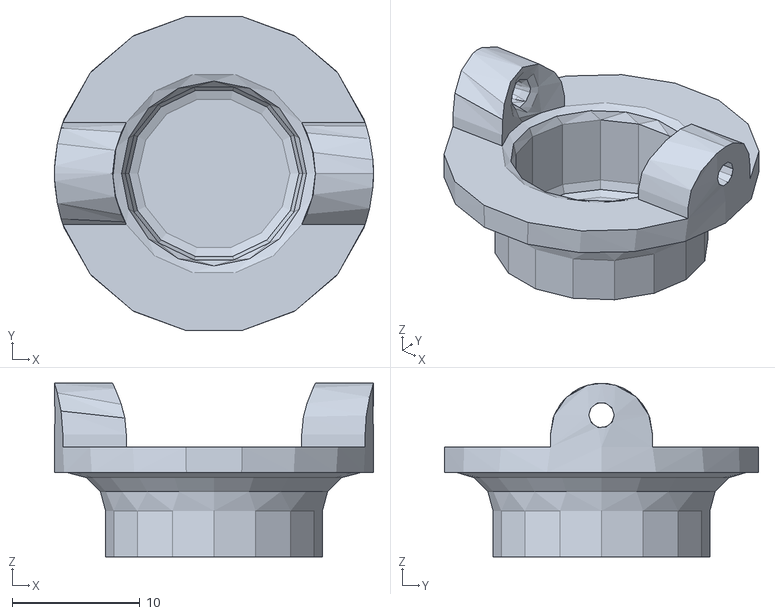
[picture p445: CAD file, 2019-01-22]
Feeding/Nicolas : Maxime/CAD/STL-1/Cage a aimant.stl
25.0 x 24.6 x 13.6
