LF2L/Green-FabLab/Feeding/Nicolas : Maxime/CAD/Winch/1_Winch_v30_Ratsche_1_Body1.stl

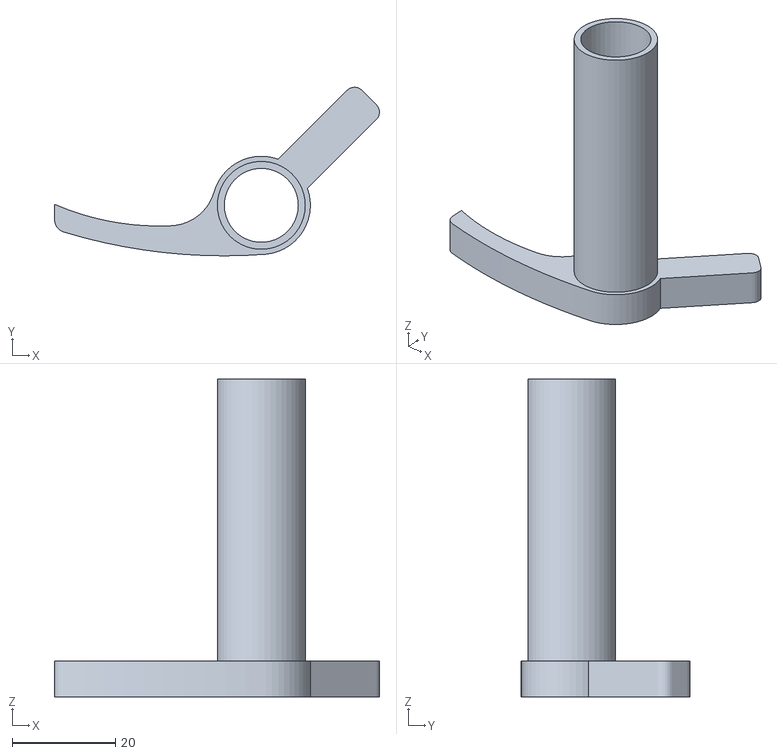
[picture p446: CAD file, 2019-01-22]
Feeding/Nicolas : Maxime/CAD/Winch/1_Winch_v30_Ratsche_1_Body1.stl
62.9 x 32.6 x 61.5
