LF2L/Green-FabLab/Feeding/Nicolas : Maxime/CAD/STL-1/Bouchon.stl

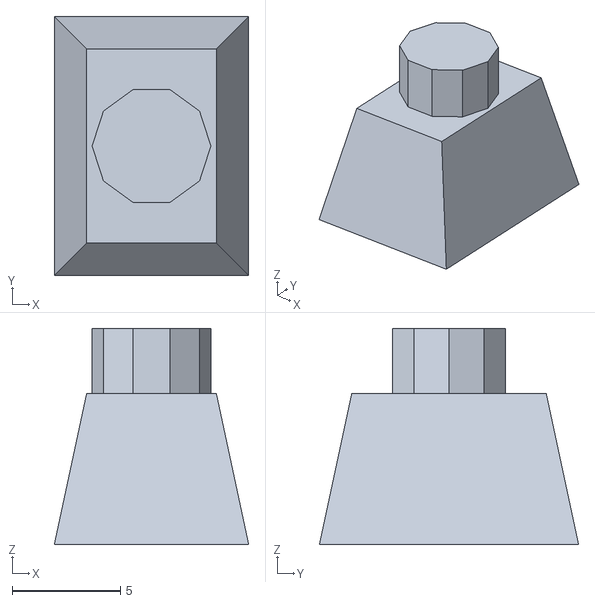
[picture p447: CAD file, 2019-01-22]
Feeding/Nicolas : Maxime/CAD/STL-1/Bouchon.stl
9.00 x 12.0 x 10.0
