LF2L/Green-FabLab/Feeding/Nicolas : Maxime/CAD/Winch/1_Winch_v30_Widerlager_1_1_Body1.stl

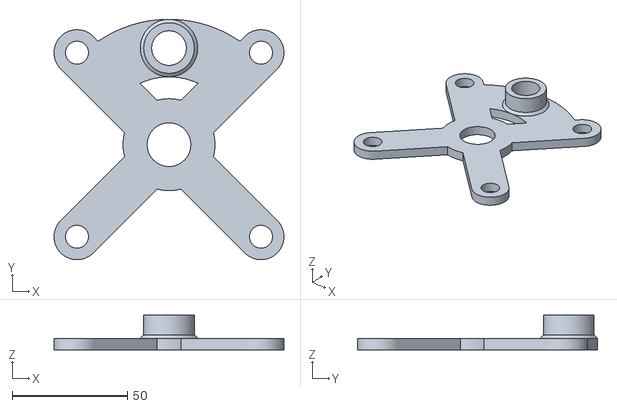
[picture p448: CAD file, 2019-01-22]
Feeding/Nicolas : Maxime/CAD/Winch/1_Winch_v30_Widerlager_1_1_Body1.stl
100.0 x 104.5 x 15.0
