LF2L/Green-FabLab/Feeding/Nicolas : Maxime/CAD/STL-1/Potence.stl

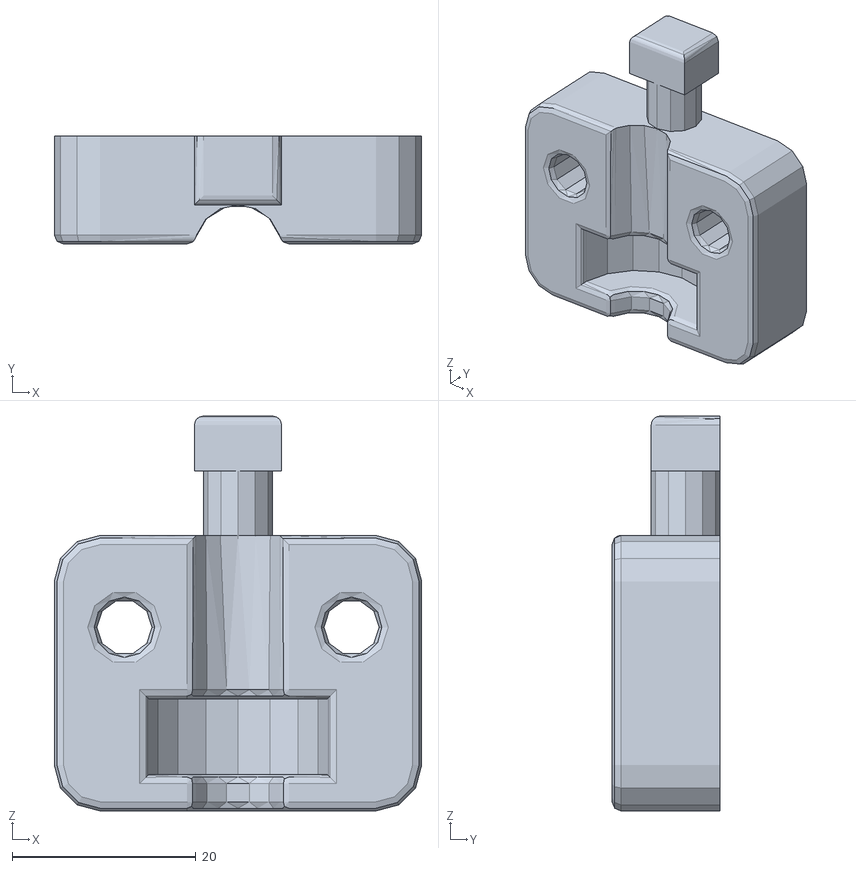
[picture p449: CAD file, 2019-01-22]
Feeding/Nicolas : Maxime/CAD/STL-1/Potence.stl
40.0 x 11.8 x 43.0
