LF2L/Green-FabLab/Feeding/Nicolas : Maxime/CAD/Winch/1_Winch_v30_Scheibe_1_Body1.stl

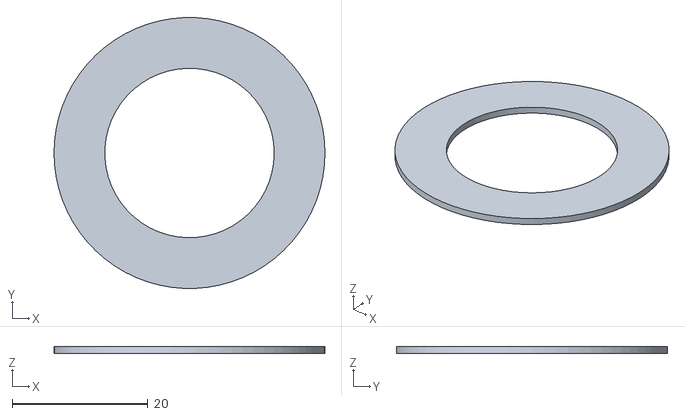
[picture p450: CAD file, 2019-01-22]
Feeding/Nicolas : Maxime/CAD/Winch/1_Winch_v30_Scheibe_1_Body1.stl
40.0 x 40.0 x 1.00
