LF2L/Green-FabLab/Feeding/Nicolas : Maxime/CAD/STL-1/Charniere pointe.stl

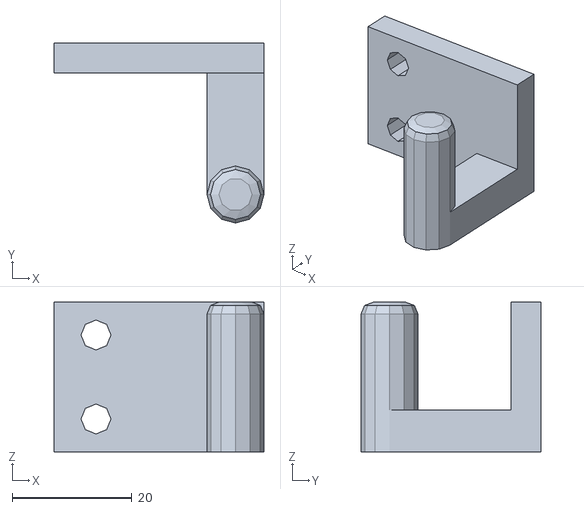
[picture p451: CAD file, 2019-01-22]
Feeding/Nicolas : Maxime/CAD/STL-1/Charniere pointe.stl
35.0 x 30.0 x 25.0
