LF2L/Green-FabLab/Feeding/Nicolas : Maxime/CAD/Winch/1_Winch_v30_Bolzen_1_Body1.stl

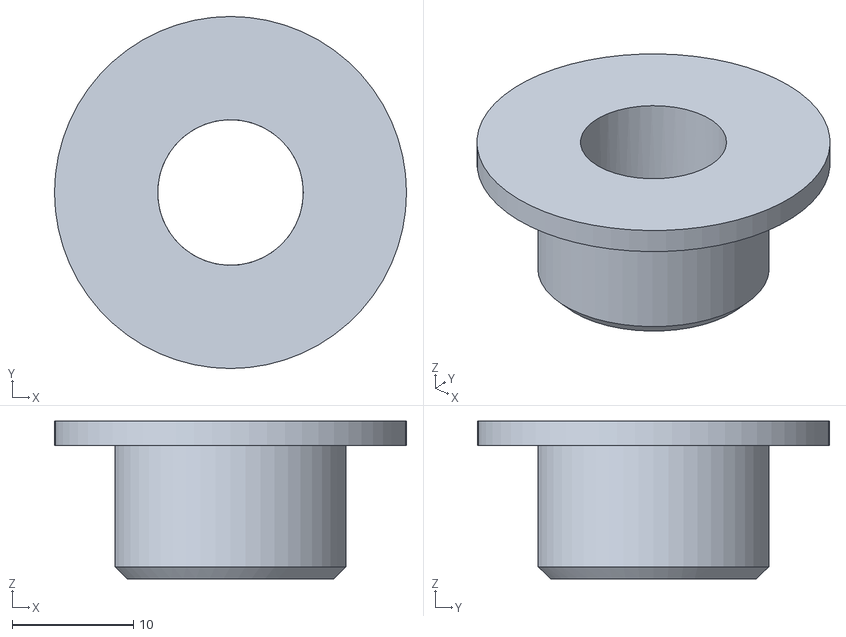
[picture p452: CAD file, 2019-01-22]
Feeding/Nicolas : Maxime/CAD/Winch/1_Winch_v30_Bolzen_1_Body1.stl
29.0 x 29.0 x 13.0
