LF2L/Green-FabLab/Feeding/Nicolas : Maxime/CAD/STL-1/Pommeau.stl

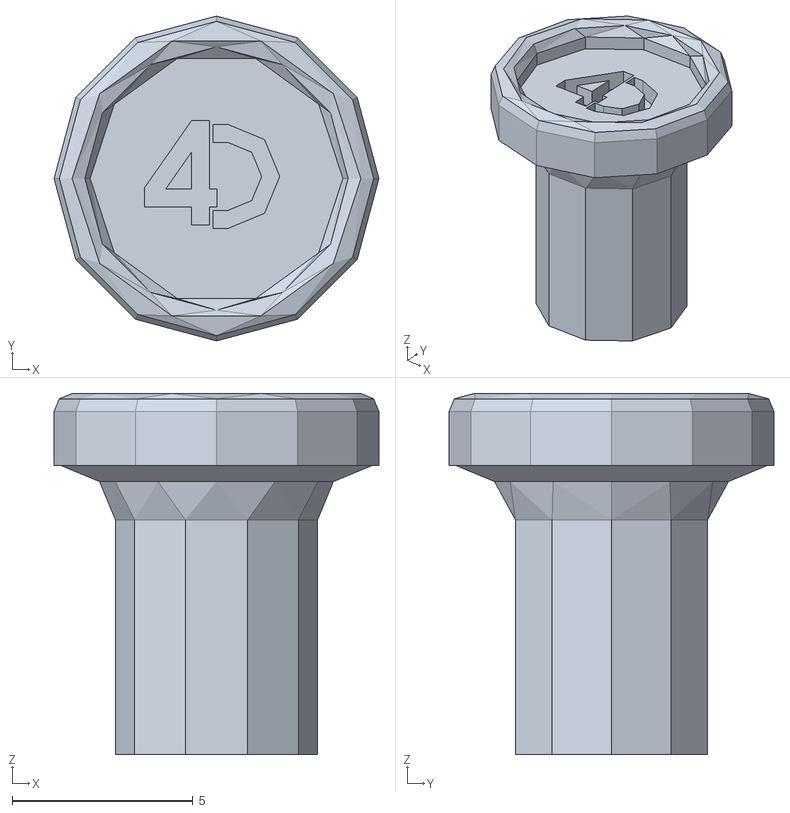
[picture p453: CAD file, 2019-01-22]
Feeding/Nicolas : Maxime/CAD/STL-1/Pommeau.stl
9.00 x 9.00 x 10.0
