LF2L/Green-FabLab/Feeding/Nicolas : Maxime/CAD/Winch/1_Winch_v30_Zahnrad_klein_1_Gear__2.60_pitch_dia._.stl

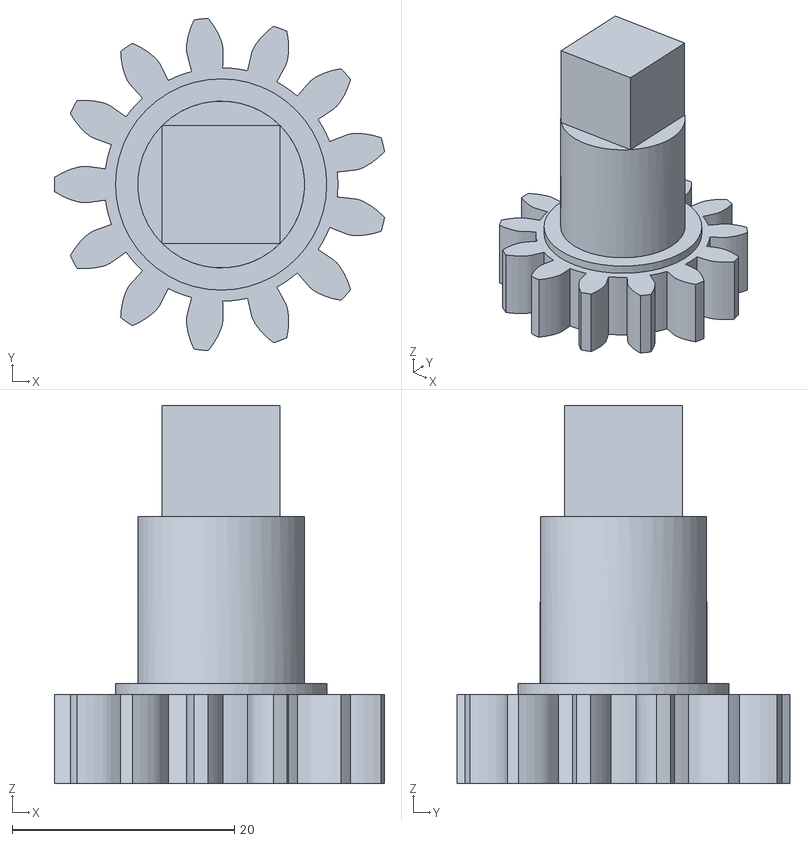
[picture p454: CAD file, 2019-01-22]
Feeding/Nicolas : Maxime/CAD/Winch/1_Winch_v30_Zahnrad_klein_1_Gear__2.60_pitch_dia._.stl
29.7 x 29.9 x 34.0
