LF2L/Green-FabLab/Structure/CAD Models/boite transport extrudeuse barre seule.SLDPRT

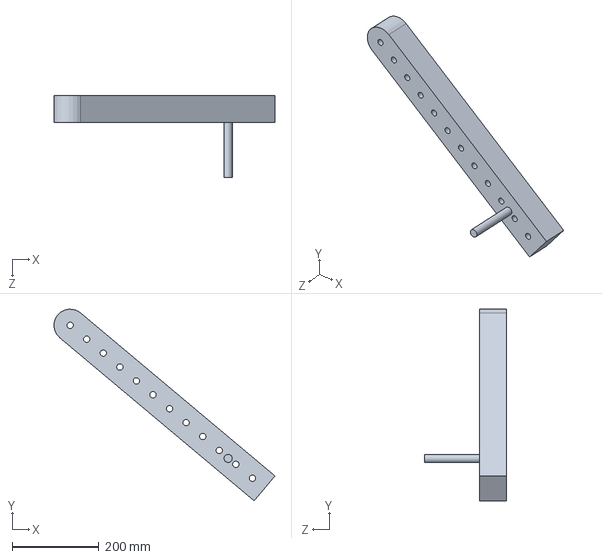
[picture p455: CAD file, 2018-10-10]
Structure/CAD Models/boite transport extrudeuse barre seule.SLDPRT
511.0 x 443.1 x 190.4 mm
