LF2L/Green-FabLab/Feeding/Nicolas : Maxime/CAD/STL-1/Poignee.stl

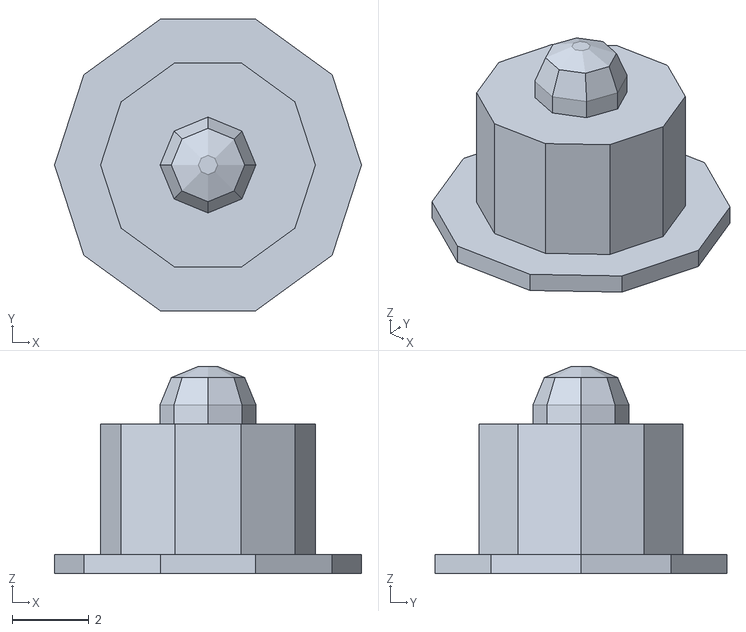
[picture p456: CAD file, 2019-01-22]
Feeding/Nicolas : Maxime/CAD/STL-1/Poignee.stl
8.00 x 7.61 x 5.40
