LF2L/Green-FabLab/Feeding/Nicolas : Maxime/CAD/Winch/17_mm_Wrench.stl

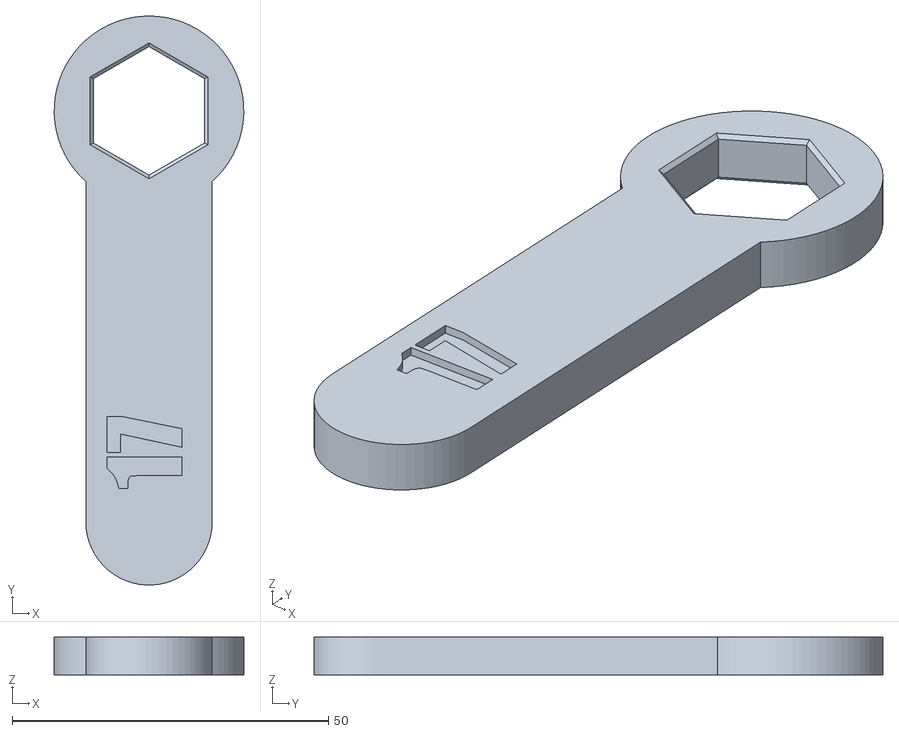
[picture p457: CAD file, 2019-01-22]
Feeding/Nicolas : Maxime/CAD/Winch/17_mm_Wrench.stl
30.0 x 90.0 x 6.00
