LF2L/Green-FabLab/Structure/CAD Models/entonnoir.SLDPRT

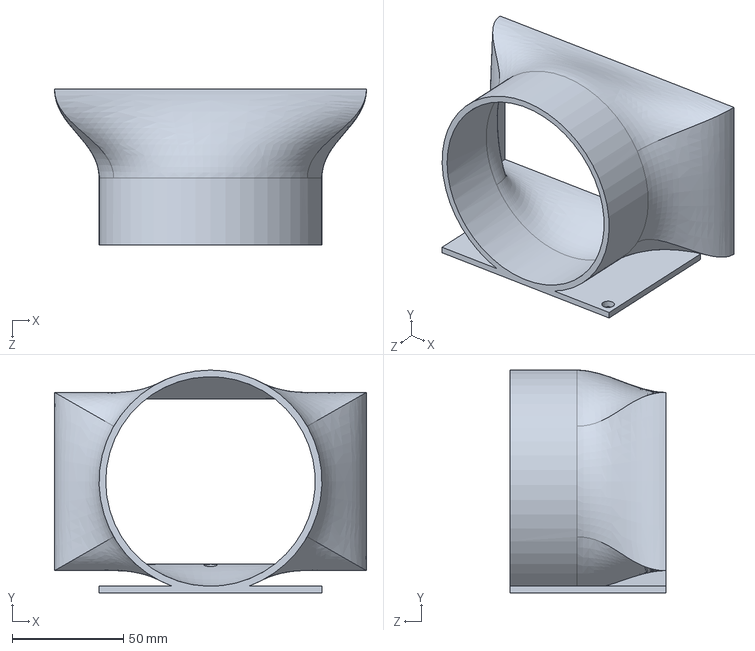
[picture p458: CAD file, 2018-10-10]
Structure/CAD Models/entonnoir.SLDPRT
140.0 x 100.0 x 70.0 mm
