LF2L/Green-FabLab/Feeding/Nicolas : Maxime/CAD/STL-1/Charniere alesage.stl

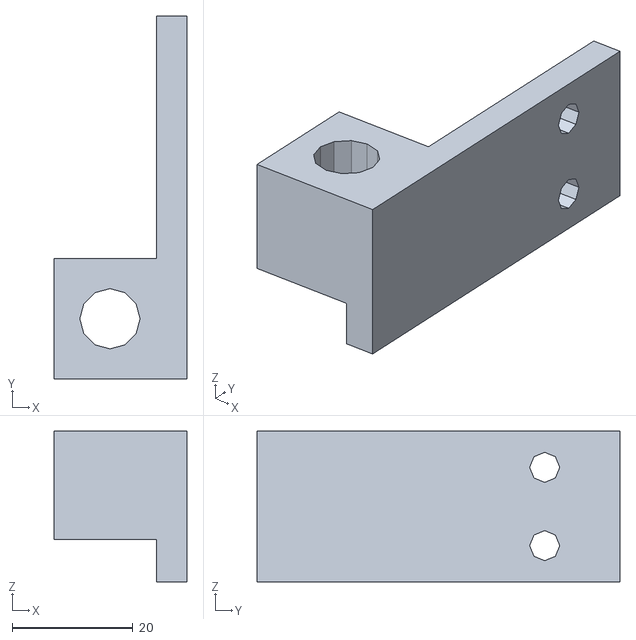
[picture p459: CAD file, 2019-01-22]
Feeding/Nicolas : Maxime/CAD/STL-1/Charniere alesage.stl
22.0 x 60.2 x 25.0
