LF2L/Green-FabLab/Feeding/Nicolas : Maxime/CAD/Winch/1_Winch_v30_Spule_oben_1_Body1.stl

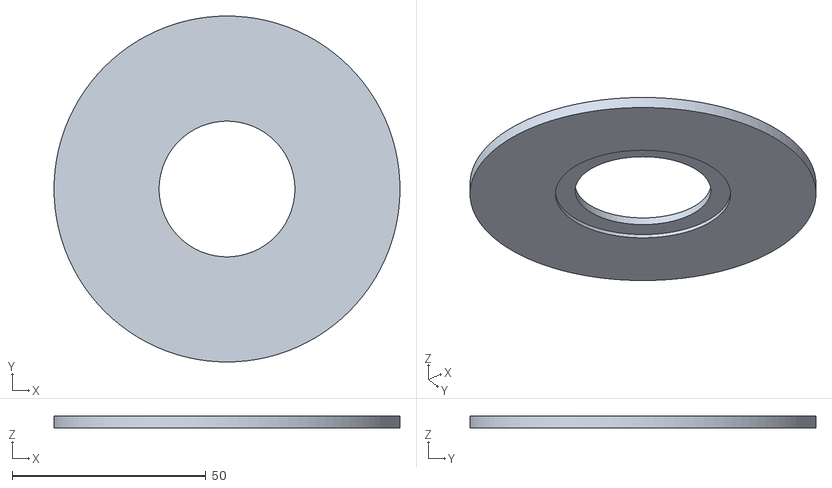
[picture p460: CAD file, 2019-01-22]
Feeding/Nicolas : Maxime/CAD/Winch/1_Winch_v30_Spule_oben_1_Body1.stl
89.2 x 89.2 x 3.00
