LF2L/Green-FabLab/Structure/CAD Models/boite transport extrudeuse ensemble.SLDPRT

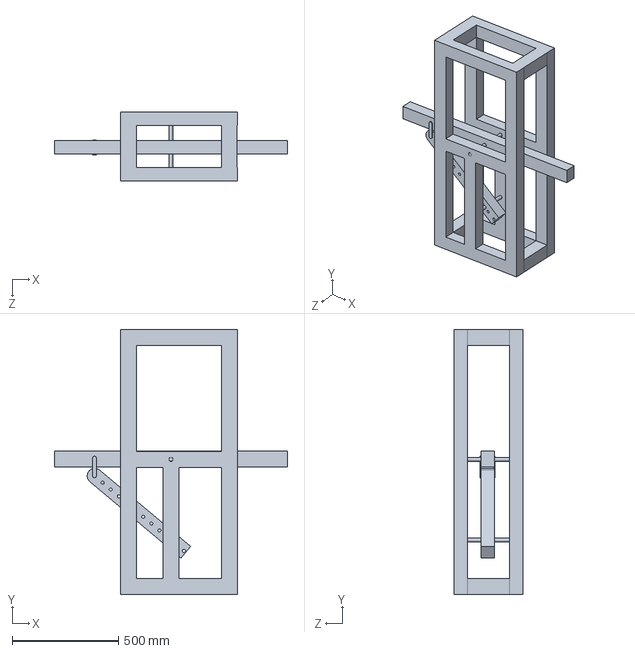
[picture p461: CAD file, 2018-10-10]
Structure/CAD Models/boite transport extrudeuse ensemble.SLDPRT
1100.0 x 1250.0 x 326.0 mm
