LF2L/Green-FabLab/Feeding/Nicolas : Maxime/CAD/STL-1/Cale1 - 50.stl

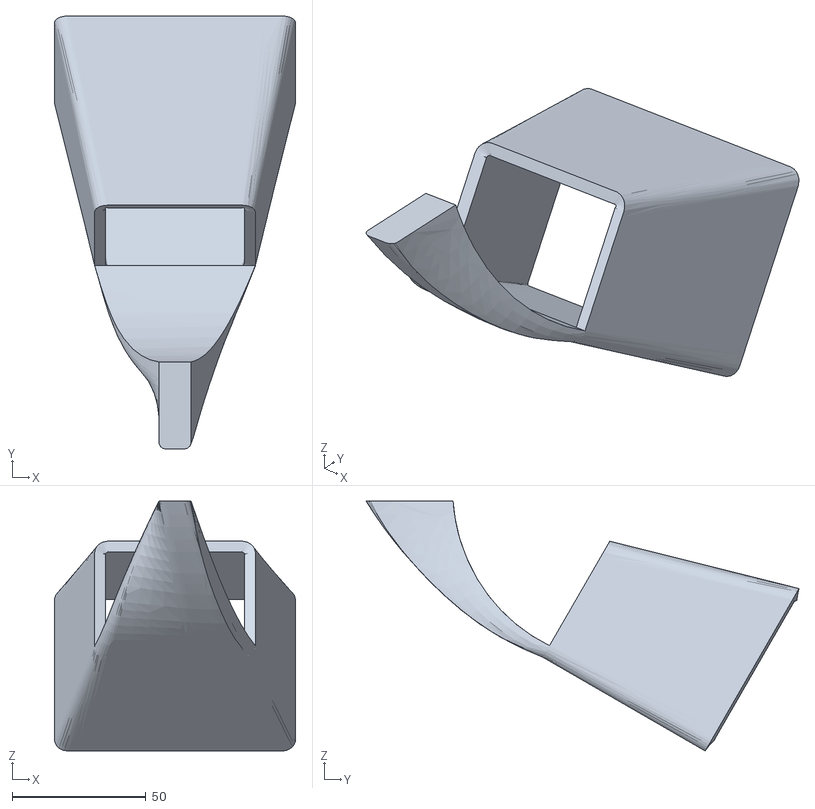
[picture p462: CAD file, 2019-01-22]
Feeding/Nicolas : Maxime/CAD/STL-1/Cale1 - 50.stl
90.0 x 161.6 x 93.3
