LF2L/Green-FabLab/Feeding/Nicolas : Maxime/CAD/Winch/1_Winch_v30_Spule_unten_1_Body1.stl

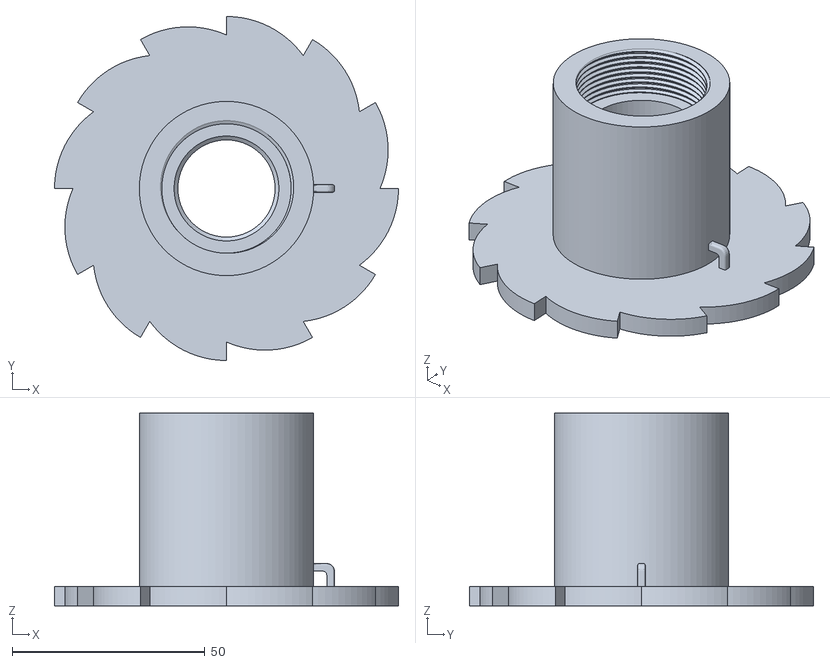
[picture p463: CAD file, 2019-01-22]
Feeding/Nicolas : Maxime/CAD/Winch/1_Winch_v30_Spule_unten_1_Body1.stl
89.2 x 89.2 x 50.0
