LF2L/Green-FabLab/Structure/CAD Models/biele.SLDPRT

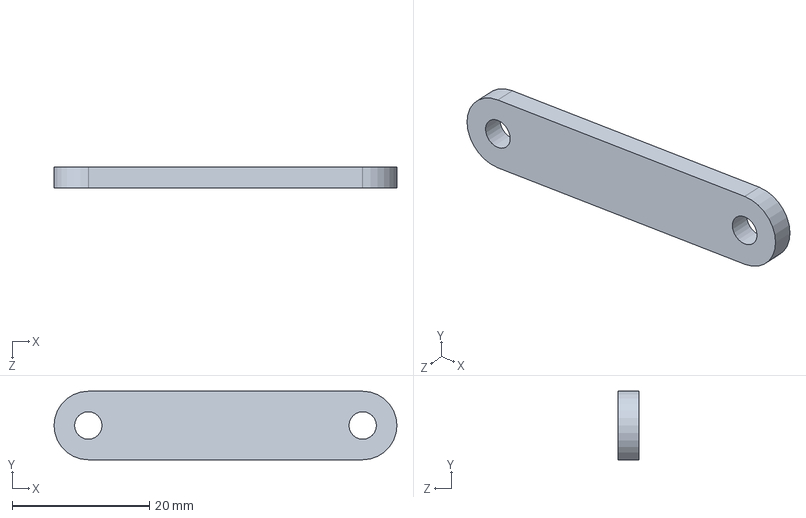
[picture p464: CAD file, 2018-10-10]
Structure/CAD Models/biele.SLDPRT
50.0 x 10.0 x 3.00 mm
