LF2L/Green-FabLab/Feeding/Nicolas : Maxime/CAD/STL-1/Entonnoir.stl

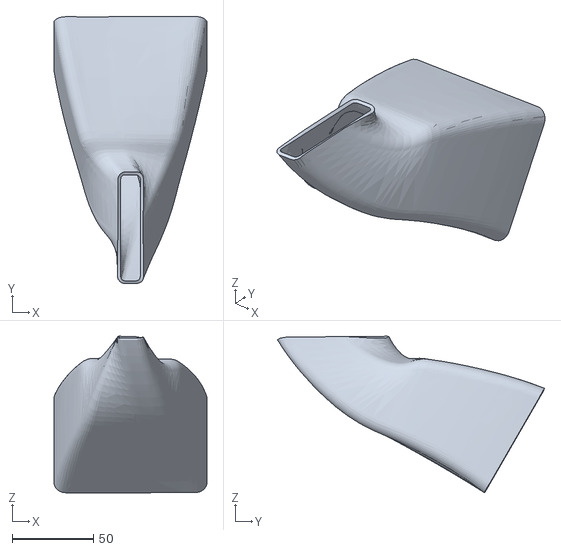
[picture p465: CAD file, 2019-01-22]
Feeding/Nicolas : Maxime/CAD/STL-1/Entonnoir.stl
94.0 x 164.0 x 96.2
