LF2L/Green-FabLab/Feeding/Nicolas : Maxime/CAD/Winch/1_Winch_v30_Koerper_1_Body1.stl

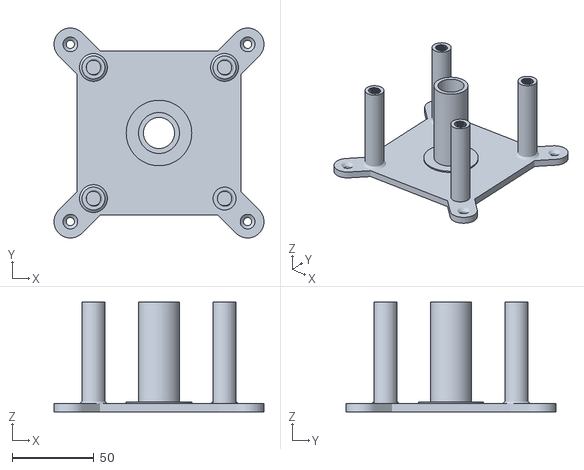
[picture p466: CAD file, 2019-01-22]
Feeding/Nicolas : Maxime/CAD/Winch/1_Winch_v30_Koerper_1_Body1.stl
128.1 x 128.1 x 67.0
