LF2L/Green-FabLab/Structure/CAD Models/extrudeuse.SLDPRT

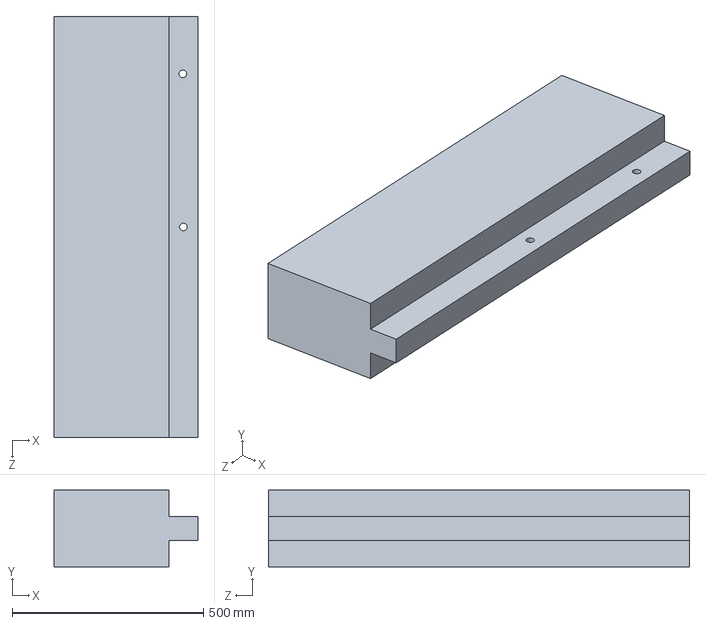
[picture p467: CAD file, 2018-10-10]
Structure/CAD Models/extrudeuse.SLDPRT
375.0 x 200.0 x 1100.0 mm
