LF2L/Green-FabLab/Structure/CAD Models/boite transport extrudeuse 2.SLDPRT

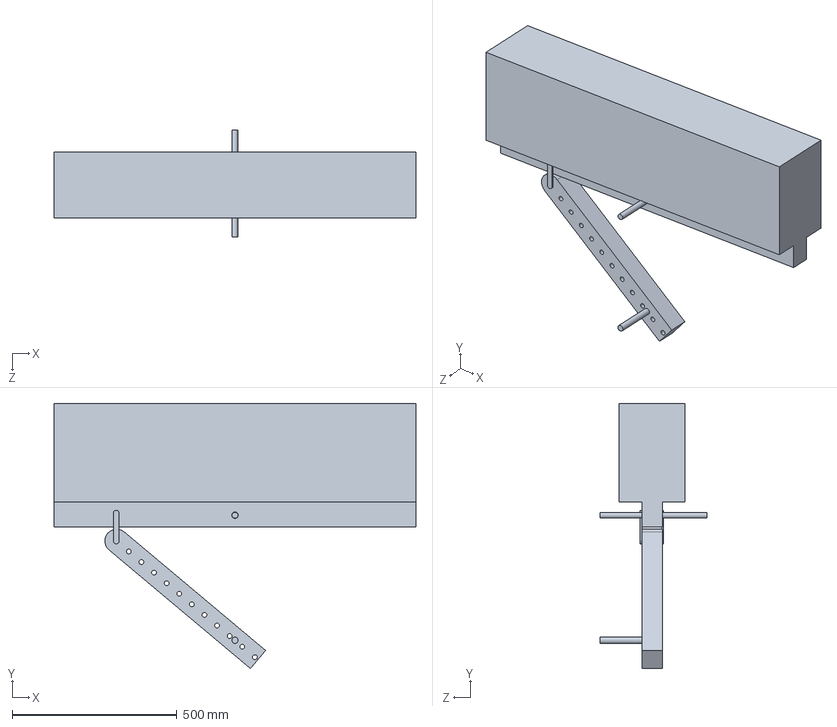
[picture p468: CAD file, 2018-10-10]
Structure/CAD Models/boite transport extrudeuse 2.SLDPRT
1100.0 x 805.5 x 326.0 mm
