LF2L/Green-FabLab/(list of files, cad)

Other CAD files:
Structure/CAD Models/alimentation 2.SLDASM
Structure/CAD Models/tremie.SLDPRT
Structure/CAD Models/entonnoir 2.SLDPRT
Structure/CAD Models/disque.SLDPRT
Structure/CAD Models/bouchon.SLDPRT
Structure/CAD Models/boite transport extrudeuse.SLDPRT
Structure/CAD Models/plaque de montage.SLDPRT
Structure/CAD Models/boite transport extrudeuse seule.SLDPRT
Structure/CAD Models/moteur avec disque.SLDPRT
Feeding/Nicolas : Maxime/CAD/Pieces 3D/Assemblage poignee.CATProduct
Feeding/Nicolas : Maxime/CAD/Pieces 3D/Boite assemblage.CATProduct
Feeding/Nicolas : Maxime/CAD/Pieces 3D/Bouchon.CATPart
Feeding/Nicolas : Maxime/CAD/Pieces 3D/Boule.CATPart
Feeding/Nicolas : Maxime/CAD/Pieces 3D/Cage a aimant.CATPart
Feeding/Nicolas : Maxime/CAD/Pieces 3D/Cale1.CATPart
Feeding/Nicolas : Maxime/CAD/Pieces 3D/Charniere alesage 2.CATPart
Feeding/Nicolas : Maxime/CAD/Pieces 3D/Charniere alesage.CATPart
Feeding/Nicolas : Maxime/CAD/Pieces 3D/Charniere pointe.CATPart
Feeding/Nicolas : Maxime/CAD/Pieces 3D/Conduit.CATProduct
Feeding/Nicolas : Maxime/CAD/Pieces 3D/Cote cables boite.CATPart
Feeding/Nicolas : Maxime/CAD/Pieces 3D/Cote sans cable boite.CATPart
Feeding/Nicolas : Maxime/CAD/Pieces 3D/Demi 1.CATPart
Feeding/Nicolas : Maxime/CAD/Pieces 3D/Entonnoir.CATPart
Feeding/Nicolas : Maxime/CAD/Pieces 3D/Equerre.CATPart
Feeding/Nicolas : Maxime/CAD/Pieces 3D/Fixation.CATProduct
Feeding/Nicolas : Maxime/CAD/Pieces 3D/Fond boite.CATPart
Feeding/Nicolas : Maxime/CAD/Pieces 3D/Jonction.CATPart
Feeding/Nicolas : Maxime/CAD/Pieces 3D/Petite plaque droite.CATPart
Feeding/Nicolas : Maxime/CAD/Pieces 3D/Plaque avant.CATPart
Feeding/Nicolas : Maxime/CAD/Pieces 3D/Plaque boite cote 1.CATPart
Feeding/Nicolas : Maxime/CAD/Pieces 3D/Plaque boite cote 2.CATPart
Feeding/Nicolas : Maxime/CAD/Pieces 3D/Plaque droite.CATPart
Feeding/Nicolas : Maxime/CAD/Pieces 3D/Plaque gauche.CATPart
Feeding/Nicolas : Maxime/CAD/Pieces 3D/Plaque oblique.CATPart
Feeding/Nicolas : Maxime/CAD/Pieces 3D/Poignee.CATPart
Feeding/Nicolas : Maxime/CAD/Pieces 3D/Pommeau.CATPart
Feeding/Nicolas : Maxime/CAD/Pieces 3D/Potence.CATPart
Feeding/Nicolas : Maxime/CAD/Pieces 3D/Product1.CATProduct
Structure/CAD Models/STL/boite transport extrudeuse.STL
