LF2L/Green-FabLab/(threads)

Thread 1 (2018-10-17):

Documentation of the of the elements on Wiki in English

fabbiocrux, 2018-10-17:

ennesserB, 2018-10-17:
Hy,
 wonderful initiative !!!

fabbiocrux, 2018-10-17:
@Tates29 tous les images du nouveau site du LF2L (https://lf2l.github.io/) sont ici https://github.com/LF2L/lf2l.github.io/tree/source/assets/images
tu peux eventuelment les réutiliser.
Ceux qui sont au projet sont: https://github.com/LF2L/lf2l.github.io/tree/source/assets/images/3-projects/gf

fabbiocrux, 2018-10-18:
Outil interesante pour faire de graphics/ trouver inspiration
https://www.canva.com/

Thread 5 (2019-01-14):

#### Extrude with PLA virgin pellets

fabbiocrux, 2019-01-14:
Goals:
- [ ] Learn to use the extruder machine
- [ ] Validation of the operational conditions done in the previous work for extruding good quality filament
- [ ] Data collection
- [ ]  Documentation of the process in the Wiki
- [ ]  Description of elements to improve in the current prototype
