LF2L/Green-FabLab/Concept Ideas/Fiche idée n°1 Lombard, Logallo.pdf

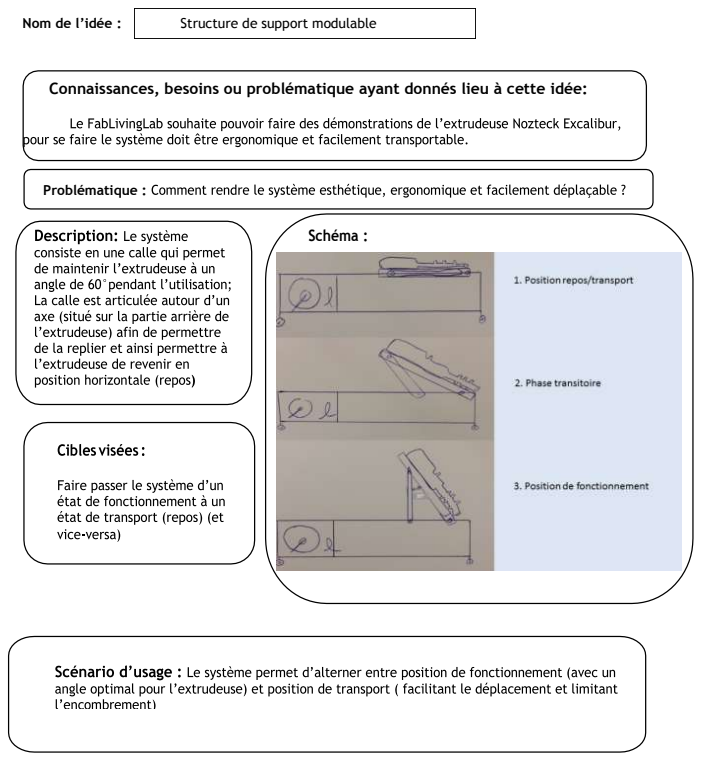
[picture p469: page 1]
Problématique :; Schéma :

Nom de l’idée :

Structure de support modulable

Connaissances, besoins ou problématique ayant donnés lieu à cette idée:
