LF2L/Green-FabLab/(commit log)

2018-10-03 Arduino Nicolas - Maxime
2018-10-10 Structure CAD
    [Assemblageextrudeuse - alimentation 3-1 biele-1.STL, Assemblageextrudeuse - alimentation 3-1 bouchon-1.STL, Assemblageextrudeuse - alimentation 3-1 disque-1.STL, Assemblageextrudeuse - alimentation 3-1 moteur avec disque-1.STL, Assemblageextrudeuse - alimentation 3-1 plaque de montage-1.STL, Assemblageextrudeuse - alimentation 3-1 tremie-1.STL, Assemblageextrudeuse - boite transport extrudeuse ba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]
2018-10-18 Functional Analysis Extrusion process
2018-10-18 funtional analysis extrusion
2019-01-22 CAD Nicolas Maxime
    [17_mm_Wrench.stl, 1_Winch_v30_Bolzen_1_Body1.stl, 1_Winch_v30_Koerper_1_Body1.stl, 1_Winch_v30_Kurbel_1_Body1.stl, 1_Winch_v30_Ratsche_1_Body1.stl, 1_Winch_v30_Scheibe_1_Body1.stl, 1_Winch_v30_Schraube_1_Body1.stl, 1_Winch_v30_Spule_oben_1_Body1.stl]
